MXDfc/ShanghaiTech_EE114-Embedded-Systems/Lab6/WHEELTEC L150 避障巡线雷达小车资料/WHEELTEC L150 避障巡线雷达小车附送资料_V2.8_2025.05.15/1.使用与开发教程视频/4.主板原理图/反面.JPG

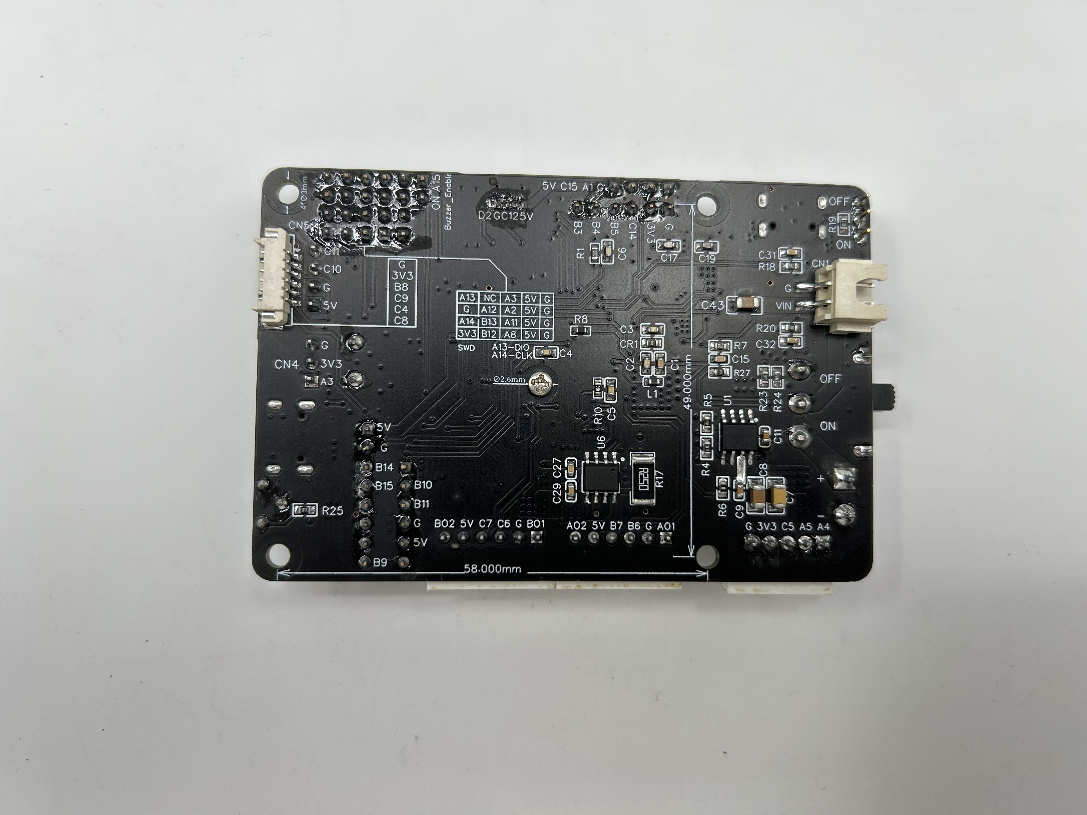
Lab6/WHEELTEC L150 避障巡线雷达小车资料/WHEELTEC L150 避障巡线雷达小车附送资料_V2.8_2025.05.15/1.使用与开发教程视频/4.主板原理图/反面.JPG
