MXDfc/ShanghaiTech_EE114-Embedded-Systems/README.md

# ShanghaiTech_EE114-Embedded-Systems
Class repository for Shanghaitech EE114 Embedded Systems, mainly contain code for labs and flip-class

This repository is built in 2025-2026 schoolyear Spring semester (2026Spring). The author is not responsible for any inapplicability of the code resulting from subsequent course updates.

Most of the code in this repository are created by AI agents. The code is verified useful on actual devices. Information of the devices used in this semester will be updated in related folders.
