MXDfc/ShanghaiTech_EE114-Embedded-Systems/Lab7and8/LAB7-8 BlueTooth.pdf

## Lab：Using Bluetooth to control

## the movement of the car

Install the app on your phone. This app recognizes Bluetooth modules named BT04 or WHEELTEC and connects them.
Experimental content

Students use an app connected to a Bluetooth module to control the movement of the car, which includes forward, backward, turning, and spinning in place.

Firstly, students should ensure a successful Bluetooth connection.

Secondly, it is necessary to ensure the accuracy of PWM control for the driving motor.

Finally, ensure safety before opening the motion control button of the car. Once the car is damaged, it will not be able to complete the subsequent experimental content.

Due to communication delay, please ensure that the small car is not too fast.
