MXDfc/ShanghaiTech_EE114-Embedded-Systems/Basic Data and Slides/slides/Lect9-10_A Complete CPU & 8051 Review.pdf

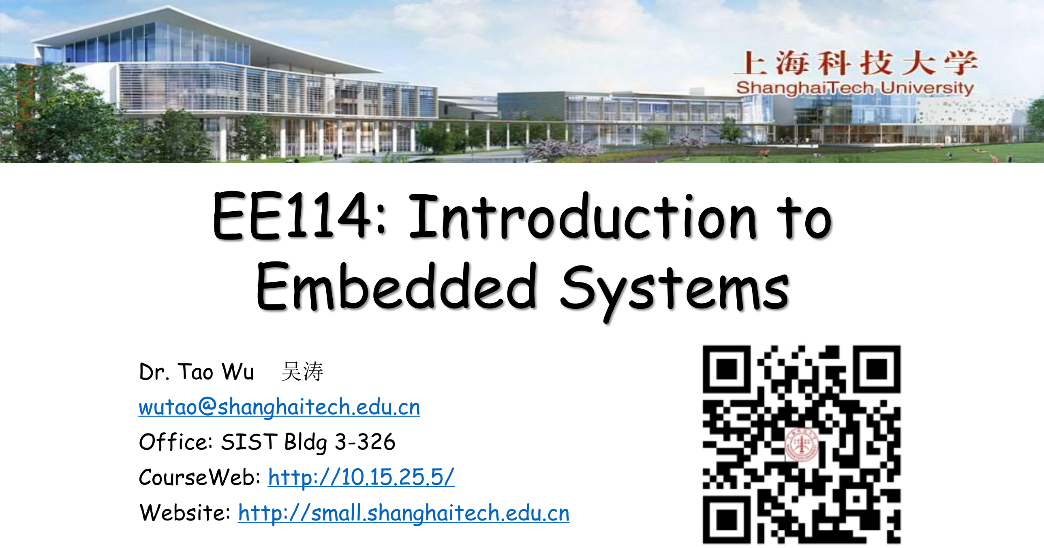
[picture p59: page 1]

EE114 Embedded System -> Lecture 9-10 A Complete CPU & Review

# EE114: Introduction to Embedded Systems

## Dr. Tao Wu 吴涛 wutao@shanghaitech.edu.cn Office: SIST Bldg 3-326 CourseWeb: http://10.15.25.5/ (http://10.15.25.5/EE224_18Fall/Index.htm) Website: http://small.shanghaitech.edu.cn

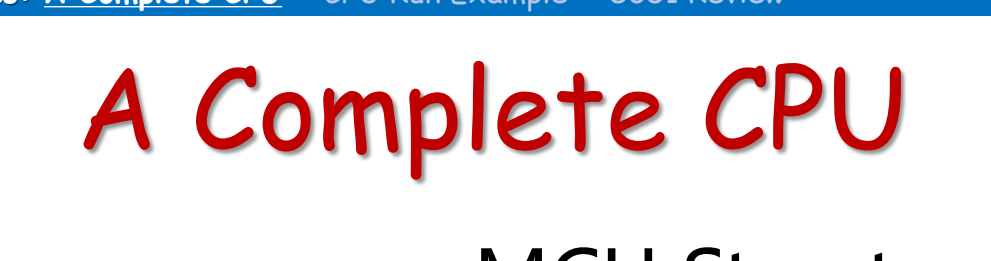
[picture p60: figure]
A Complete CPU

# - MCU Structure

# - The CPU

## - Registers file （寄存器组） - Instruction latch/decode/branch （指令） - Stack（栈） - Interrupt（中断） - Clock/Reset（时钟/复位）

# - Memory - Bus - Peripheral

Progress: A Complete CPU >> CPU Run Example >> 8051 Review

# A Complete CPU – Video 23’

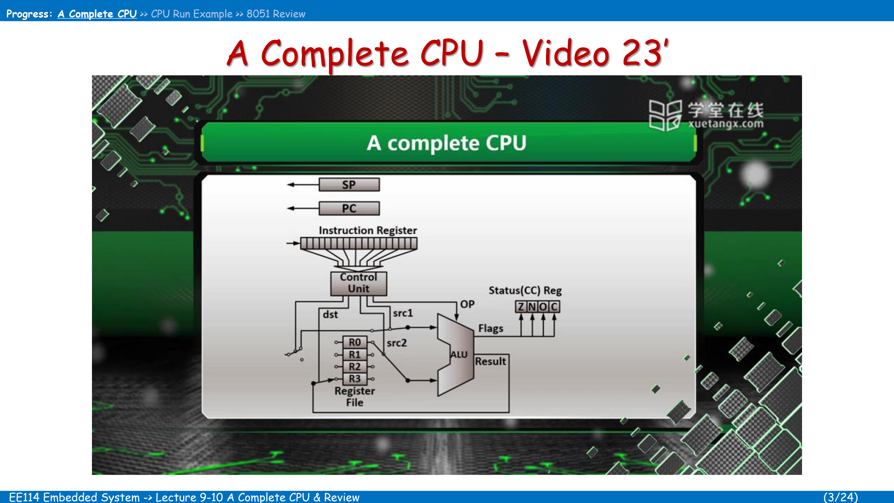
[picture p61: page 3]

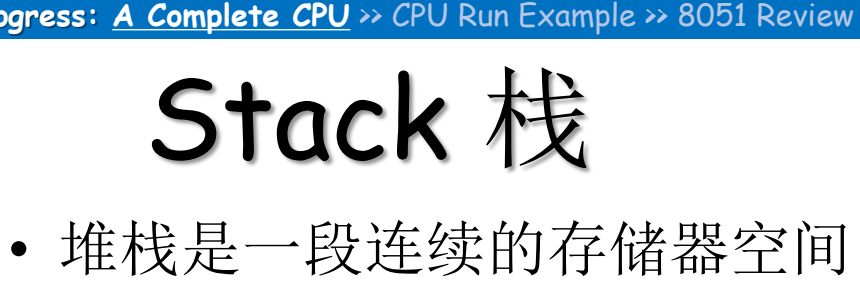
[picture p62: figure]
• 堆栈是一段连续的存储器空间; Stack 栈

## - 堆栈按照后入先出的方式工作(Last In First Out)

## - 只能向/从堆栈的顶部加入或取出数据 - 顶端位置通过堆栈指针寄存器确定(SP，Stack Pointer) - 两种基本的操作方式: 推入PUSH: 将内容加入到堆栈顶端 取出PULL : 将堆栈顶端的内容取出

## - 对于大多数CPU而言，

## “顶端”是指低位的地址空间； 但 8051是向上生长型的堆栈 - 堆栈容量不超过（256-8）字节，单片机复位后SP的值为07H，SP是入栈递增 - 汇编程序可以使用堆栈来保存局部变量，寄存器值 - C语言编译器使用堆栈来完成参数传递和返回值传递 -> C语言的函数调用

## - CPU硬件 使用堆栈 来保存返回地址和寄存器上下文 (register context)

High addr

Low addr

0x13
0x12
0x11
0x10

0x10 is the first pushed item 0x13 is the last pushed item

## TOP

# - 堆Heap：是一个进程开启以后，系统分配给它的空间，一般这个空间是 全局的，系统中所有动态分配的对象（比如指针）都是在这个空间上分 配 。 堆 里 的 数 据 是 有 数 据 结 构 的 ， 其 空 间 占 用 是 不 连 续 的 。 在没有OS的嵌入式系统中，通常不使用堆。

# - 栈Stack：是一个线程维护的一个先进后出的数据结构，主要用于静态 变量的 分配及维护程序各个函数调用时使用。栈里的内容是没有数据结 构的，其空间占用是连续的。栈是微处理器的必要特性，是支持高级语 言编程的前提。

xx
xx
xx
xx
xx

0x1FFB
0x1FFC
0x1FFD
0x1FFE
0x1FFF

SP = undefined
PC = 0x3006
A = 0x34
B = 0x56

0x3005: NOP
0x3006: LDS $2000
0x3008: PSHA
0x3009: PSHB
0x300A: JSR SubFunc
0x300C: PULLA
0x300D: PULLB
SubFunc: 0x4050: NOP
0x4052: RTS

current executed instruction current stack pointer

NOP: no operation, do nothing
LDS : load stack pointer with a value
PSHx: push the contains of register 'x' into stack PULLx: pull from the stack and put in register 'x' JSR : jump to subroutine
RTS : return from subroutine

Register file after this instruction

0x3005: NOP
0x3006: LDS $2000
0x3008: PSHA
0x3009: PSHB
0x300A: JSR SubFunc
0x300C: PULLA
0x300D: PULLB
SubFunc: 0x4050: NOP
0x4052: RTS

xx
xx
xx
xx
xx

0x1FFB
0x1FFC
0x1FFD
0x1FFE
0x1FFF

SP = 0x2000
PC = 0x3008
A = 0x34
B = 0x56

current executed instruction current stack pointer

Register file after this instruction

NOP: no operation, do nothing
LDS : load stack pointer with a value
PSHx: push the contains of register 'x' into stack PULLx: pull from the stack and put in register 'x' JSR : jump to subroutine
RTS : return from subroutine

0x3005: NOP
0x3006: LDS $2000
0x3008: PSHA
0x3009: PSHB
0x300A: JSR SubFunc
0x300C: PULLA
0x300D: PULLB
SubFunc: 0x4050: NOP
0x4052: RTS

xx
xx
xx
xx
0x34

0x1FFB
0x1FFC
0x1FFD
0x1FFE
0x1FFF

SP = 0x1FFF
PC = 0x3009
A = 0x34
B = 0x56

current executed instruction current stack pointer

Register file after this instruction

NOP: no operation, do nothing
LDS : load stack pointer with a value
PSHx: push the contains of register 'x' into stack PULLx: pull from the stack and put in register 'x' JSR : jump to subroutine
RTS : return from subroutine

xx
xx
xx
0x56
0x34

0x1FFB
0x1FFC
0x1FFD
0x1FFE
0x1FFF

SP = 0x1FFE
PC = 0x300A
A = 0x34
B = 0x56

current executed instruction current stack pointer

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

Register file after this instruction

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

xx
0x30
0x0C
0x56
0x34

0x1FFB
0x1FFC
0x1FFD
0x1FFE
0x1FFF

SP = 0x1FFC
PC = 0x4050
A = 0x34
B = 0x56

current executed instruction current stack pointer

Register file after this instruction

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

xx
0x30
0x0C
0x56
0x34

0x1FFB
0x1FFC
0x1FFD
0x1FFE
0x1FFF

SP = 0x1FFC
PC = 0x4052
A = 0x34
B = 0x56

current executed instruction current stack pointer

Register file after this instruction

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

xx
0x30
0x0C
0x56
0x34

0x1FFB
0x1FFC
0x1FFD
0x1FFE
0x1FFF

SP = 0x1FFE
PC = 0x300C
A = 0x34
B = 0x56

current executed instruction current stack pointer

Register file after this instruction

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

xx
0x30
0x0C
0x56
0x34

0x1FFB
0x1FFC
0x1FFD
0x1FFE
0x1FFF

SP = 0x1FFF
PC = 0x300D
A = 0x56
B = 0x56

current executed instruction current stack pointer

Register file after this instruction

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

xx
0x30
0x0C
0x56
0x34

0x1FFB
0x1FFC
0x1FFD
0x1FFE
0x1FFF

SP = 0x2000
PC = 0x300E
A = 0x56
B = 0x34

current executed instruction current stack pointer

Register file after this instruction

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

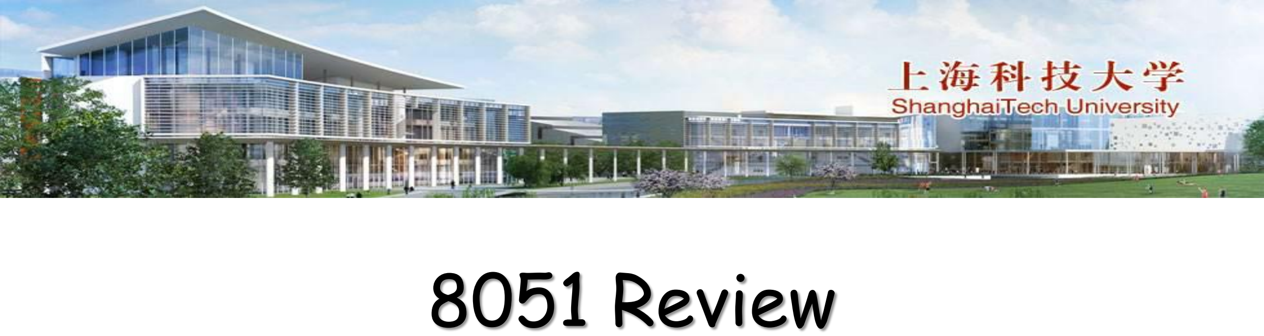
[picture p63: page 15]

# 8051 Review

# MCS-8051单片机主要功能方框图

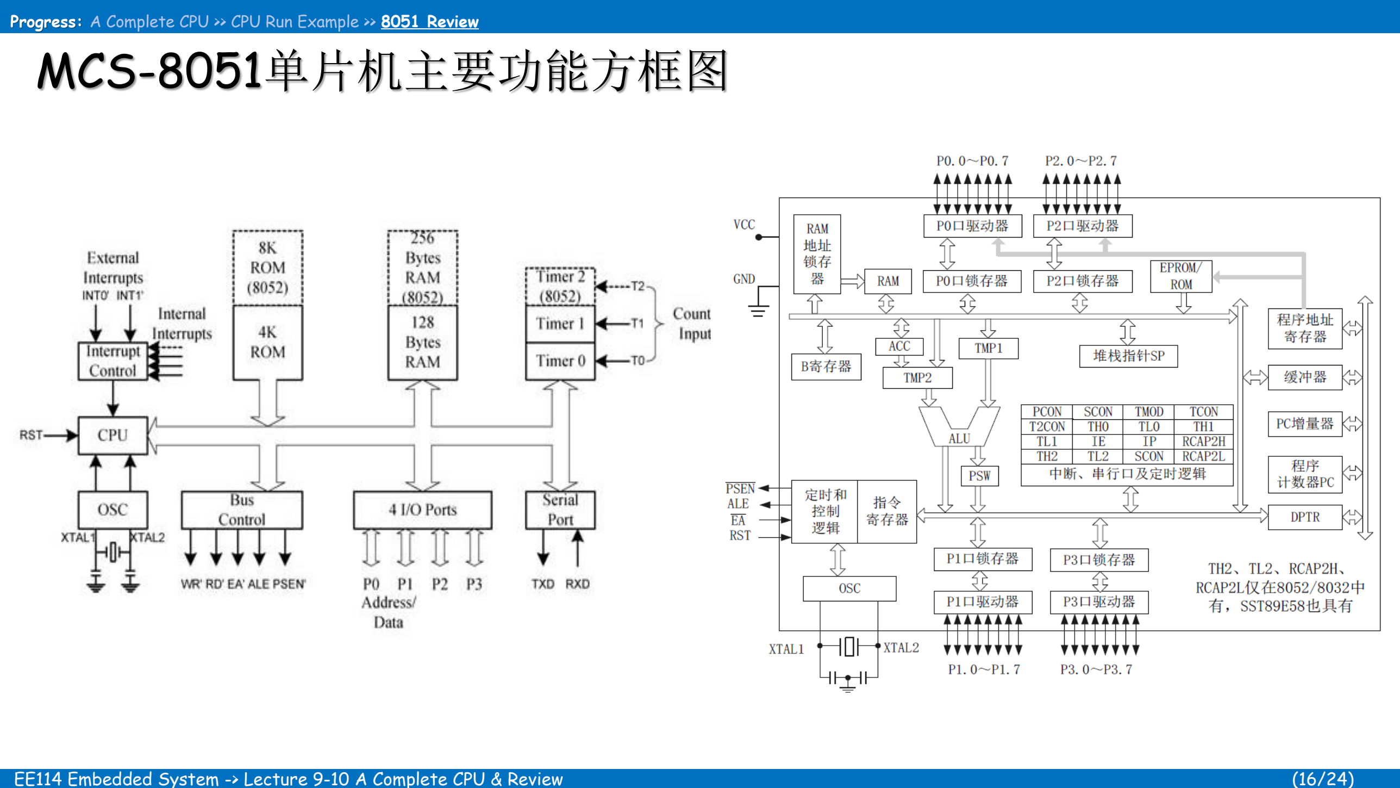
[picture p64: page 16]

# How it runs

## Clock

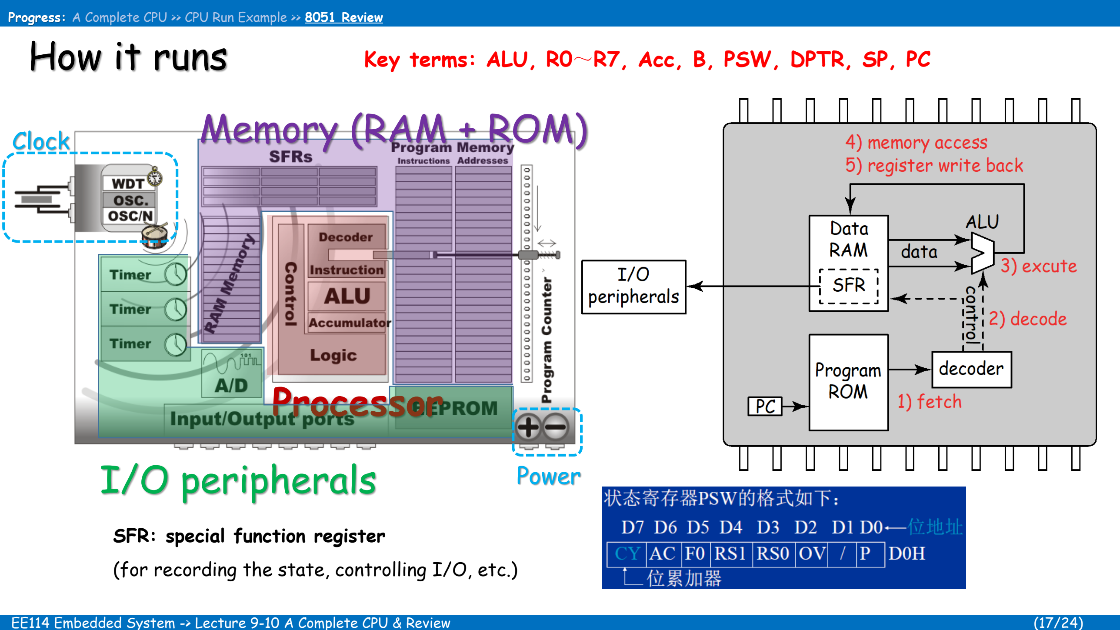
[picture p65: page 17]

SFR: special function register
(for recording the state, controlling I/O, etc.)

## Program statμs word (PSW)

# Processor

# Memory (RAM + ROM)

I/O peripherals | Power

## Key terms: ALU, R0～R7, Acc, B, PSW, DPTR, SP, PC

# - Ports 0 has open-drain outputs

(“true” bidirectional).

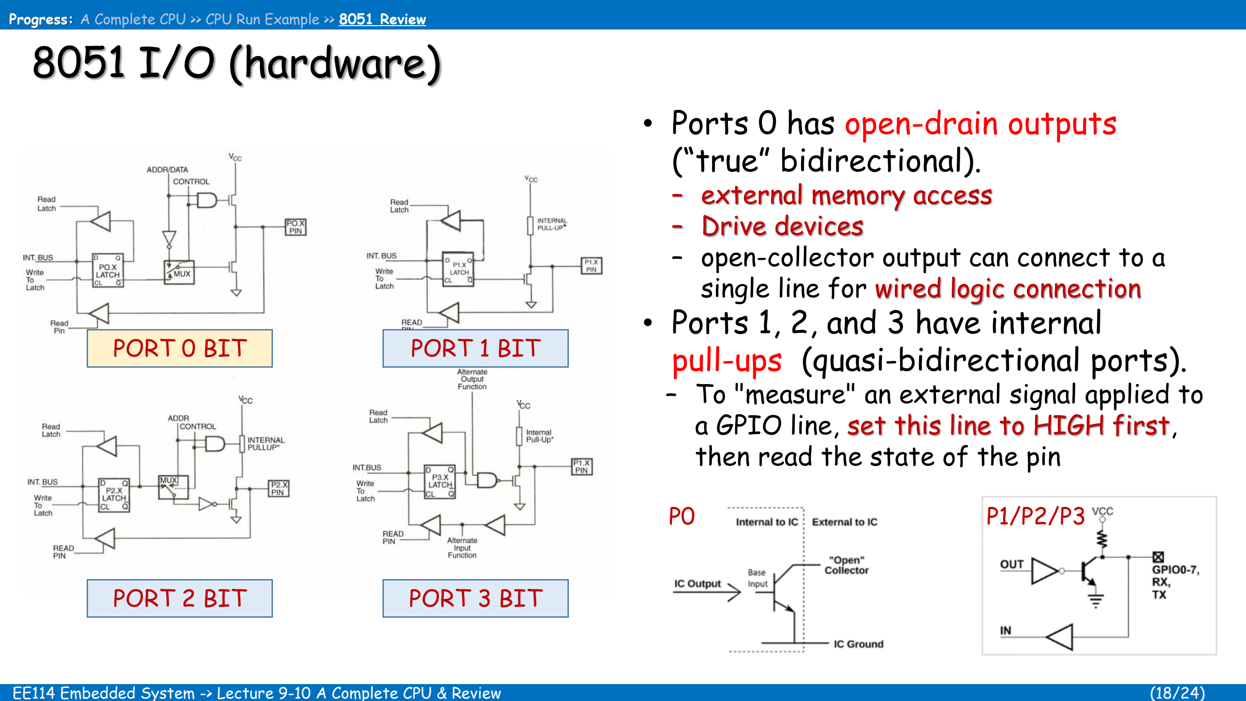
[picture p66: page 18]

## – external memory access – Drive devices – open-collector output can connect to a single line for wired logic connection

# - Ports 1, 2, and 3 have internal

pull-ups (quasi-bidirectional ports).

## – To "measure" an external signal applied to

a GPIO line, set this line to HIGH first,

## then read the state of the pin

# 8051 I/O (hardware)

PORT 0 BIT | PORT 1 BIT
PORT 2 BIT | PORT 3 BIT
P0 | P1/P2/P3

# 8051 Memory Mapping

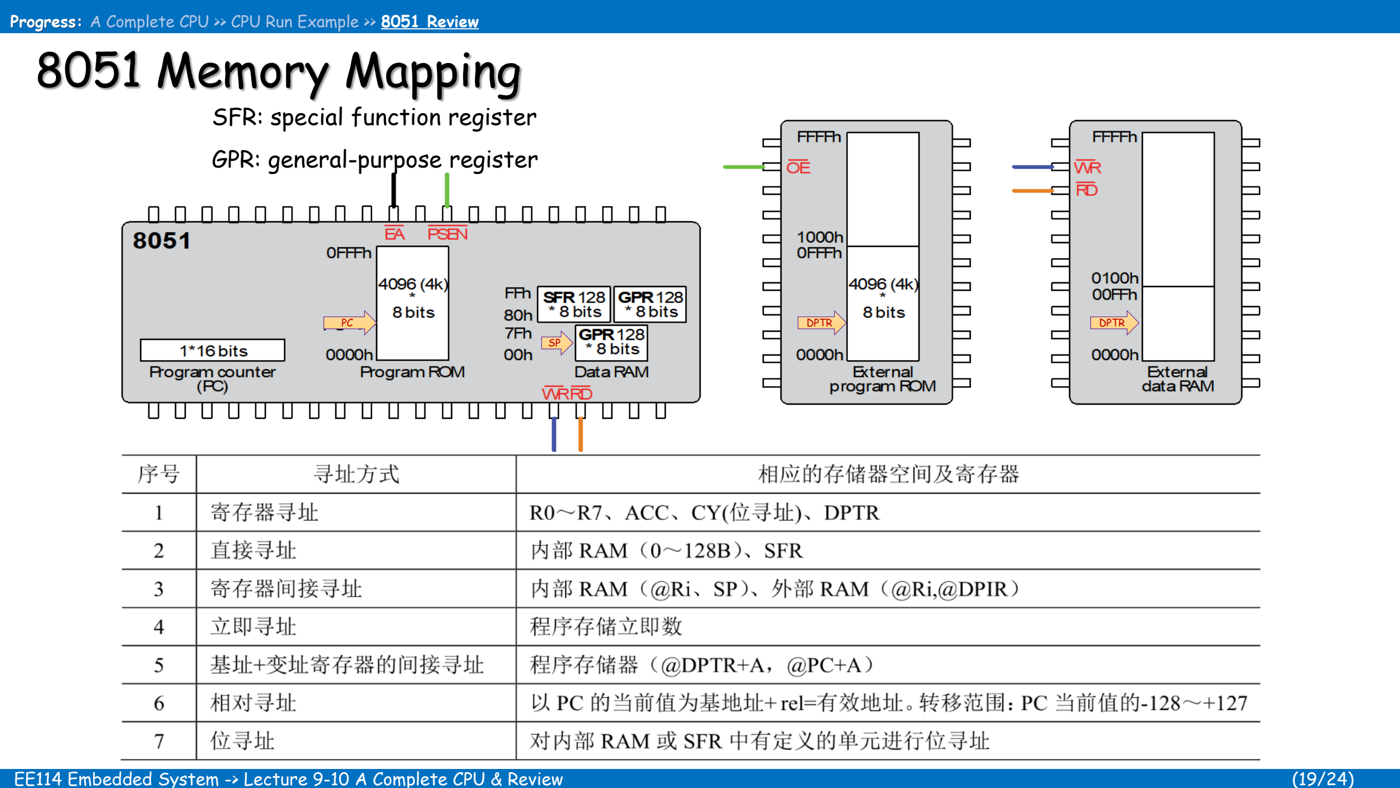
[picture p67: page 19]

SFR: special function register GPR: general-purpose register

PC

SP

DPTR | DPTR

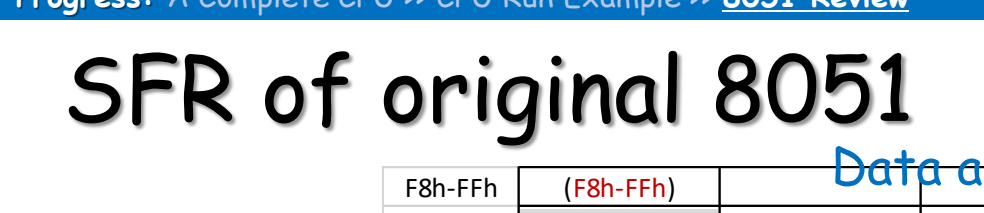
[picture p68: figure]
F8h-FFh; (F8h-FFh); SFR of original 8051

F0h-F7H | B (F0h-F7H)
E8h-EFh | (E8h-EFh) | | | CPU
E0h-E7h | ACC (E0h-E7h)
D8h-DFh | (D8h-DFh) | | Interrupt control
D0h-D7h | PSW (D0h-D7h)
C8h-CFh | (C8h-CFh) | | | I/O ports
C0h-C7h | (C0h-C7h)
B8h-BFh | IP (B8h-BFh) | | | UART
B0h-B7h | P3 (B0h-B7h)
A8h-AFh | IE (A8h-AFh) | | | Timers
A0h-A7h | P2 (A0h-A7h)
98h-9Fh | SCON (98h-9Fh) | SBUF
90h-97h | P1 (90h-97h)
88h-8Fh | TCON (88h-8Fh) | TMOD | TL0 | TL1 | TH0 | TH1
80h-87h | P0 (80h-87h) | SP | DPL | DPH | | | | PCON PCON

30h-7Fh

20h-2Fh | 40h-47h | 48h-4Fh | 50h-57h | 58h-5Fh | 60h-67h | 68h-6Fh | 70h-77h | 78h-7Fh
| 00h-07h | 08-0Fh | 10h-17h | 18h-1Fh | 20h-27h | 28-2Fh | 30h-37h | 38h-3Fh
18h-1Fh | R0 | R1 | R2 | R3 | R4 | R5 | R6 | R7 | Bank 3
10h-17h | R0 | R1 | R2 | R3 | R4 | R5 | R6 | R7 | Bank 2
08h-0Fh | R0 | R1 | R2 | R3 | R4 | R5 | R6 | R7 | Bank 1
00h-07h | R0 | R1 | R2 | R3 | R4 | R5 | R6 | R7 | Bank 0

128
SFR

80
General
purpose
registers

16 bit-addressable

## Data and stack pointers

Red address: bit addresses Black address: byte addresses

# Connecting external RAM/ROM

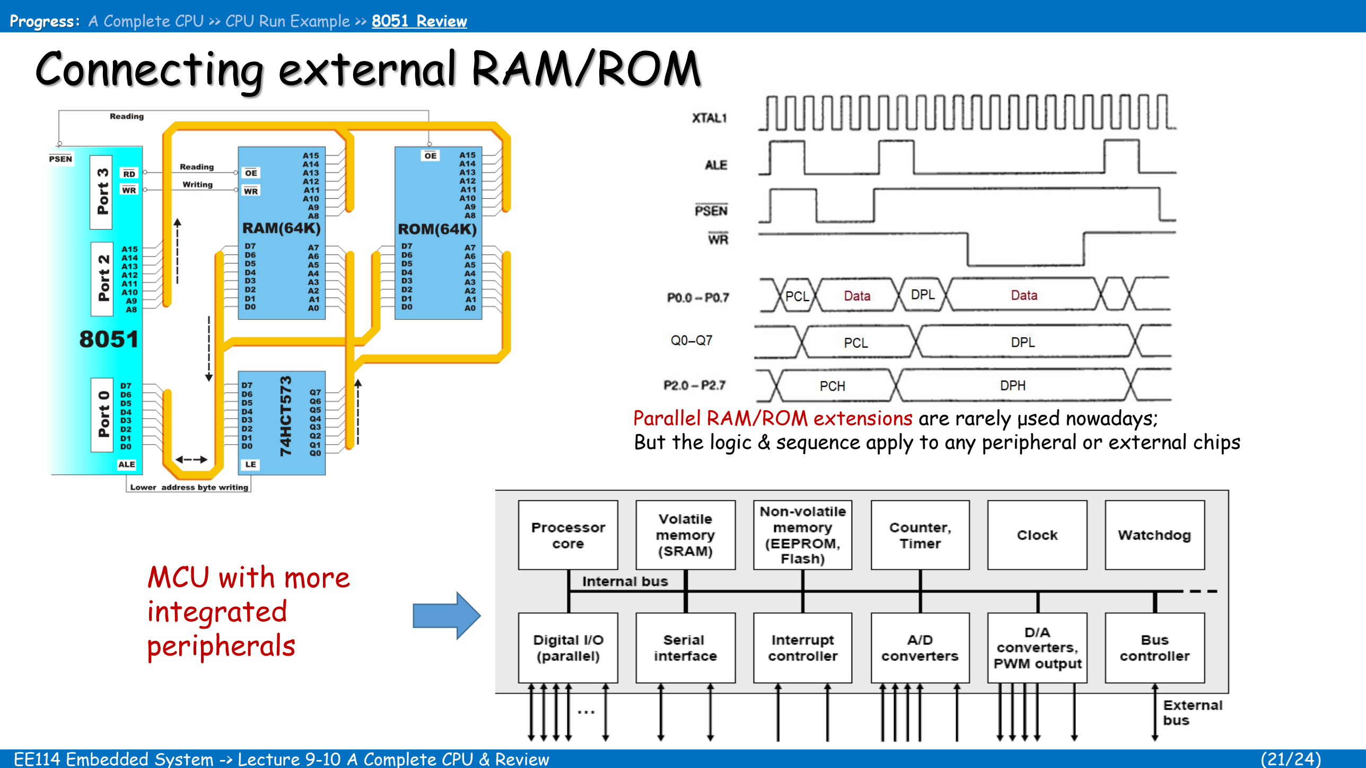
[picture p69: page 21]

Parallel RAM/ROM extensions are rarely μsed nowadays;
But the logic & sequence apply to any peripheral or external chips

## MCU with more integrated peripherals

# - There are two 16 bits timers/counters in 8051

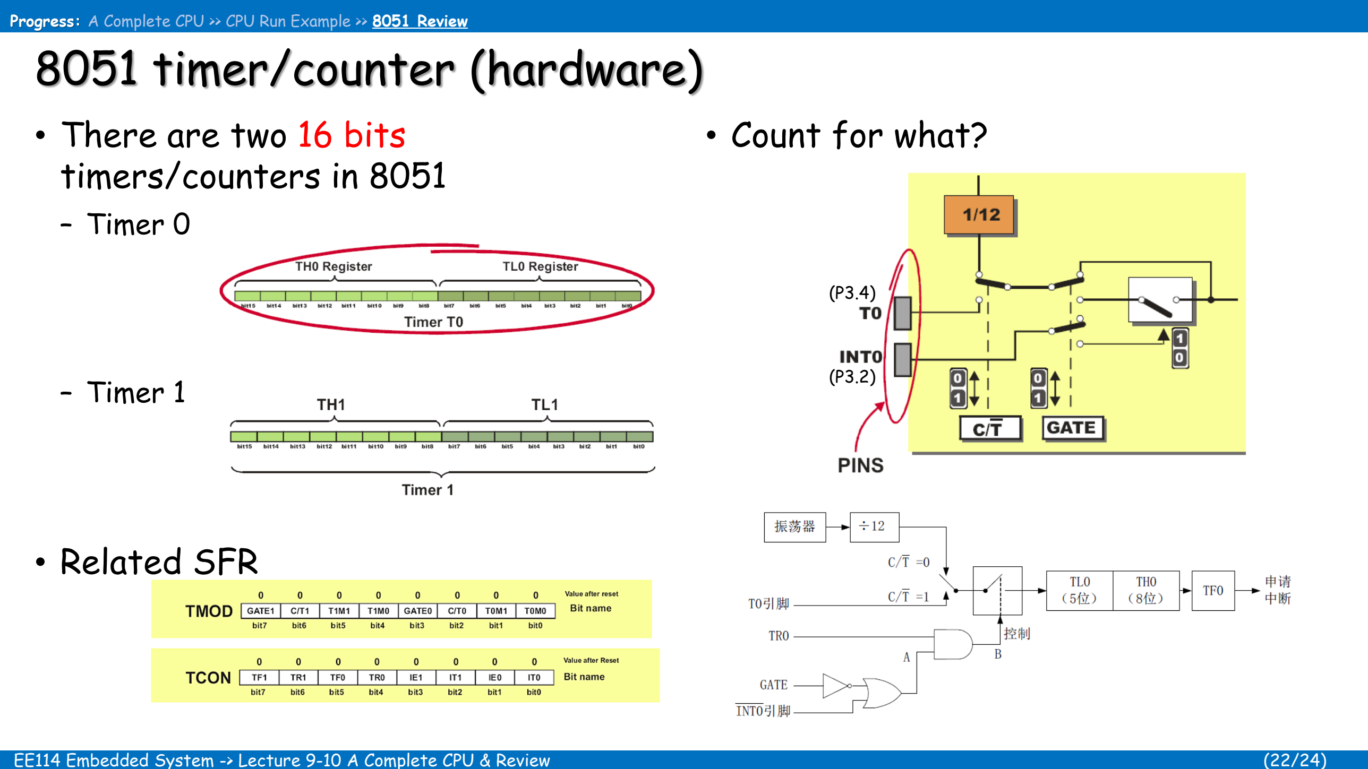
[picture p70: page 22]

## – Timer 0

## – Timer 1

# - Related SFR

# - Count for what?

# 8051 timer/counter (hardware)

(P3.2)

(P3.4)

# 8051 interrupts (hardware)

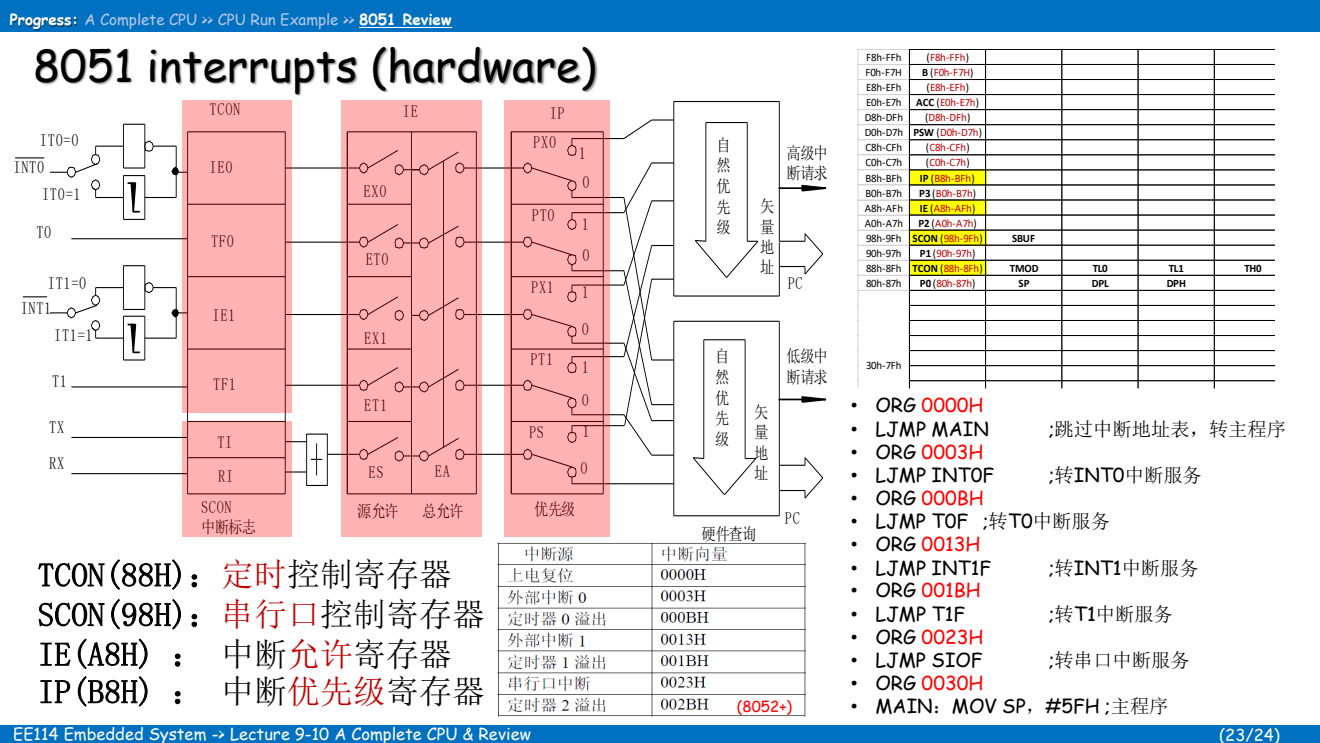
[picture p71: page 23]
高级中 断请求; 断请求; 低级中; SCON 中断标志; TCON; INT1; INT0; 源允许; 总允许; 优先级; 硬件查询; F8h-FFh; (F8h-FFh); E8h-EFh; (E8h-EFh); ACC (E0h-E7h); D8h-DFh; (D8h-DFh); PSW (D0h-D7h); C8h-CFh; (C8h-CFh); B8h-BFh; IP (B8h-BFh); A8h-AFh; IE (A8h-AFh); SCON (98h-9Fh); SBUF; TCON (88h-8Fh); TMOD; DPL; DPH; • ORG 0000H; • LJMP MAIN; ;跳过中断地址表，转主程序; • ORG 0003H; • LJMP INT0F; ;转INT0中断服务; • ORG 000BH • LJMP T0F ;转T0中断服务 • ORG 0013H; • LJMP INT1F; ;转INT1中断服务; • ORG 001BH; • LJMP T1F; ;转T1中断服务; • ORG 0023H; • LJMP SIOF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

## - Wired communication – Parallel: CPU and RAM

# Communication Summary

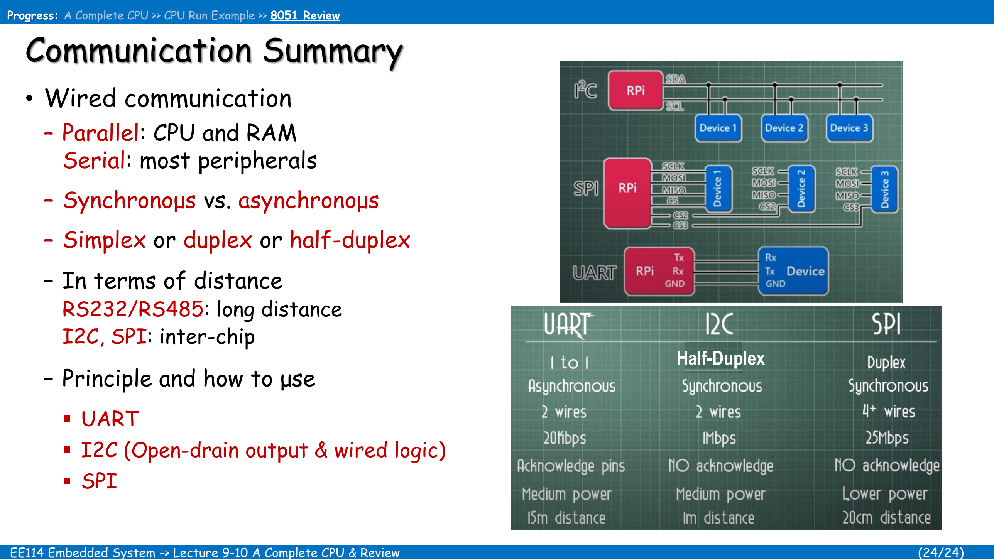
[picture p72: page 24]

EE114 Embedded System

-> Lecture 9

-10 A Complete CPU & Review

## Serial: most peripherals

## – Synchrono

μ

## s vs. asynchrono

μ

s

## – Simplex or duplex or half

## -duplex

## – In terms of distance

## RS232/RS485: long distance I2C, SPI: inter

## -chip

## – Principle and how to

## μse

## - UART ▪ I2C (Open -drain output & wired logic) - SPI

Half

-Duplex
