MXDfc/ShanghaiTech_EE114-Embedded-Systems/Lab2and3/Device Data/AI语音交互/3.芯片资料&技术参数/2.技术参数/一体式语音交互模块技术参数.pdf

# 一体式语音交互模块技术参数

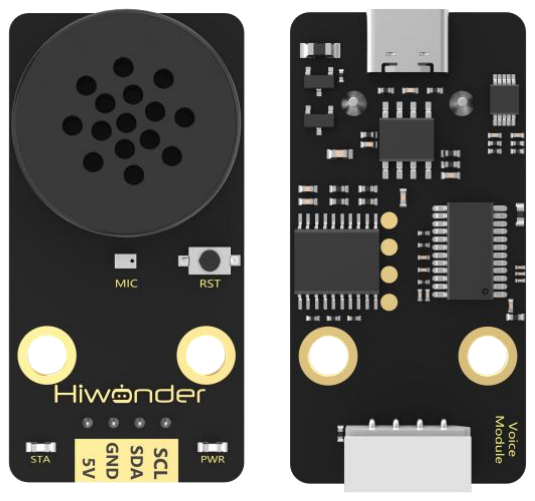
[picture p107: figure]

产品尺寸 | 48*24*10.5mm | 产品重量 | 10g
语音芯片型号 | CI1302 | IIC 接口 | 1 个
Type-C 串口 | 1 个 | 工作电压 | 5V
CPU 主频 | 可达 220MHz | RAM 容量 | 640KByte
FLASH 容量 | 2MByte | 工作温度 | 常温
