MXDfc/ShanghaiTech_EE114-Embedded-Systems/Lab4and5/Device Data/LAB4-5 MPU6050(1)/LAB4-5 MPU6050/姿态传感器资料/四元数与欧拉角的转换.pdf

四元数与欧拉角（Yaw、Pitch、Roll）的转换
目录

0、简介

### 一、四元数的定义 二、欧拉角到四元数的转换

2.1 公式：
2.2 code:

### 三、四元数到欧拉角的转换

3.1 公式
3.2 code:

### 3.3 四元素到旋转矩阵转换 四. 奇点 五. 矢量旋转

证明：

### 六 . 其他参考

七 python 转换

### 7.1 四元素欧拉角互相转换

7.2 旋转矩阵<->欧拉角 py
八 Eigen transform

### 8.1 欧拉角到四元素 四元素得到yaw 四元素到旋转向量 旋转轴向量到四元素

Eigen 转换函数

### 九 旋转矩阵与欧拉角

0、简介

四元数与欧拉角之间的转换 (https://en.wikipedia.org/wiki/Conversion_between_quaternions_and_Euler_angles)

### 百度百科四元素 (http://baike.baidu.com/link)

在3D图形学中，最常用的旋转表示方法便是四元数和 欧拉角 (https://so.csdn.net/so/search?q=%E6%AC%A7%E6%8B%89%E8%A7%92&spm=1001.2101.3001.7020) ，比起矩阵来具有节省存储空间和方

### 便插值的优点。

### 本文主要归纳了两种表达方式的转换，计算公式采用3D笛卡尔坐标系：

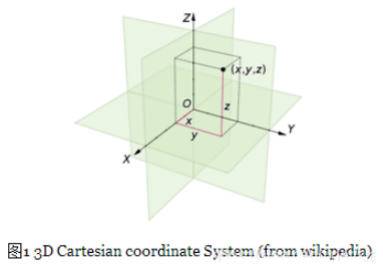
[picture p108: figure]

### 定义 ， ， 分别为绕Z轴、Y轴、X轴的旋转角度，如果用Tait-Bryan angle表示，分别为Yaw、

Pitch、Roll。

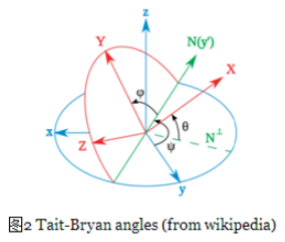
[picture p109: figure]

# 一、四元数的定义

### 通过旋转轴和绕该轴旋转的角度可以构造一个四元数：

### 利用欧拉角也可以实现一个物体在空间的旋转，它按照既定的顺序，如依次绕z,y,x分别旋转一个固 定角度，使用yaw，pitch，roll分别表示物体绕,x,y,z的旋转角度，记为 ， ， ，可以利用三个四元 数依次表示这三次旋转，即：

# 二、欧拉角到四元数的转换

# 2.1 公式：

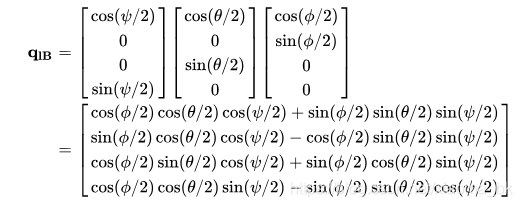
[picture p110: figure]

# 2.2 code:

struct Quaternion
{
double w, x, y, z;
};

Quaternion ToQuaternion(double yaw, double pitch, double roll) // yaw (Z), pitch (Y) {
// Abbreviations for the various angular functions
double cy = cos(yaw * 0.5);
double sy = sin(yaw * 0.5);
double cp = cos(pitch * 0.5);
double sp = sin(pitch * 0.5); double cr = cos(roll * 0.5); double sr = sin(roll * 0.5);

Quaternion q;
q.w = cy * cp * cr + sy * sp * sr; q.x = cy * cp * sr - sy * sp * cr;

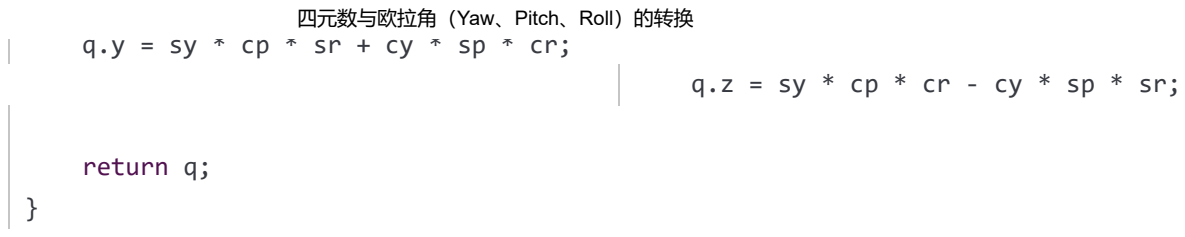
[picture p111: figure]
return q;

# 三、四元数到欧拉角的转换

# 3.1 公式

### 可以从四元数通过以下关系式获得欧拉角：

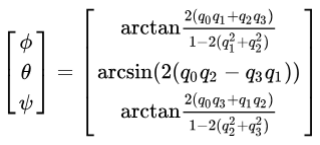
[picture p112: figure]

arctan和arcsin的结果是 | ，这并不能覆盖所有朝向(对于 角 | 的取值范围已经满

# 3.2 code:

#define _USE_MATH_DEFINES

#include <cmath>

struct Quaternion {
double w, x, y, z;
};

struct EulerAngles {
double roll, pitch, yaw;
};

EulerAngles ToEulerAngles(Quaternion q) { EulerAngles angles;

3.3 四元素到旋转矩阵 (https://so.csdn.net/so/search?q=%E6%97%8B%E8%BD%AC%E7%9F%A9%E9%98%B5&spm=1001.2101.3001.7020) 转换

### 或等效地，通过齐次表达式：

# 四. 奇点

### 当螺距接近±90°（南北极）时，必须意识到欧拉角参数化的奇异性。这些情况必须特别处理。这种 情况的通用名称是万向节锁。

处理奇异点的代码可从以下网站获取：www.euclideanspace.com

# 五. 矢量旋转

### 定义四元素的尺度 和向量 ，有

// roll (x-axis rotation)
double sinr_cosp = 2 * (q.w * q.x + q.y * q.z); double cosr_cosp = 1 - 2 * (q.x * q.x + q.y * q.y); angles.roll = std::atan2(sinr_cosp, cosr_cosp);

// pitch (y-axis rotation)
double sinp = 2 * (q.w * q.y - q.z * q.x);
if (std::abs(sinp) >= 1)
angles.pitch = std::copysign(M_PI / 2, sinp); // use 90 degrees if out of ra else
angles.pitch = std::asin(sinp);

// yaw (z-axis rotation)
double siny_cosp = 2 * (q.w * q.z + q.x * q.y); double cosy_cosp = 1 - 2 * (q.y * q.y + q.z * q.z); angles.yaw = std::atan2(siny_cosp, cosy_cosp);

return angles;
}

### 请注意，通过定义欧拉旋转的四元数 来旋转三维矢量 的规范方法是通过公式：

这儿： | 是包含嵌入向量 的四元数，
是共轭四元数， (https://en.wikipedia.org/wiki/Quaternion#Conjugation.2C_the_norm.2C_and_reciprocal)

### 在计算实现中，这需要两个四元数乘法。一种替代方法是应用一对关系：

### ：表示三维矢量叉积。这涉及较少的乘法，因此计算速度更快。数值测试表明，对于矢量旋转，后 一种方法可能比原始方法快30％[4]。

证明：

### 标量和矢量部分的四元数乘法的一般规则由下式给出：

利用这种关系 | 可以找到：

### 并替换为三乘积：

### 可得到：

在定义 | 时，可以按标量和矢量部分来表示：

# 六 . 其他参考

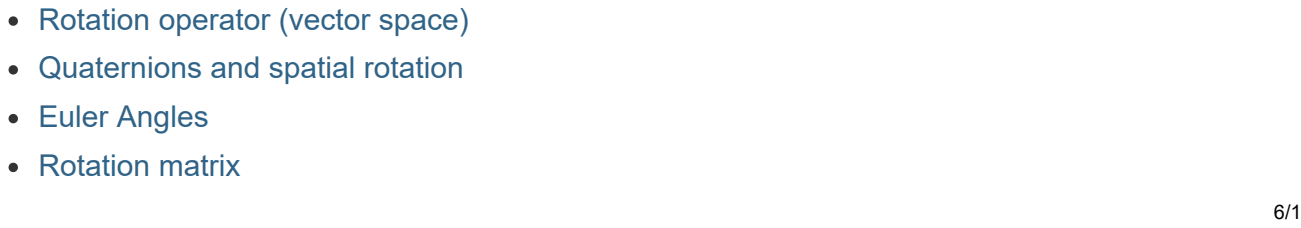
[picture p113: figure]
Rotation operator (vector space) Quaternions and spatial rotation Euler Angles Rotation matrix

# 七 python 转换

# 7.1 四元素欧拉角互相转换

def EulerAndQuaternionTransform( intput_data): """
四元素与欧拉角互换
"""
data_len = len(intput_data) angle_is_not_rad = False

if data_len == 3:
r = 0
p = 0
y = 0
if angle_is_not_rad: # 180 ->pi
r = math.radians(intput_data[0]) p = math.radians(intput_data[1]) y = math.radians(intput_data[2]) else:
r = intput_data[0]
p = intput_data[1]
y = intput_data[2]

sinp = math.sin(p/2)
siny = math.sin(y/2)
sinr = math.sin(r/2)

cosp = math.cos(p/2)
cosy = math.cos(y/2)
cosr = math.cos(r/2)

w = cosr*cosp*cosy + sinr*sinp*siny x = sinr*cosp*cosy - cosr*sinp*siny y = cosr*sinp*cosy + sinr*cosp*siny z = cosr*cosp*siny - sinr*sinp*cosy return [w,x,y,z]

elif data_len == 4:

w = intput_data[0]
x = intput_data[1]
y = intput_data[2]
z = intput_data[3]

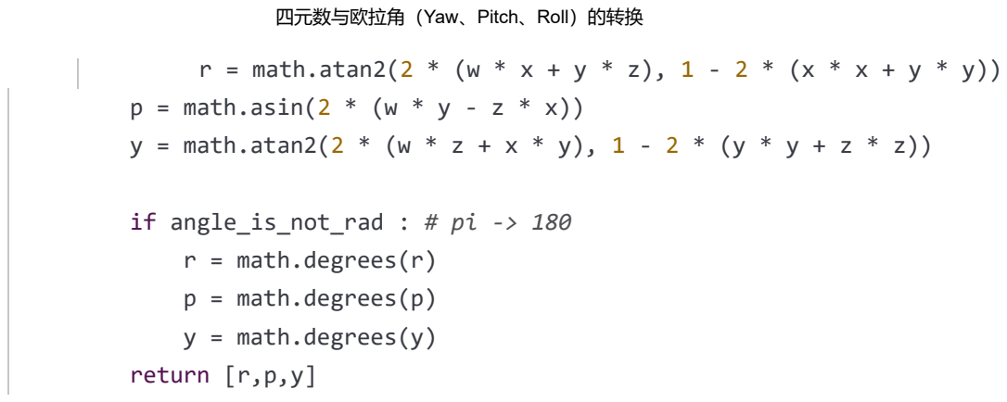
[picture p114: figure]
p = math.asin(2 * (w * y - z * x)); if angle_is_not_rad : # pi -> 180 r = math.degrees(r) p = math.degrees(p) y = math.degrees(y) return [r,p,y]

# 7.2 旋转矩阵<->欧拉角 py

r = math.atan2(2 * (w * x + y * z), 1 - 2 * (x * x + y * y))

y = math.atan2(2 * (w * z + x * y), 1 - 2 * (y * y + z * z))

import numpy as np
import math
import random

def isRotationMatrix(R) :
Rt = np.transpose(R)
shouldBeIdentity = np.dot(Rt, R)
I = np.identity(3, dtype = R.dtype)
n = np.linalg.norm(I - shouldBeIdentity) return n < 1e-6

def rotationMatrixToEulerAngles(R) :

assert(isRotationMatrix(R))
sy = math.sqrt(R[0,0] * R[0,0] + R[1,0] * R[1,0]) singular = sy < 1e-6

if not singular :
x = math.atan2(R[2,1] , R[2,2]) y = math.atan2(-R[2,0], sy)
z = math.atan2(R[1,0], R[0,0]) else :
x = math.atan2(-R[1,2], R[1,1]) y = math.atan2(-R[2,0], sy)
z = 0

return np.array([x, y, z])

def eulerAnglesToRotationMatrix(theta) :

R_x = np.array([[1, | 0, | 0 | ],
[0, | math.cos(theta[0]), -math.sin(theta[0]) ],

四元数与欧拉角（Yaw、Pitch、Roll）的转换_ | _ | _

c++:

])

R_y = np.array([[math.cos(theta[1]), 0, | math.sin(theta[1]) ],
[0, | 1, | 0 | ],
[-math.sin(theta[1]), 0, | math.cos(theta[1]) ]
])

R_z = np.array([[math.cos(theta[2]), -math.sin(theta[2]), 0],
[math.sin(theta[2]), math.cos(theta[2]), | 0],
[0, | 0, | 1]
])

R = np.dot(R_z, np.dot( R_y, R_x ))

return R

[0, math.sin(theta[0]), math.cos(theta[0]) ]

static Eigen::Vector3d R2ypr(const Eigen::Matrix3d &R) {
Eigen::Vector3d n = R.col(0);
Eigen::Vector3d o = R.col(1);
Eigen::Vector3d a = R.col(2);

Eigen::Vector3d ypr(3);
double y = atan2(n(1), n(0));
double p = atan2(-n(2), n(0) * cos(y) + n(1) * sin(y));
double r = atan2(a(0) * sin(y) - a(1) * cos(y), -o(0) * sin(y) + o(1) * cos( ypr(0) = y;
ypr(1) = p;
ypr(2) = r;

return ypr / M_PI * 180.0; }

template <typename Derived>
static Eigen::Matrix<typename Derived::Scalar, 3, 3> ypr2R(const Eigen::MatrixBa {
typedef typename Derived::Scalar Scalar_t;

Scalar_t y = ypr(0) / 180.0 * M_PI; Scalar_t p = ypr(1) / 180.0 * M_PI; Scalar_t r = ypr(2) / 180.0 * M_PI;

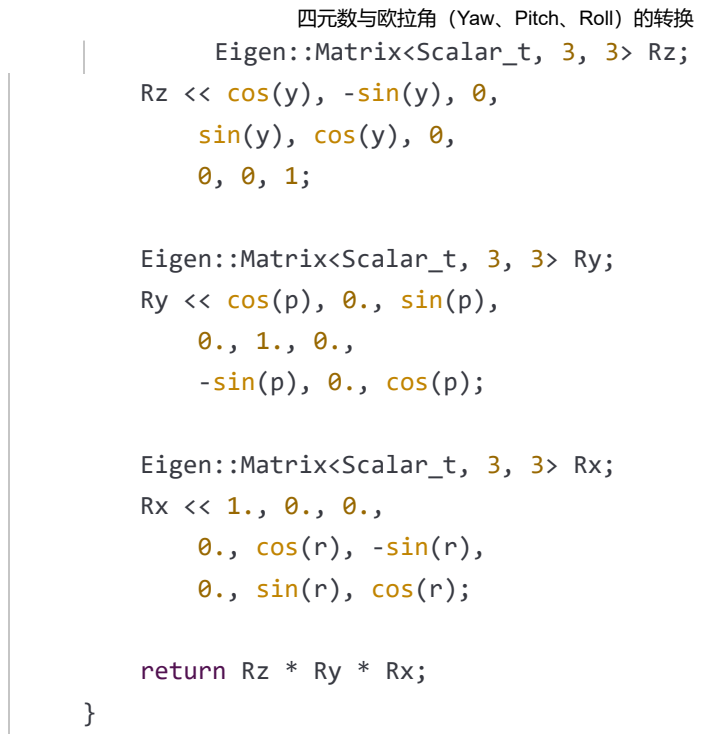
[picture p115: figure]
Eigen::Matrix<Scalar_t, 3, 3> Rz; Rz << cos(y), -sin(y), 0, sin(y), cos(y), 0, 0, 0, 1;; Eigen::Matrix<Scalar_t, 3, 3> Ry; Ry << cos(p), 0., sin(p), 0., 1., 0., -sin(p), 0., cos(p);; Eigen::Matrix<Scalar_t, 3, 3> Rx; Rx << 1., 0., 0., 0., cos(r), -sin(r), 0., sin(r), cos(r);; return Rz * Ry * Rx;

# 八 Eigen transform

## 8.1 欧拉角到四元素

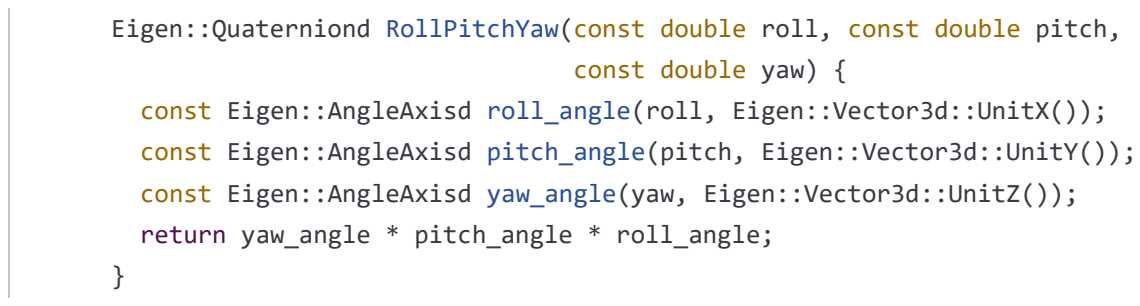
[picture p116: figure]
const double yaw) {

## 四元素得到yaw

## 四元素到旋转向量

Eigen::Quaterniond RollPitchYaw(const double roll, const double pitch,

const Eigen::AngleAxisd roll_angle(roll, Eigen::Vector3d::UnitX()); const Eigen::AngleAxisd pitch_angle(pitch, Eigen::Vector3d::UnitY()); const Eigen::AngleAxisd yaw_angle(yaw, Eigen::Vector3d::UnitZ()); return yaw_angle * pitch_angle * roll_angle;

template <typename T>
T GetYaw(const Eigen::Quaternion<T>& rotation) { const Eigen::Matrix<T, 3, 1> direction = rotation * Eigen::Matrix<T, 3, 1>::UnitX(); return atan2(direction.y(), direction.x());
}

## 旋转轴向量到四元素

template <typename T>
Eigen::Matrix<T, 3, 1> RotationQuaternionToAngleAxisVector(
const Eigen::Quaternion<T>& quaternion) {
Eigen::Quaternion<T> normalized_quaternion = quaternion.normalized();
// We choose the quaternion with positive 'w', i.e., the one with a smaller // angle that represents this orientation.
if (normalized_quaternion.w() < 0.) {
// Multiply by -1. http://eigen.tuxfamily.org/bz/show_bug.cgi?id=560normalized_quaternion.w() = -1. * normalized_quaternion.w(); normalized_quaternion.x() = -1. * normalized_quaternion.x(); normalized_quaternion.y() = -1. * normalized_quaternion.y(); normalized_quaternion.z() = -1. * normalized_quaternion.z();
}
// We convert the normalized_quaternion into a vector along the rotation axi // with length of the rotation angle.
const T angle =
2. * atan2(normalized_quaternion.vec().norm(), normalized_quaternion.w()); constexpr double kCutoffAngle = 1e-7; // We linearize below this angle. const T scale = angle < kCutoffAngle ? T(2.) : angle / sin(angle / 2.); return Eigen::Matrix<T, 3, 1>(scale * normalized_quaternion.x(),
scale * normalized_quaternion.y(), scale * normalized_quaternion.z()); }

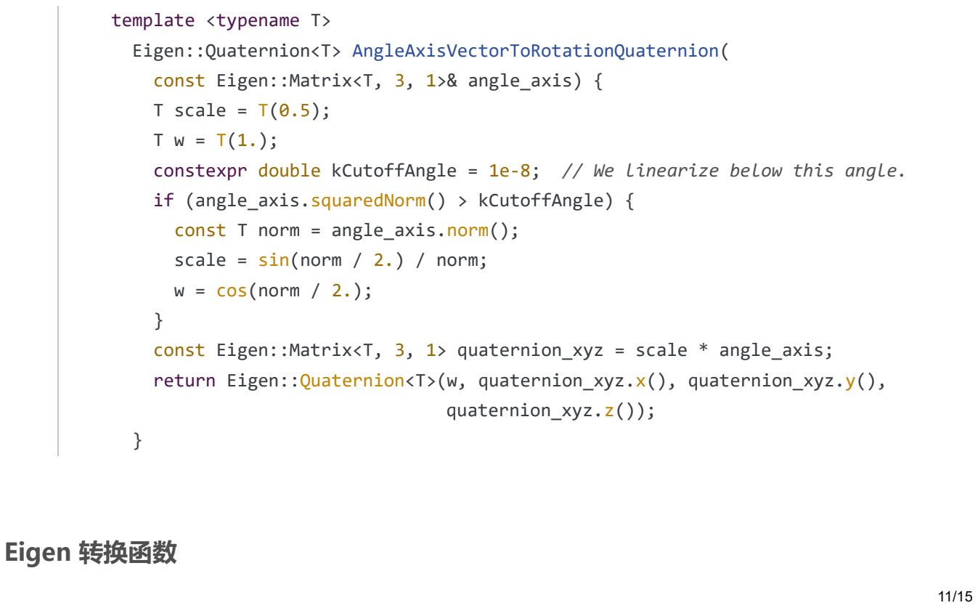
[picture p117: figure]
Eigen 转换函数; template <typename T>; T scale = T(0.5); T w = T(1.);; const T norm = angle_axis.norm(); scale = sin(norm / 2.) / norm; w = cos(norm / 2.);; quaternion_xyz.z());

Eigen::Quaternion<T> AngleAxisVectorToRotationQuaternion( const Eigen::Matrix<T, 3, 1>& angle_axis) {

constexpr double kCutoffAngle = 1e-8; // We linearize below this angle. if (angle_axis.squaredNorm() > kCutoffAngle) {

const Eigen::Matrix<T, 3, 1> quaternion_xyz = scale * angle_axis; return Eigen::Quaternion<T>(w, quaternion_xyz.x(), quaternion_xyz.y(),

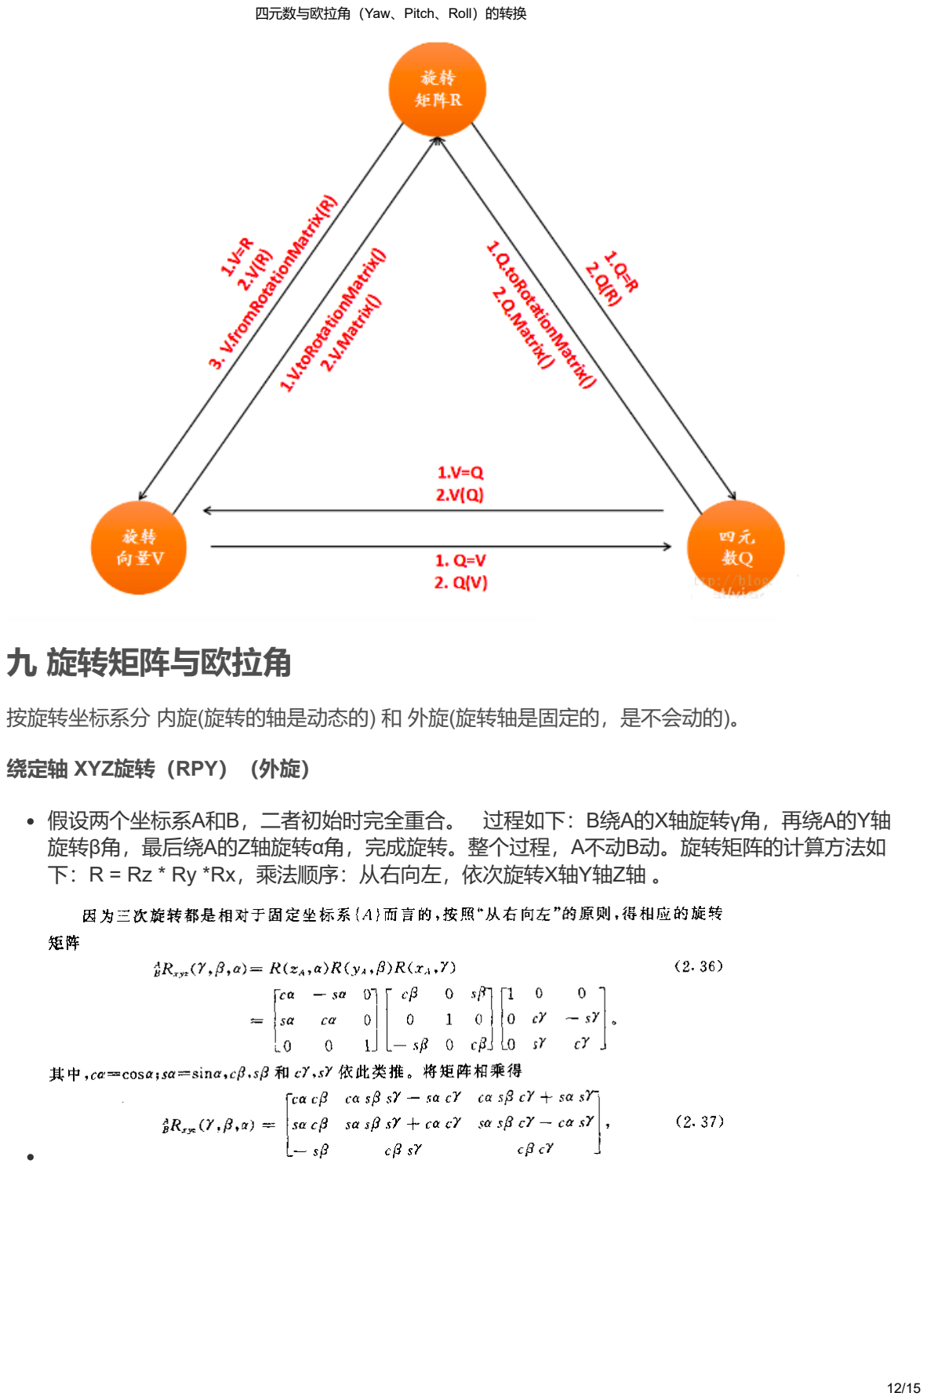
[picture p118: page 12]

# 九 旋转矩阵与欧拉角

### 按旋转坐标系分 内旋(旋转的轴是动态的) 和 外旋(旋转轴是固定的，是不会动的)。

### 绕定轴 XYZ旋转（RPY）（外旋）

### 假设两个坐标系A和B，二者初始时完全重合。 过程如下：B绕A的X轴旋转γ角，再绕A的Y轴 旋转β角，最后绕A的Z轴旋转α角，完成旋转。整个过程，A不动B动。旋转矩阵的计算方法如 下：R = Rz * Ry *Rx，乘法顺序：从右向左，依次旋转X轴Y轴Z轴 。

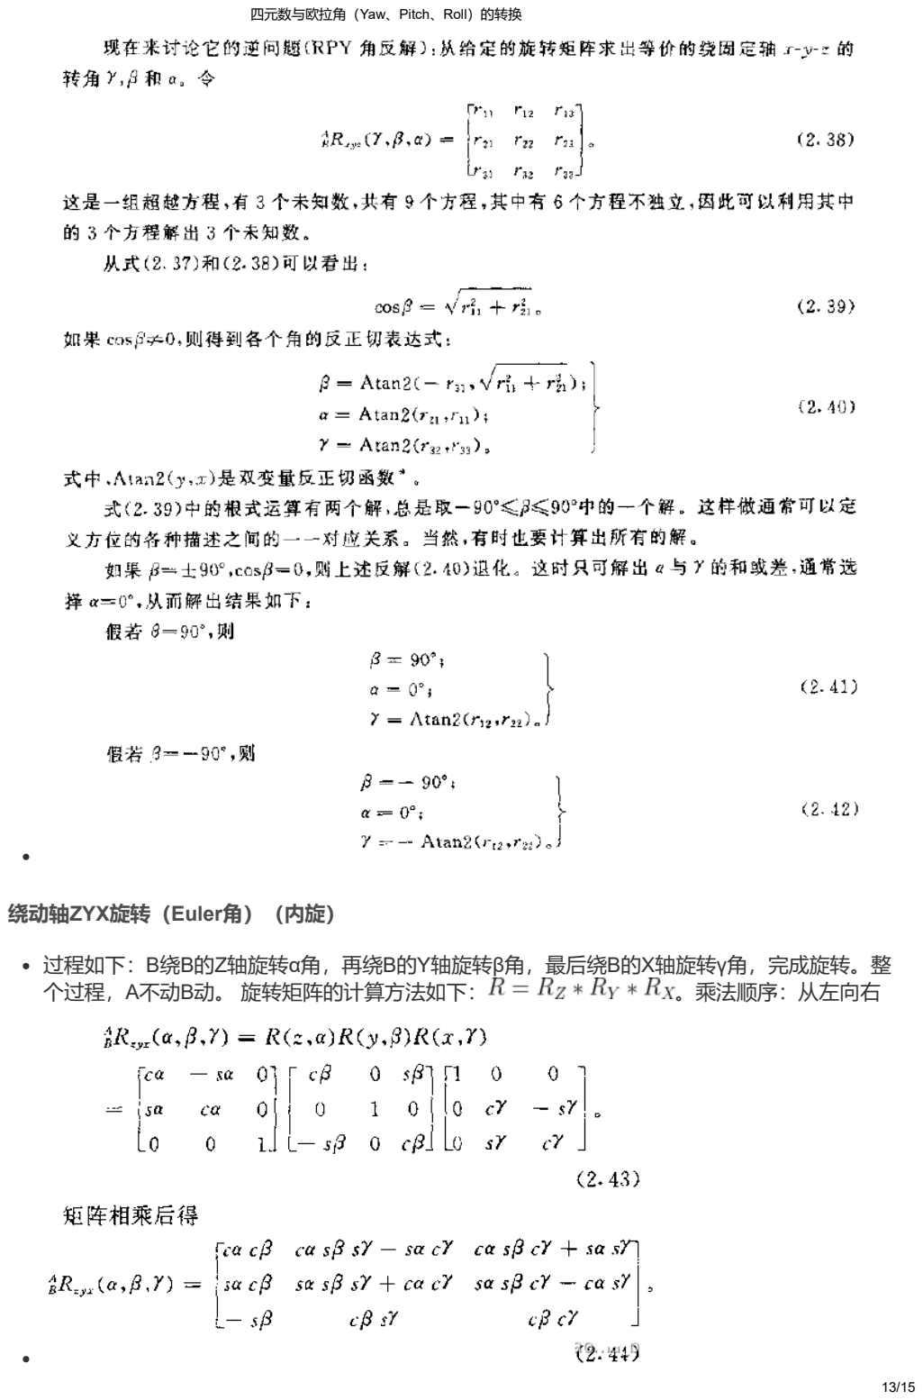
[picture p119: page 13]

### 绕动轴ZYX旋转（Euler角）（内旋）

### 过程如下：B绕B的Z轴旋转α角，再绕B的Y轴旋转β角，最后绕B的X轴旋转γ角，完成旋转。整

个过程，A不动B动。 旋转矩阵的计算方法如下： | 。乘法顺序：从左向右

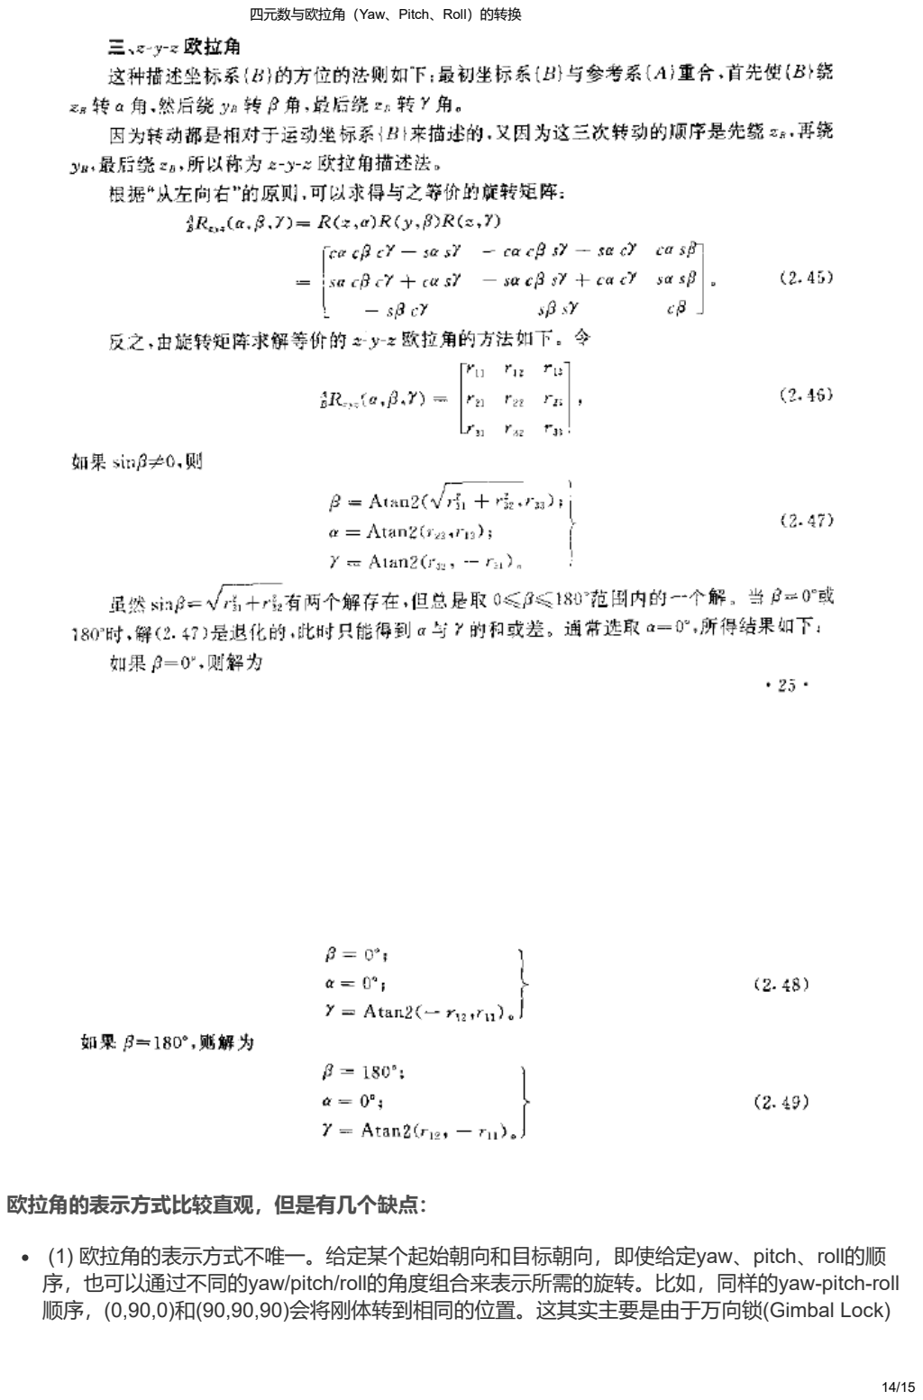
[picture p120: page 14]

### 欧拉角的表示方式比较直观，但是有几个缺点：

### (1) 欧拉角的表示方式不唯一。给定某个起始朝向和目标朝向，即使给定yaw、pitch、roll的顺 序，也可以通过不同的yaw/pitch/roll的角度组合来表示所需的旋转。比如，同样的yaw-pitch-roll

顺序，(0,90,0)和(90,90,90)会将刚体转到相同的位置。这其实主要是由于万向锁(Gimbal Lock)

### 引起的 (2) 欧拉角的插值比较难。 (3) 计算旋转变换时，一般需要转换成旋转矩阵，这时候需 要计算很多sin, cos，计算量较大。
