MXDfc/ShanghaiTech_EE114-Embedded-Systems/Lab6/WHEELTEC L150 避障巡线雷达小车资料/WHEELTEC L150系列小车安装视频/1. 底盘安装/R3mini差速小车底盘/R3mini差速小车安装视频/全向轮差速小车底盘安装手册.pdf

# Installation manual for

# Differential of Ackerman Smart

# Car Chassis

# （差速版阿克曼智能小车底盘安装手册）

目录

Assemble the Differential of Ackerman Smart Car Chassis（装配差速版阿克曼智能小车底盘）4

## List（列表）

Machinery Parts（机械配件）

Transmission Parts（传动件）

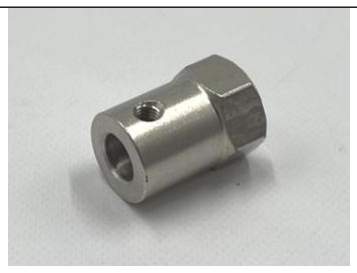
[picture p121: figure]
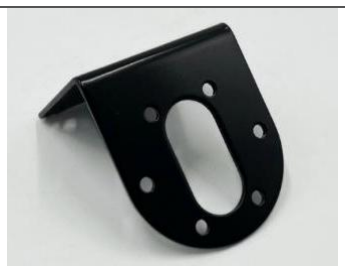
[picture p122: figure]
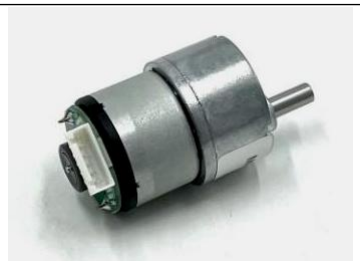
[picture p123: figure]

12V30F MG513 电机-霍尔 电机支架× | ×2 2 | 六角联轴器×2
M3*4 十字圆头螺丝 ×12 | M3*6 十字圆头螺丝 ×2 | M3*8 十字圆头螺丝 （黑色）×8 | M3*10 十字圆头螺丝 ×8
M4*6 十字圆头螺丝 ×2 | M4*16 十字平头螺丝 ×4 | M3 螺母 ×8 | M4 防松螺母 ×8
M4*1*9 垫片 ×2 | M3*50 铝柱双通 ×4

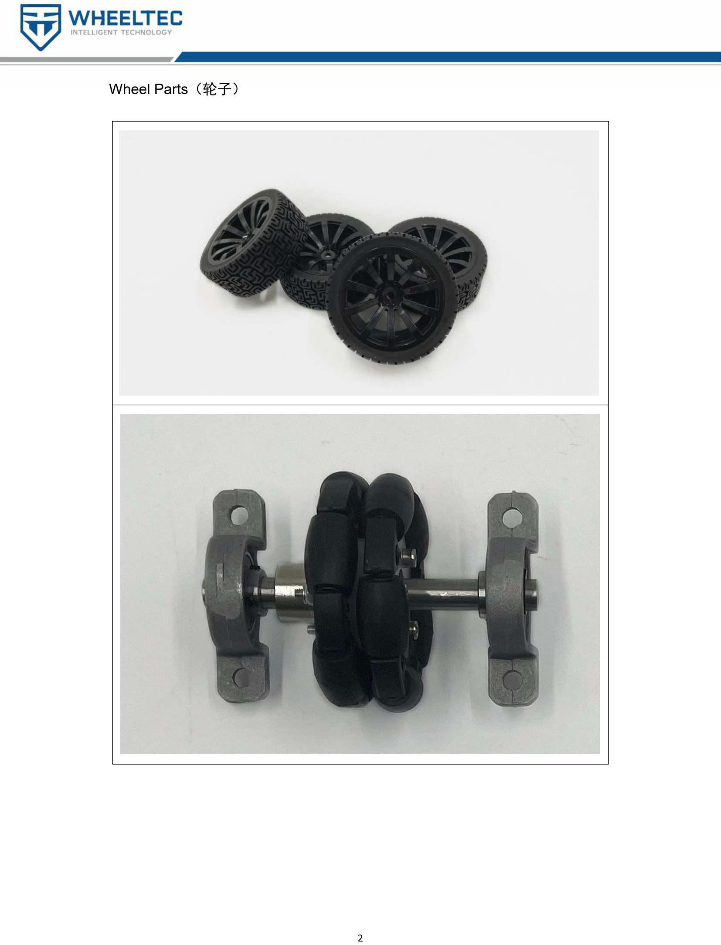
[picture p124: page 4]

Wheel Parts（轮子）

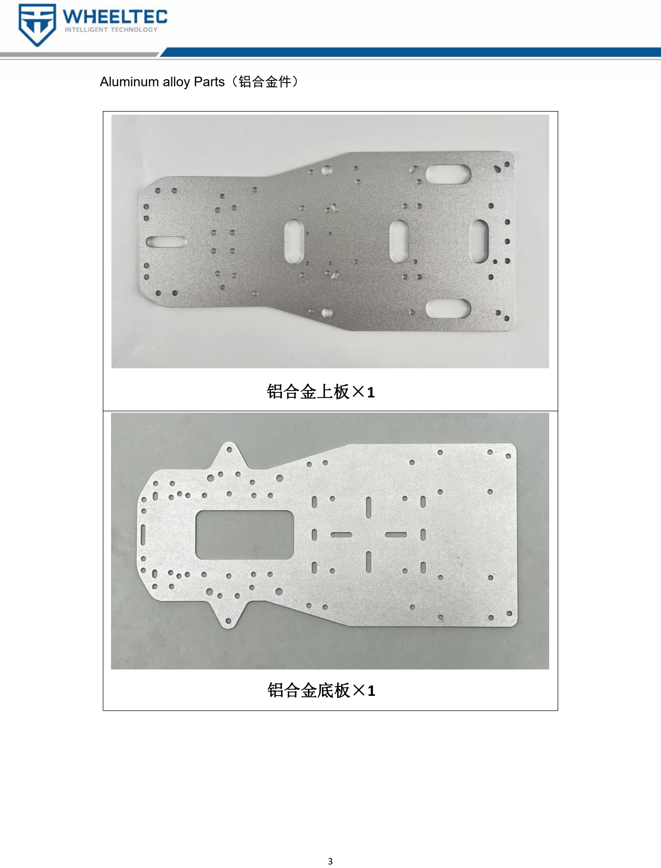
[picture p125: page 5]

Aluminum alloy Parts（铝合金件）

铝合金底板×1

铝合金上板×1

## Assemble the Differential of Ackerman Smart Car Chassis（装配差

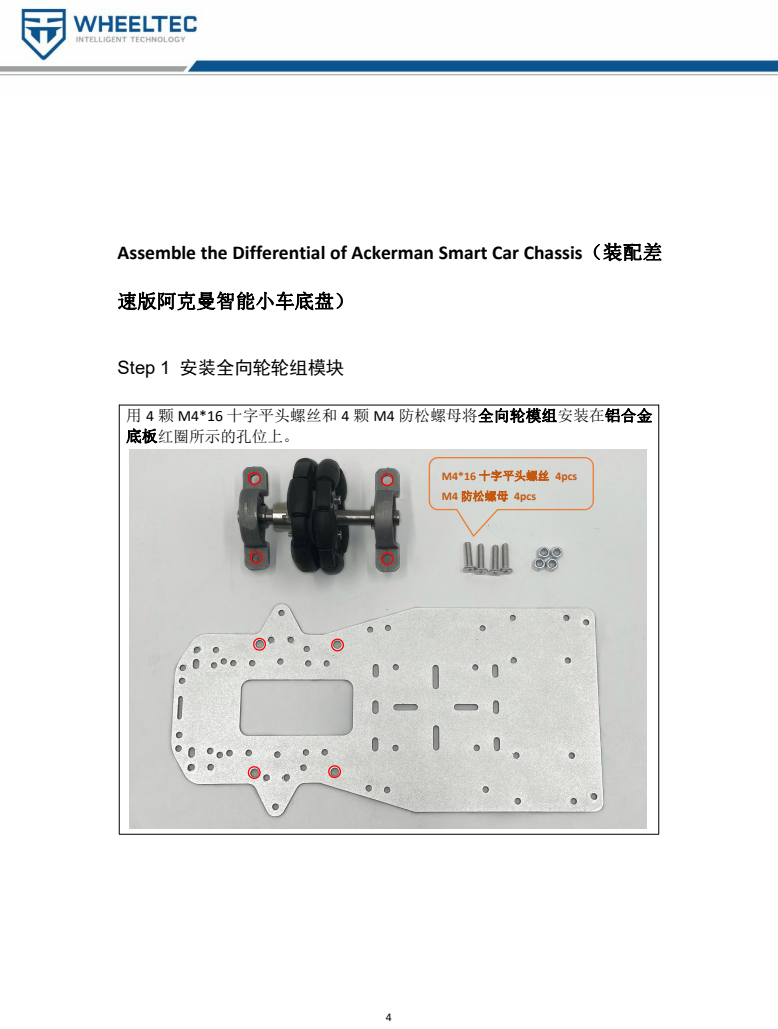
[picture p126: page 6]
速版阿克曼智能小车底盘）; Step 1 安装全向轮轮组模块; 用 4 颗 M4*16 十字平头螺丝和 4 颗 M4 防松螺母将全向轮模组安装在铝合金 底板红圈所示的孔位上。; M4*16 十字平头螺丝 4pcs M4 防松螺母 4pcs

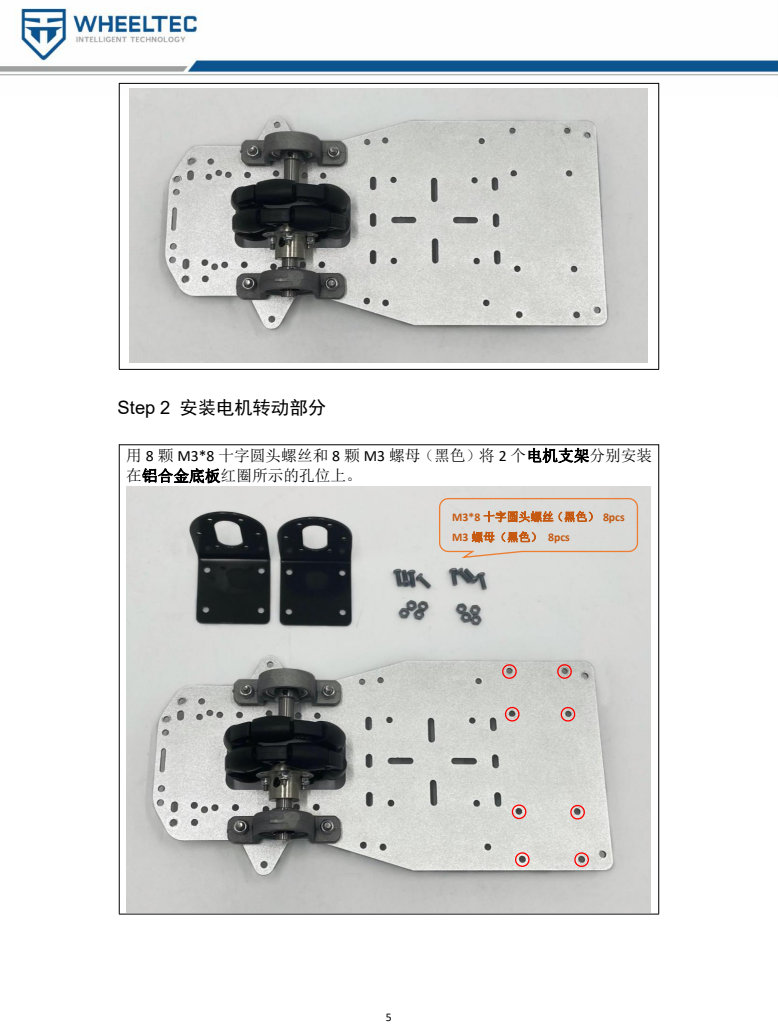
[picture p127: page 7]
Step 2 安装电机转动部分

用 8 颗 M3*8 十字圆头螺丝和 8 颗 M3 螺母（黑色）将 2 个电机支架分别安装
在铝合金底板红圈所示的孔位上。

M3*8 十字圆头螺丝（黑色） 8pcs M3 螺母（黑色） 8pcs

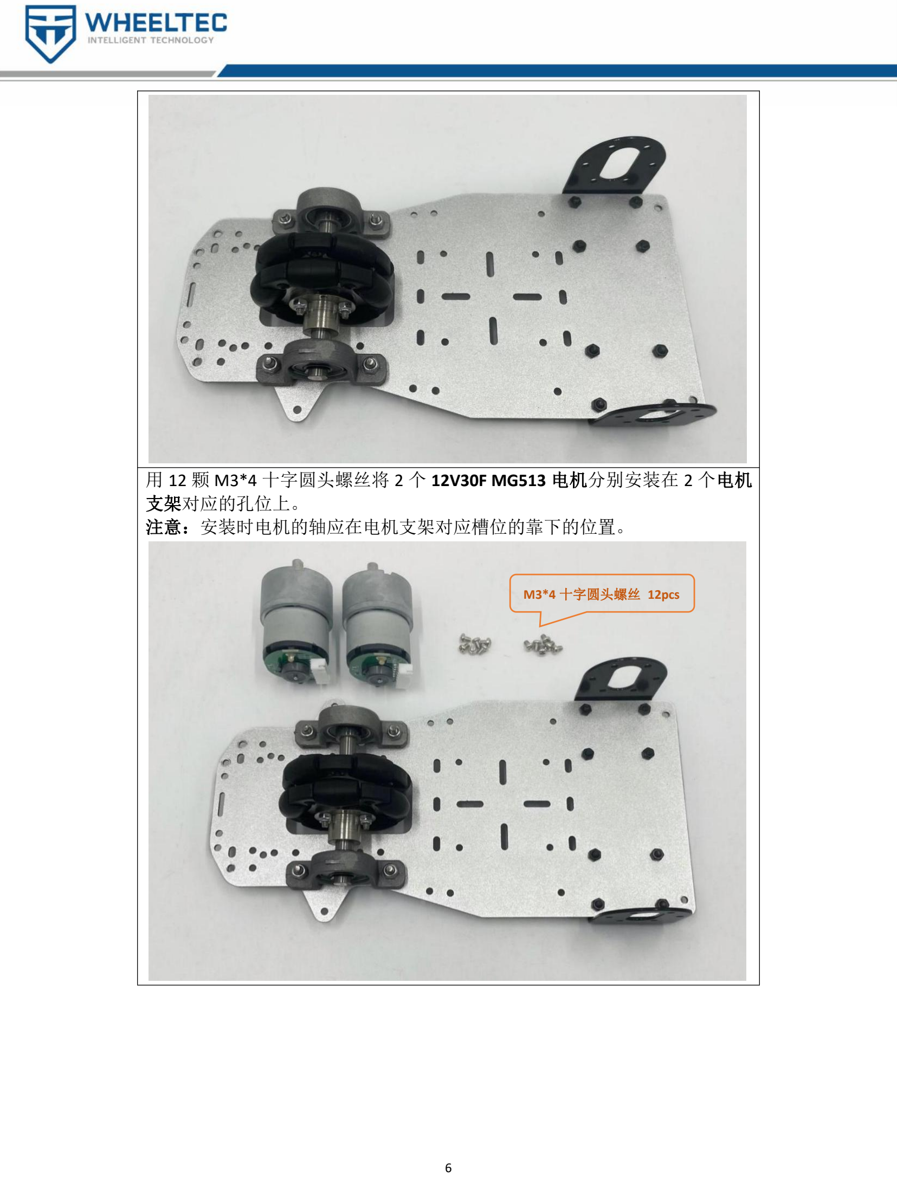
[picture p128: page 8]

用 12 颗 M3*4 十字圆头螺丝将 2 个 12V30F MG513 电机分别安装在 2 个电机 支架对应的孔位上。
注意：安装时电机的轴应在电机支架对应槽位的靠下的位置。

M3*4 十字圆头螺丝 12pcs

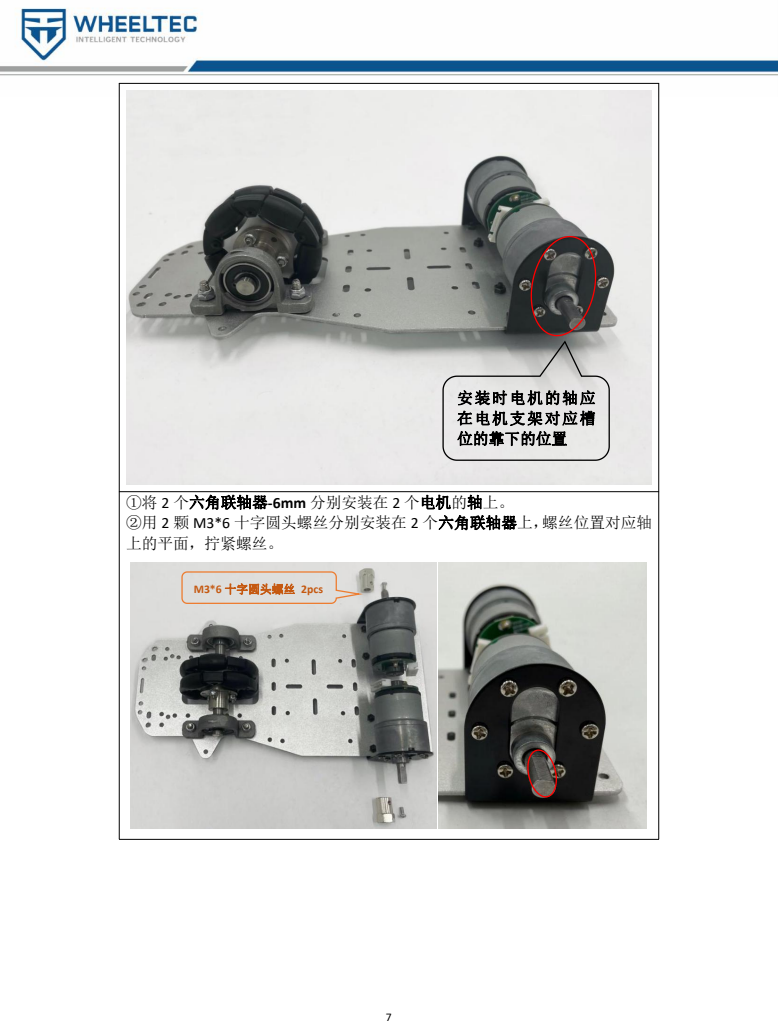
[picture p129: page 9]
安装时电机的轴应 在电机支架对应槽 位的靠下的位置; M3*6 十字圆头螺丝 2pcs

①将 2 个六角联轴器-6mm 分别安装在 2 个电机的轴上。
②用 2 颗 M3*6 十字圆头螺丝分别安装在 2 个六角联轴器上，螺丝位置对应轴
上的平面，拧紧螺丝。

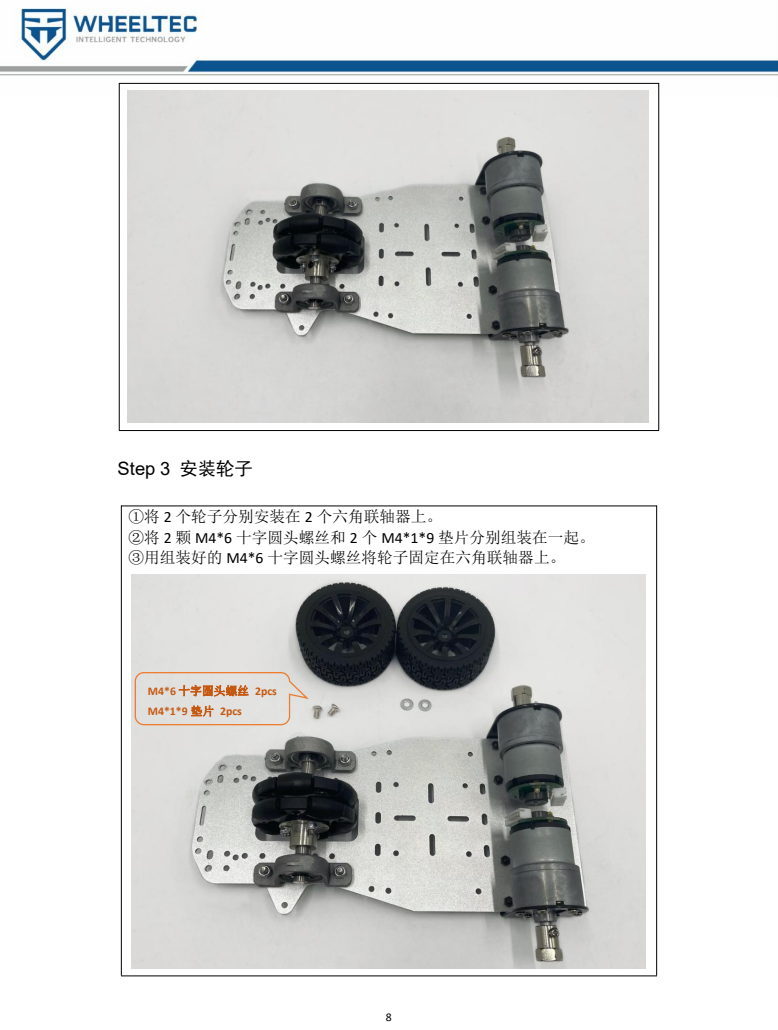
[picture p130: page 10]
Step 3 安装轮子; M4*6 十字圆头螺丝 2pcs M4*1*9 垫片 2pcs

①将 2 个轮子分别安装在 2 个六角联轴器上。
②将 2 颗 M4*6 十字圆头螺丝和 2 个 M4*1*9 垫片分别组装在一起。
③用组装好的 M4*6 十字圆头螺丝将轮子固定在六角联轴器上。

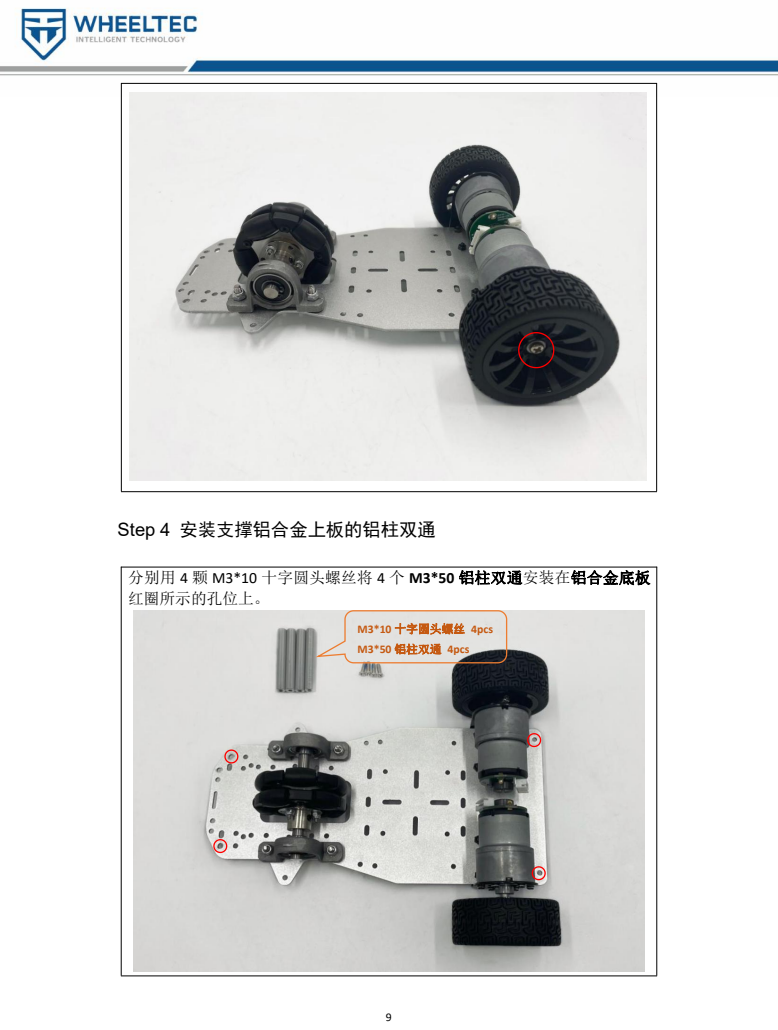
[picture p131: page 11]
Step 4 安装支撑铝合金上板的铝柱双通; M3*10 十字圆头螺丝 4pcs M3*50 铝柱双通 4pcs

分别用 4 颗 M3*10 十字圆头螺丝将 4 个 M3*50 铝柱双通安装在铝合金底板
红圈所示的孔位上。

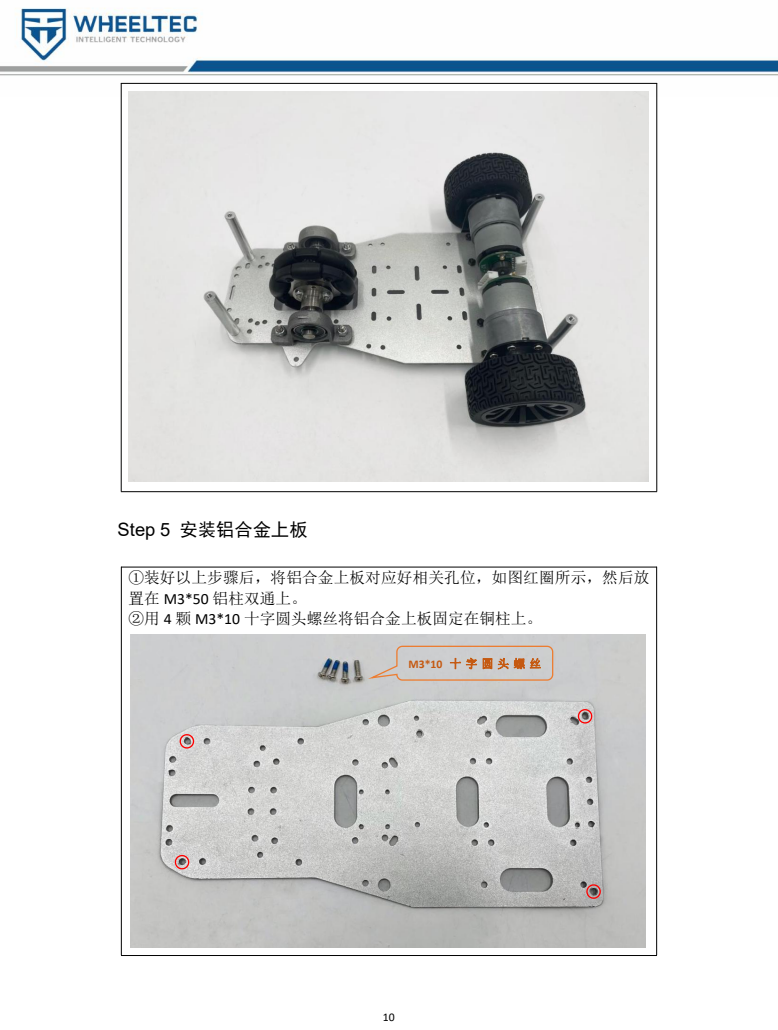
[picture p132: page 12]
Step 5 安装铝合金上板

①装好以上步骤后，将铝合金上板对应好相关孔位，如图红圈所示，然后放
置在 M3*50 铝柱双通上。
②用 4 颗 M3*10 十字圆头螺丝将铝合金上板固定在铜柱上。

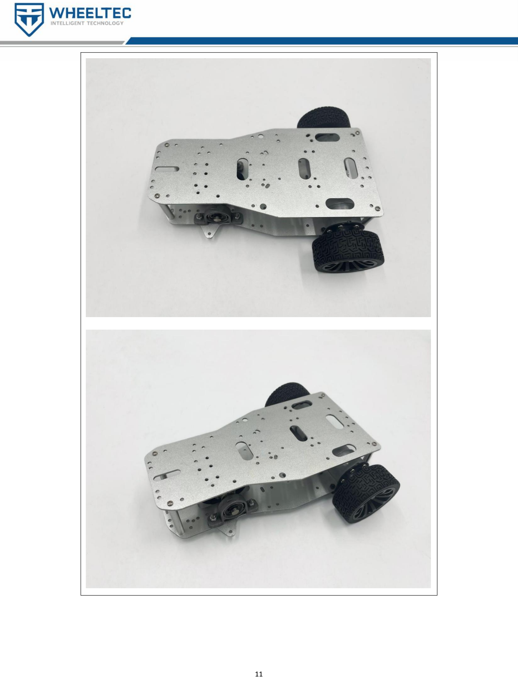
[picture p133: page 13]
