MXDfc/ShanghaiTech_EE114-Embedded-Systems/Lab2and3/Device Data/AI语音交互/1.教程资料/4 STM32通信/4.4.2 STM32语音播报例程/01 STM32F103/01 STM32F103语音播报例程.pdf

# 01 STM32F103 语音播报例程

## 1.准备工作

## 1.1 接线说明

接线时，语音交互模块的 5V、GND、SDA 和 SCL 引脚需使用 4Pin 线进行连接。STM32F103

接线方式如下图所示：


注意：通电前确保不要有金属物体接触到主板，否则可能会因主板底部的引脚导致电

路短路从而烧毁主板。

## 1.2 程序下载

烧录前需要准备 STM32F103 开发板 + 开源小车控制器、杜邦线以及 USB 转 TTL。

烧录步骤：

1) 将控制板通过 USB 转 TTL 工具连接至电脑的任意一个 USB 接口。


2) 双击打开本文件夹内的 stm32 示例程序。


3) 打开后，将所有代码编译生成可执行文件。
4) 将 stm32 开发板上的跳线帽拔掉，按下 RST 复位键。


5) 打开程序烧写工具 ，选择设备的正确端口，波特率维持不变。将程序烧录到

开发板中。具体参照下图所示：


6) 点击 打开文档同路径下

### “STM32F103_Asr_announce\Obj\OpenArmSTM32.hex”文件。

7) 接着点击开始编程，等待烧录完成即可。


8) 烧录完成后将跳线帽重新接入 STM32 开发板上，再按下 RST 键即可运行程序。

## 2.测试案例

本例程通过 STM32F103 开发板控制语音交互模块循环播放语音。

## 2.1 实现效果

STM32F103 开发板控制语音交互模块每隔 5 秒依次播报“正在前进”、“正在左转”、

“可回收物”、“有害垃圾”，以此循环。

## 2.2 程序简要分析

1) 导入了 IIC 通信相关功能库，用于与语音交互模块进行通讯。
2) 对串口以及 IIC 进行了初始化，将串口的波特率设置为 9600。
3) 在主函数中，通过调用 asr.speak()函数向语音交互模块写入数据，该函数有两

个参数，参数 1 为命令词或播报词的寄存器地址，参数 2 为播报语所对应的值。

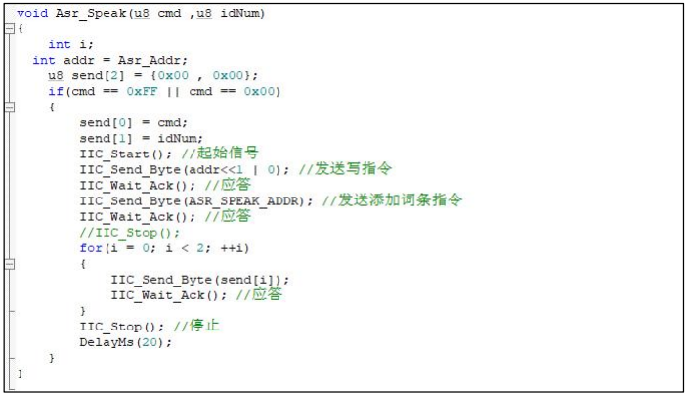
[picture p147: figure]

4) ASR_CMDMAND 是一个宏定义，其值为 0x00 表示需要写入的功能类型为命令词。首

先对寄存器地址 ASR_CMDMAND 写入 0x01，对应数据列表中的播报语句“正在前进”，数据

0x03 所对应的是“正在左转”。

5) ASR_ANNOUNCER 值为 0xFF 表示需要写入的功能类型为播报语。对寄存器地址

ANNOUNCER 写入 0x01，对应数据列表中的播报语句“可回收物”，数据 0x03 所对应的是

“有害垃圾”。

如需获取具体数据列表，请查看“5.自定义词条制作\5.1.语音芯片固件制作”目录下

的“命令词播报词协议列表”。
