MXDfc/ShanghaiTech_EE114-Embedded-Systems/Lab6/WHEELTEC L150 避障巡线雷达小车资料/WHEELTEC L150 避障巡线雷达小车附送资料_V2.8_2025.05.15/1.使用与开发教程视频/说明文档.txt

    C10A主板与C10B主板之间硬件资源完全相同，两个版本的板子差异主要是C10B主板增加了一个预留的电位器接口以及去除板载MPU6050芯片的焊盘，其余无改动，因此两个板子的课程通用。
       由于视频拍摄器件发生了板子版本迭代因此部分视频会存在板子型号的交替出现的情况，请读者谅解。
