MXDfc/ShanghaiTech_EE114-Embedded-Systems/Lab6/WHEELTEC L150 避障巡线雷达小车资料/WHEELTEC L150 避障巡线雷达小车附送资料_V2.8_2025.05.15/1.使用与开发教程视频/3.STlink下载程序/STlink下载程序.txt

1.安装对应芯片pack包

2.安装STlink驱动

3.查看是否连接STlink

4.打开STM32工程文件

5.STlink连接单片机(A14-SWCLK     A13-SWDIO)

6.开始下载
