MXDfc/ShanghaiTech_EE114-Embedded-Systems/Lab6/WHEELTEC L150 避障巡线雷达小车资料/WHEELTEC L150 避障巡线雷达小车附送资料_V2.8_2025.05.15/关于变更公司名称的说明.pdf

### 关于变更公司名称的说明

我司因业务发展、品牌推广的需求，已于 2021 年 10 月 15 日，

经东莞市市场监督管理局批准，公司名称由原“东莞市微宏智能科技

有限公司”变更为“轮趣科技（东莞）有限公司”，公司营业地址、

联系方式不变。

轮趣科技（东莞）有限公司

2021 年 10 月 22 日
