MXDfc/ShanghaiTech_EE114-Embedded-Systems/Lab2and3/Device Data/AI语音交互/1.教程资料/3.修改唤醒词与命令词/3.1 修改唤醒词.pdf

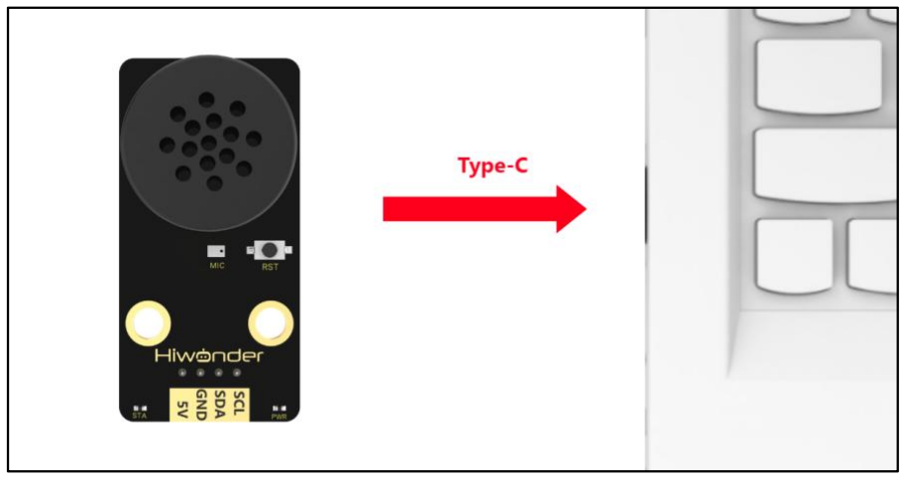
[picture p156: figure]

1

# 3.1 修改唤醒词

## 1.注意事项

1) 请在安静的场景下进行修改唤醒词，嘈杂的环境会影响语音交互模块的识别准确率。
2) 说词条时，声音要洪亮且语速不宜过快，建议与模块之间保持在 5 米以内。

## 2.设备连接

使用 Type-C 线连接语音交互模块到电脑。

## 3.修改唤醒词实现

1) 对语音交互模块说出“小幻小幻”将语音交互模块唤醒，当模块回复“我在”时，

表明当前处于可识别状态。

2) 再对语音交互模块说出“学习唤醒词”词条，语音交互模块回应“说出唤醒词”，

即进入到唤醒词学习功能状态。

3) 接着对语音交互模块说出想要设置的唤醒词，唤醒词应尽量简短，这里以设置“你

好小幻”为例。

4) 当语音交互模块识别成功后，将会播报“学习成功”，表明唤醒词修改成功，这时

候我们就可以使用“你好小幻”词条就能唤醒模块了。

注意：出厂固件中的唤醒词“小幻小幻”是基础唤醒词，无法通过语音进行修改或删

除。用户使用语音修改的唤醒词只能同时存在一个，与基础唤醒词是共同存在的。
