MXDfc/ShanghaiTech_EE114-Embedded-Systems/Lab2and3/Device Data/AI语音交互/1.教程资料/3.修改唤醒词与命令词/3.3 修改命令词.pdf

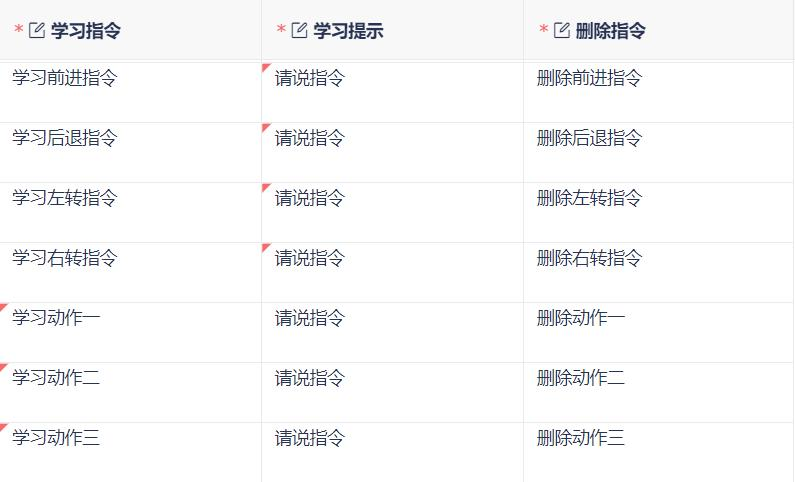
[picture p157: figure]

1

# 3.3 修改命令词

## 1.注意事项

1) 请在安静的场景下进行修改命令词，嘈杂的环境会影响语音交互模块的识别准确率。
2) 说词条时，声音要洪亮且语速不宜过快，建议与模块之间保持在 5 米以内。

## 2.设备连接

使用 Type-C 线连接语音交互模块到电脑。

## 3.修改命令词实现

语音交互模块出厂固件中预置 15 个可以语音修改的命令词，如下所示：

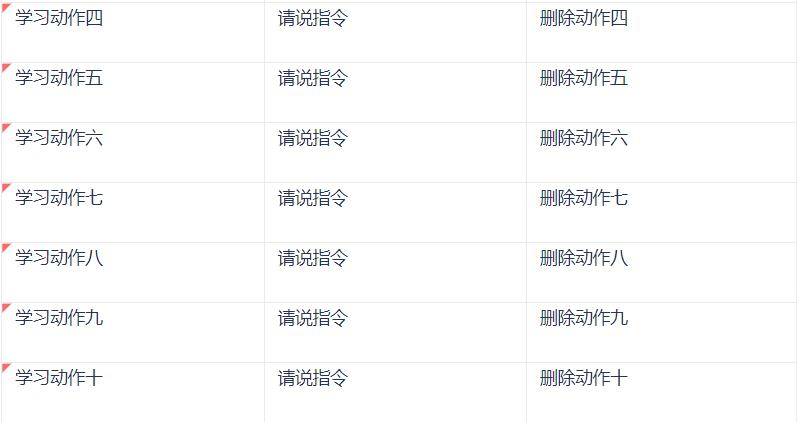
[picture p158: figure]

2

用法举例如下：

1) 对语音交互模块说出“小幻小幻”将语音交互模块唤醒，当模块回复“我在”时，

表明当前处于可识别状态。

2) 再对语音交互模块说出“学习前进指令”词条，语音交互模块回应“请说指令”，

即进入到命令词学习功能状态。

3) 接着对语音交互模块说出想要设置的命令词，命令词应尽量简短，这里以设置“向

前走”为例。

4) 当语音交互模块识别成功后，将会播报“学习成功”，表明命令词修改成功，这时

候我们就可以使用“向前走”词条就能达到与“前进”命令词一样的效果了。

5) 若需要删除掉“向前走”词条，只需要说出“删除前进指令”，当回复“删除成功”

时，即完成词条删除（只会删除“向前走”，不会删除“前进”）。

注意：出厂固件中的命令词是基础命令词（如上的“前进”），无法通过语音进行修

改或删除。用户使用语音修改的命令词只能同时存在一个，与基础命令词是共同存在的。
