MXDfc/ShanghaiTech_EE114-Embedded-Systems/Lab4and5/Device Data/LAB4-5 MPU6050(1)/LAB4-5 MPU6050/MPU6050_DMP移植教程(读取姿态角)/MPU6050-DMP移植参考手册.pdf

序言

## 本文主要介绍 C10B(F103RCT6 芯片)的移植方法，C30D(F407VET6)的移植方法

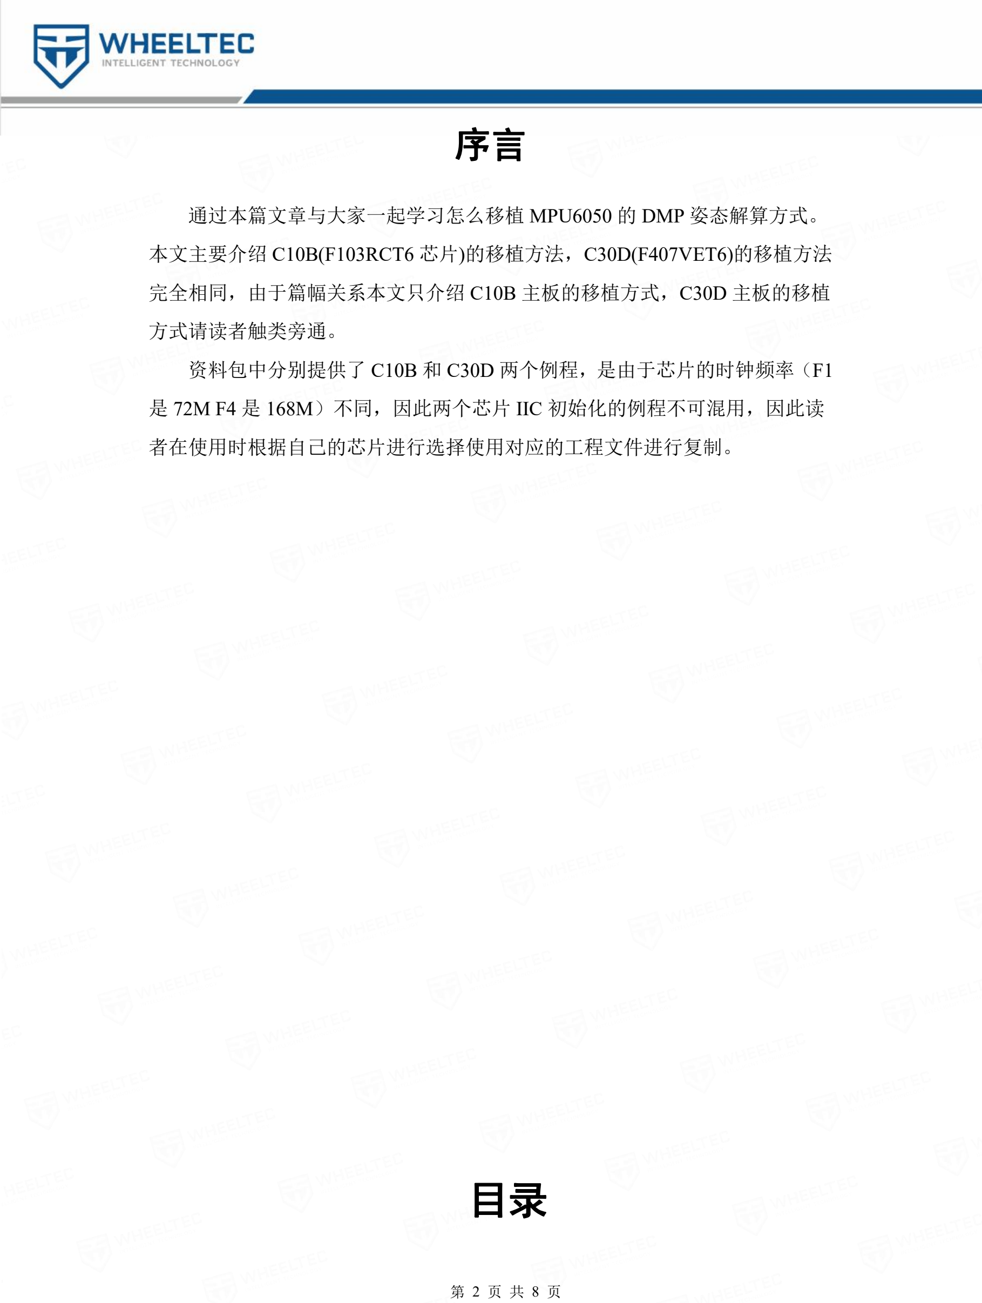
[picture p159: page 1]

第 2 页 共 8 页

通过本篇文章与大家一起学习怎么移植 MPU6050 的 DMP 姿态解算方式。

完全相同，由于篇幅关系本文只介绍 C10B 主板的移植方式，C30D 主板的移植

方式请读者触类旁通。

资料包中分别提供了 C10B 和 C30D 两个例程，是由于芯片的时钟频率（F1

是 72M F4 是 168M）不同，因此两个芯片 IIC 初始化的例程不可混用，因此读

者在使用时根据自己的芯片进行选择使用对应的工程文件进行复制。

目录

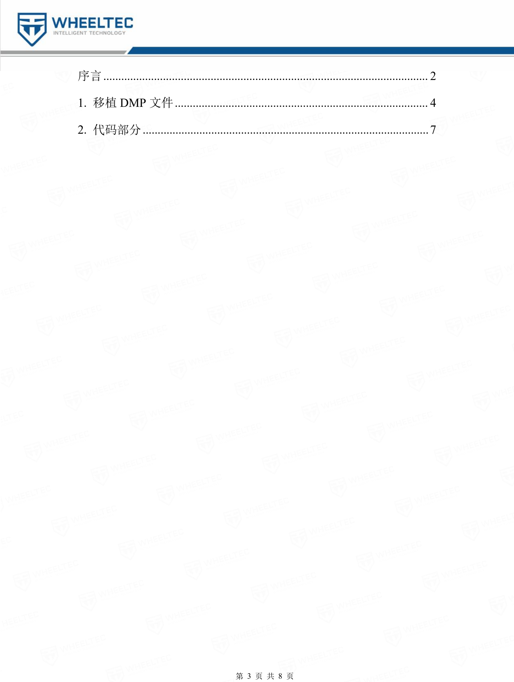
[picture p160: page 2]

第 3 页 共 8 页

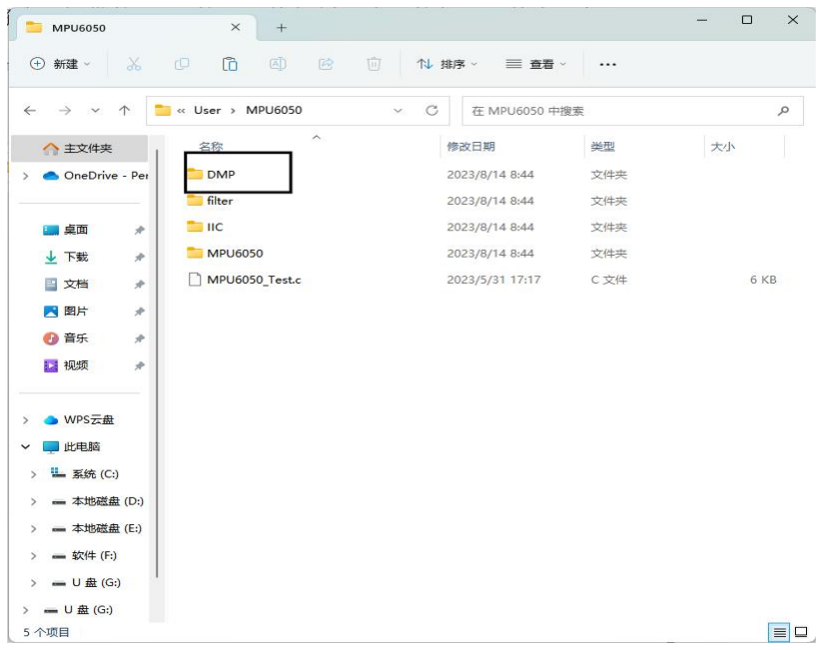
[picture p161: figure]

第 4 页 共 8 页

# 1. 移植 DMP 文件

### 首先我们需要将我们提供的 DMP 的源文件复制到所需移植的代码文件中，

### 例如 在我 们提 供的 C10B 的例 程文 件中 ，我们 已经 将 DMP 文件 复制到

### User.MPU6050.c 文件夹中，如下图所示。

图 1 DMP 文件复制图示

### 复制完成后，打开工程代码，点击魔法棒，再点击 C/C++按钮，最后点击

### Include Path 右边的三个...按钮，将 DMP 的头文件包含起来。在第四步的时候注

### 意找对 DMP 所在的文件夹，选择正确如同图 5 中的红色框框所示，然后点击

### OK 即可。

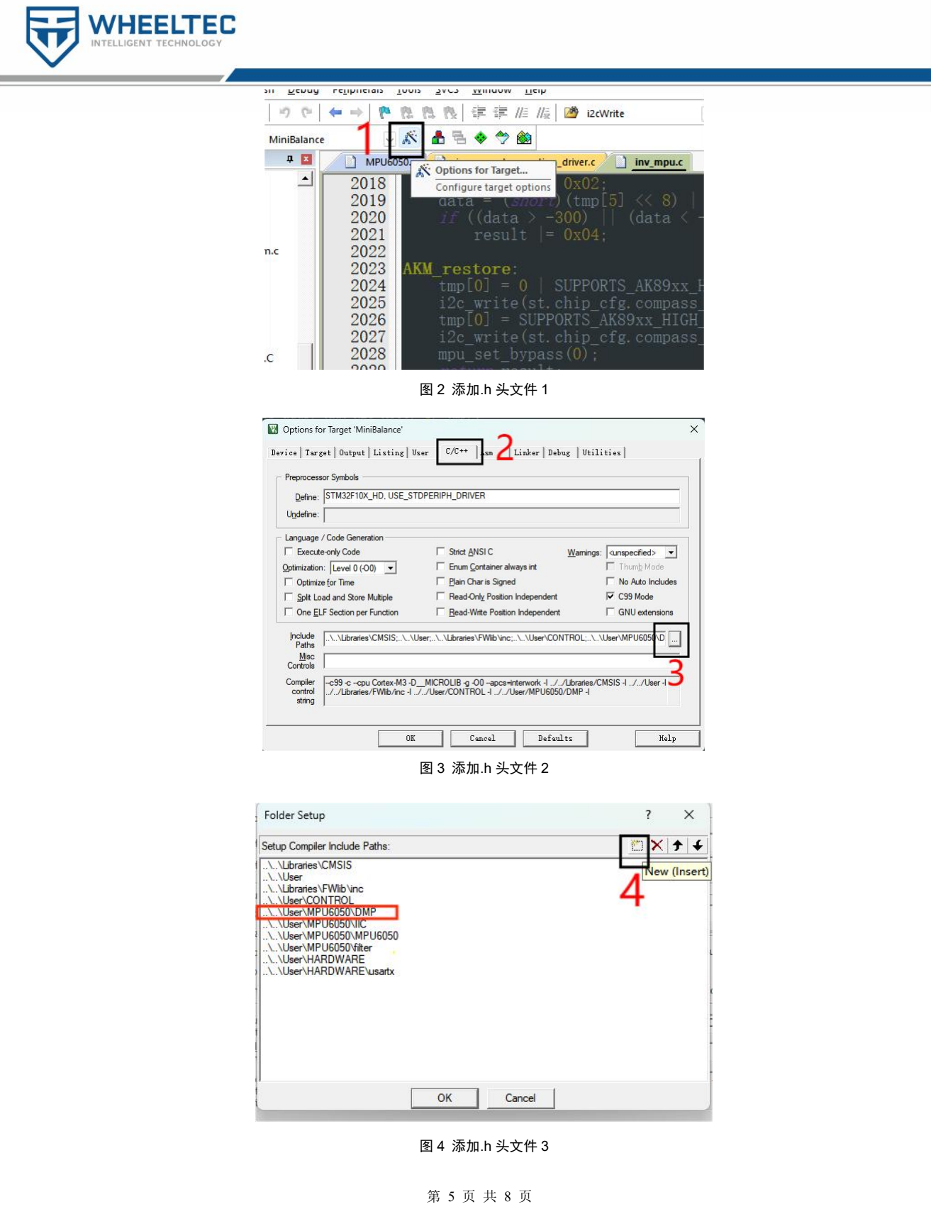
[picture p162: page 4]

第 5 页 共 8 页

图 2 添加.h 头文件 1

图 3 添加.h 头文件 2

图 4 添加.h 头文件 3

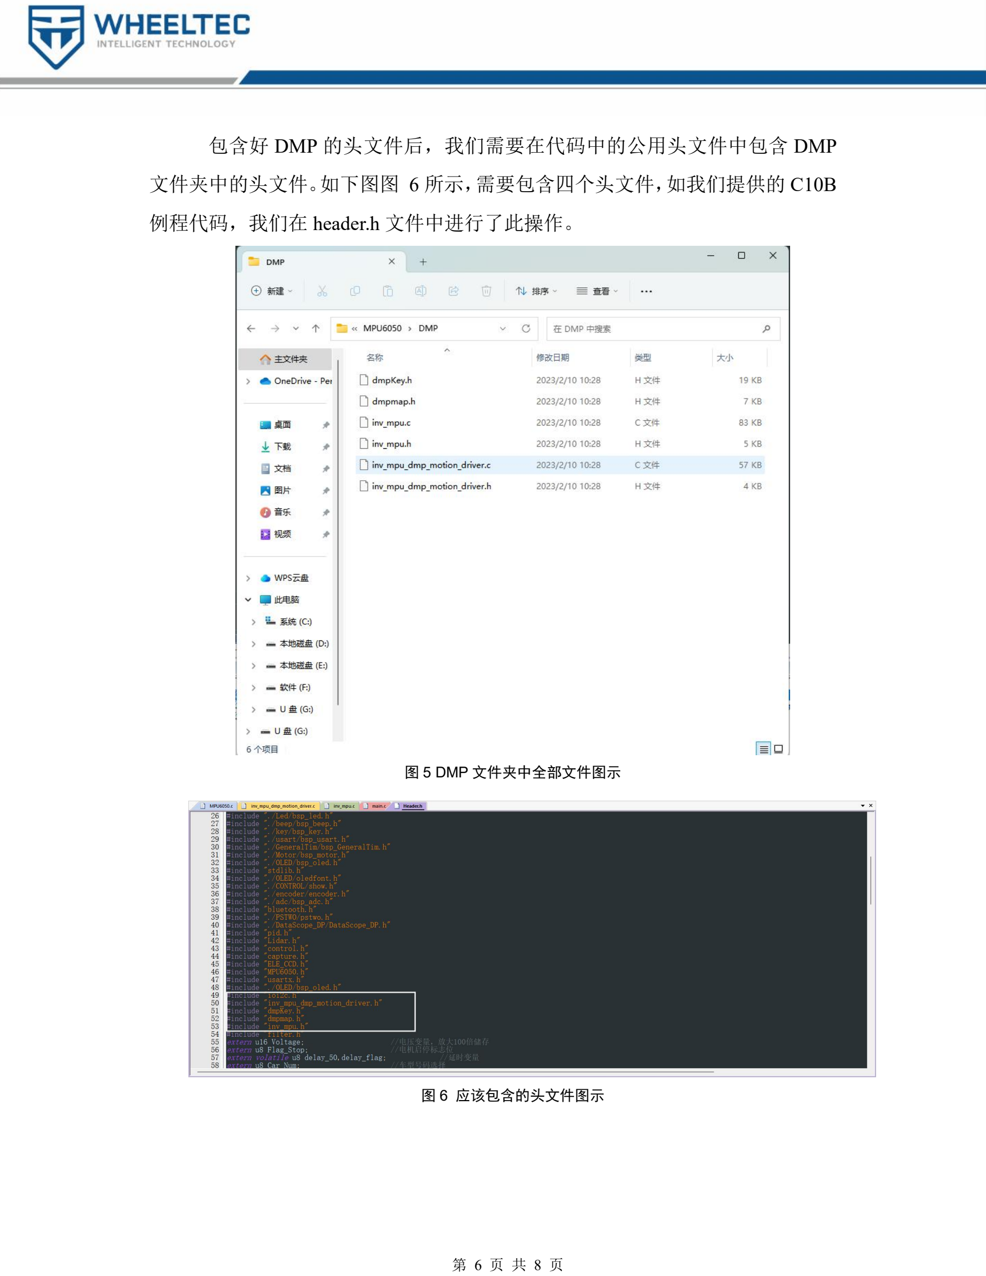
[picture p163: page 5]

第 6 页 共 8 页

包含好 DMP 的头文件后，我们需要在代码中的公用头文件中包含 DMP

文件夹中的头文件。如下图图 6 所示，需要包含四个头文件，如我们提供的 C10B

例程代码，我们在 header.h 文件中进行了此操作。

图 5 DMP 文件夹中全部文件图示

图 6 应该包含的头文件图示

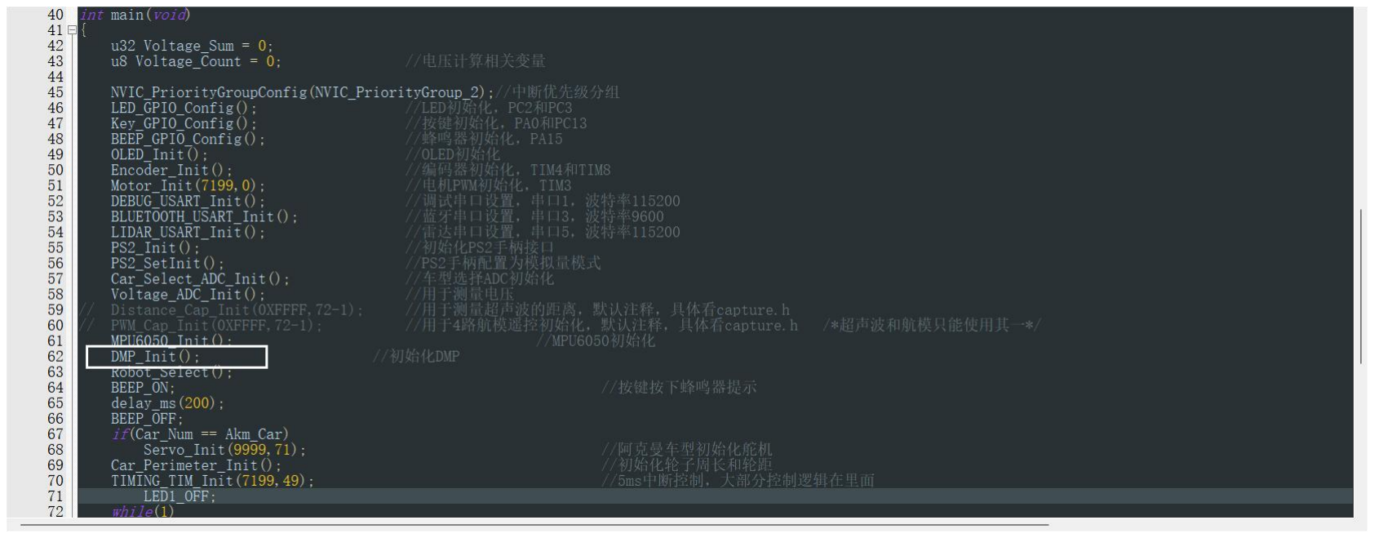
[picture p164: figure]
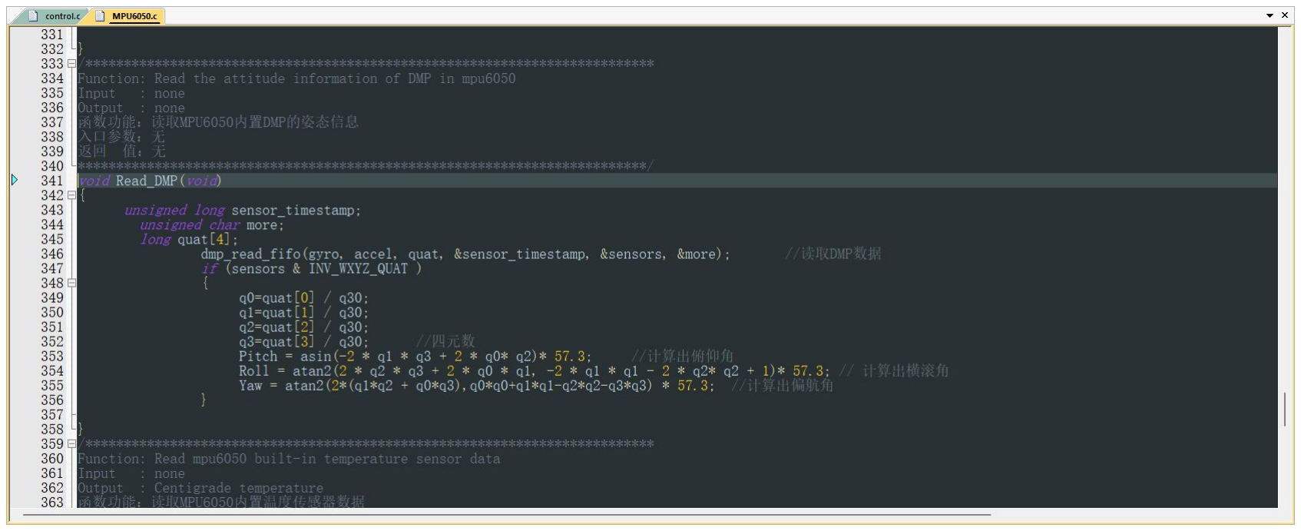
[picture p165: figure]

第 7 页 共 8 页

# 2. 代码部分

MPU6050 的初始化和 DMP 初始化等函数中利用了很多 IIC 方面的通讯函数，

如果 IIC 方面的函数对应不上，请参考我们提供的例程。

接下来就是我们的代码部分了，首先在主函数部分初始化 DMP 函数，DMP

## 初始化函数为 DMP_Init(),该函数在 MPU6050.c 文件中。

图 7 DMP 初始化函数

### 接下来就是读取 MPU6050 内置的 DMP 的姿态信息，在 MPU6050.c 文件中

### 的 Read_DMP()函数就是读取函数，此函数已经将 DMP 读取到的四元数转化为

### Pitch、Roll、Yaw。

图 8 读取姿态信息函数

如 C10B 中的例程，是在主要的中断函数中的读取姿态信息（中断函数在

Contorl.c 文件中）。

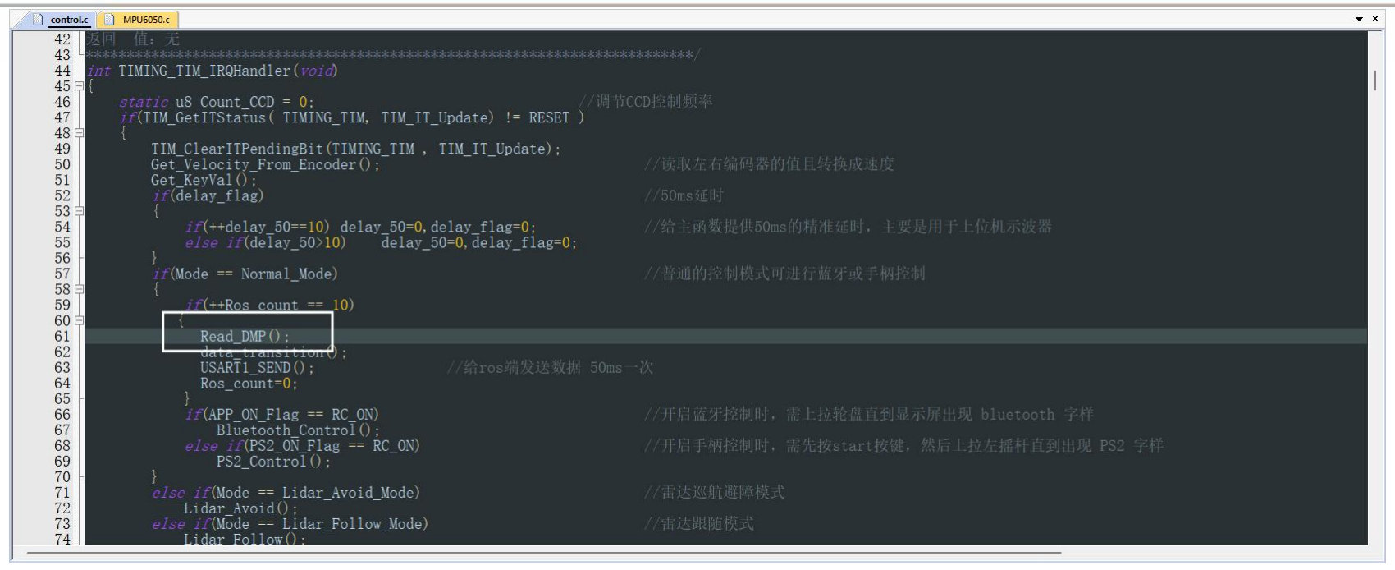
[picture p166: figure]

第 8 页 共 8 页

图 9 读取函数图示
