MXDfc/ShanghaiTech_EE114-Embedded-Systems/Lab6/WHEELTEC L150 避障巡线雷达小车资料/WHEELTEC L150系列小车安装视频/1. 底盘安装/R3mini全向轮小车底盘/R3mini全向轮小车底盘安装视频/标准版全向轮小车底盘安装操作指引.pdf

文件编号： | WHDJDP | 东莞市微宏智能科技有限公司 WaitHome 产品安装手册 | 了解我们 | | 审核人 | 批准人
产品编号： | DJXCDP | | 更多产品
文档版次： | A001 | | 右侧扫码 | | 审核日期 | 批准日期
产品型号： | 标准版全向轮小车底盘 | | 平衡小车之家 | | 2020/4/2
设备及工具： | 螺丝刀 | | 生产辅料 | 无

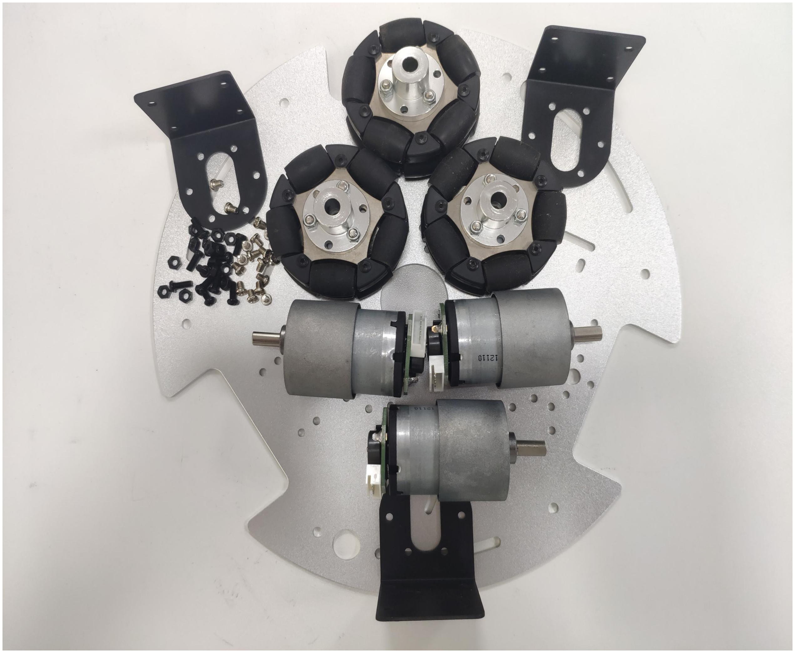
[picture p179: figure]

| 按照下表进行收货后检查
2mm铝合金底板 | 1件 | M3x4螺丝 | 18件
电机支架 | 3件 | M3x8螺丝 | 12件
电机 | 3件 | M3螺母 | 12件
全向轮 | 3件

收
货
检
查

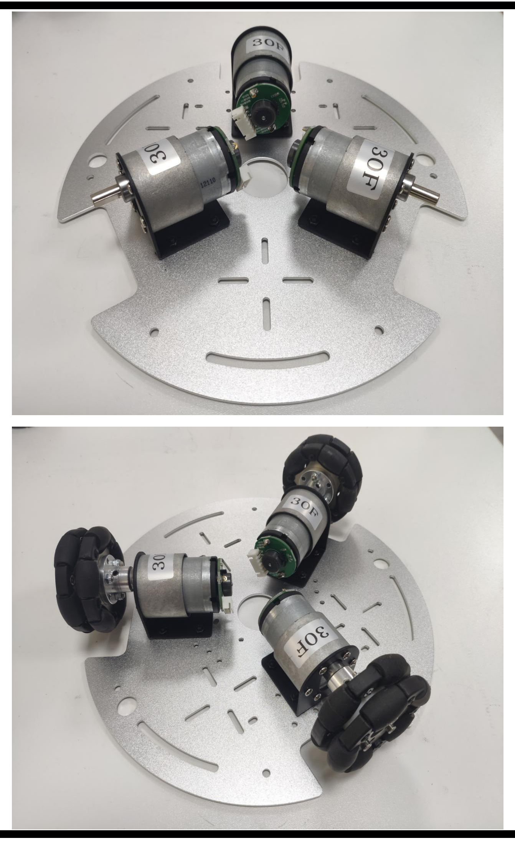
[picture p180: figure]
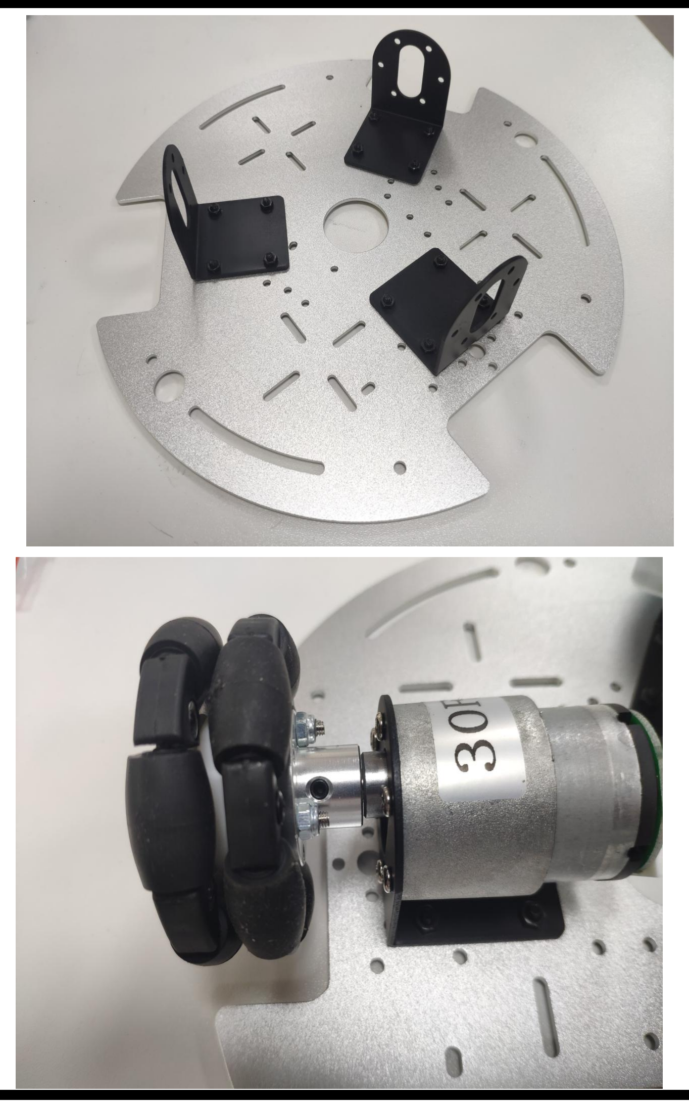
[picture p181: figure]

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
①.使用M3x8螺丝、M3螺母连接电机支架和铝合金底板（注 意使用孔位为从外向内第2行和第4行4个孔）；
②.使用M3x4螺丝连接电机和电机支架（注意电机轴位置在 偏离铝合金底板一端）；
③.使用全向轮法兰上自带的无头内六角螺丝连接电机和全向 轮（注意无头内六角螺丝要对准电机轴切面）；
④.完成标准版全向轮小车底盘装配；

←①
②→

←③
④→
