MXDfc/ShanghaiTech_EE114-Embedded-Systems/Lab2and3/Device Data/AI语音交互/1.教程资料/5.自定义词条制作/5.1 语音芯片固件制作/5.1.1 语音芯片固件制作.pdf

# 5.1.1 语音芯片固件制作

## 1.注意事项

模块出厂已烧录语音识别功能固件，本文档同路径下也提供了出厂固件，若需重新制作

固件可按照本文档进行固件制作。

## 2.固件制作

1) 首先需要打开“启英泰伦语音 AI 平台 (chipintelli.com) (https://aiplatform.chipintelli.com/home/index.html) ”链接，进入

固件制作官网。

2) 点击菜单栏的“平台功能”，再点击产品开发栏下的“产品固件及 SDK 深度开发”。

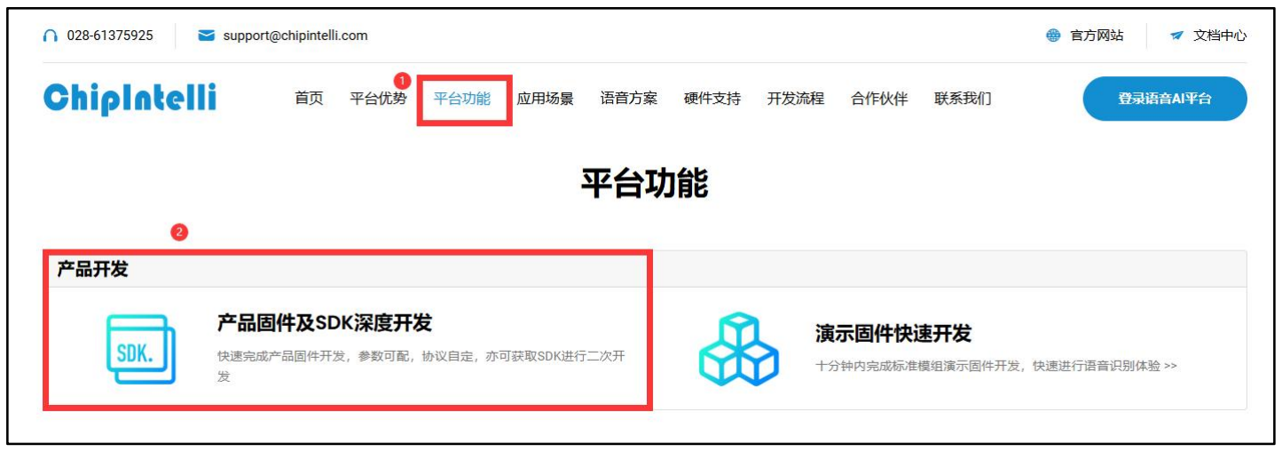
[picture p182: figure]

3) 此时系统将提示需要登录账号（若未注册需先完成平台账号注册）。本文示例中我

们已提前完成注册，登录成功后请先点击“离线语音识别大模型应用”。

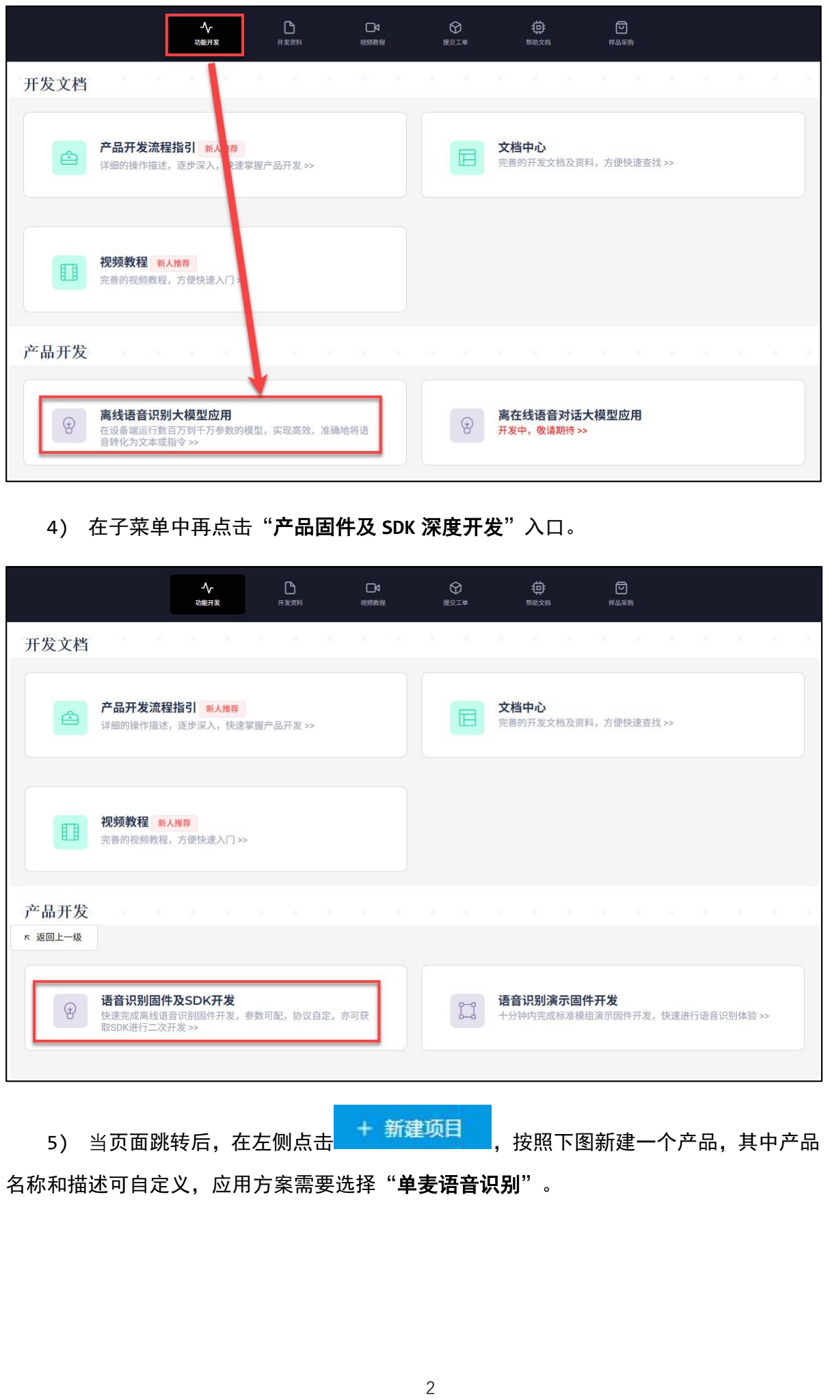
[picture p183: page 2]

4) 在子菜单中再点击“产品固件及 SDK 深度开发”入口。
5) 当页面跳转后，在左侧点击 | ，按照下图新建一个产品，其中产品

名称和描述可自定义，应用方案需要选择“单麦语音识别”。

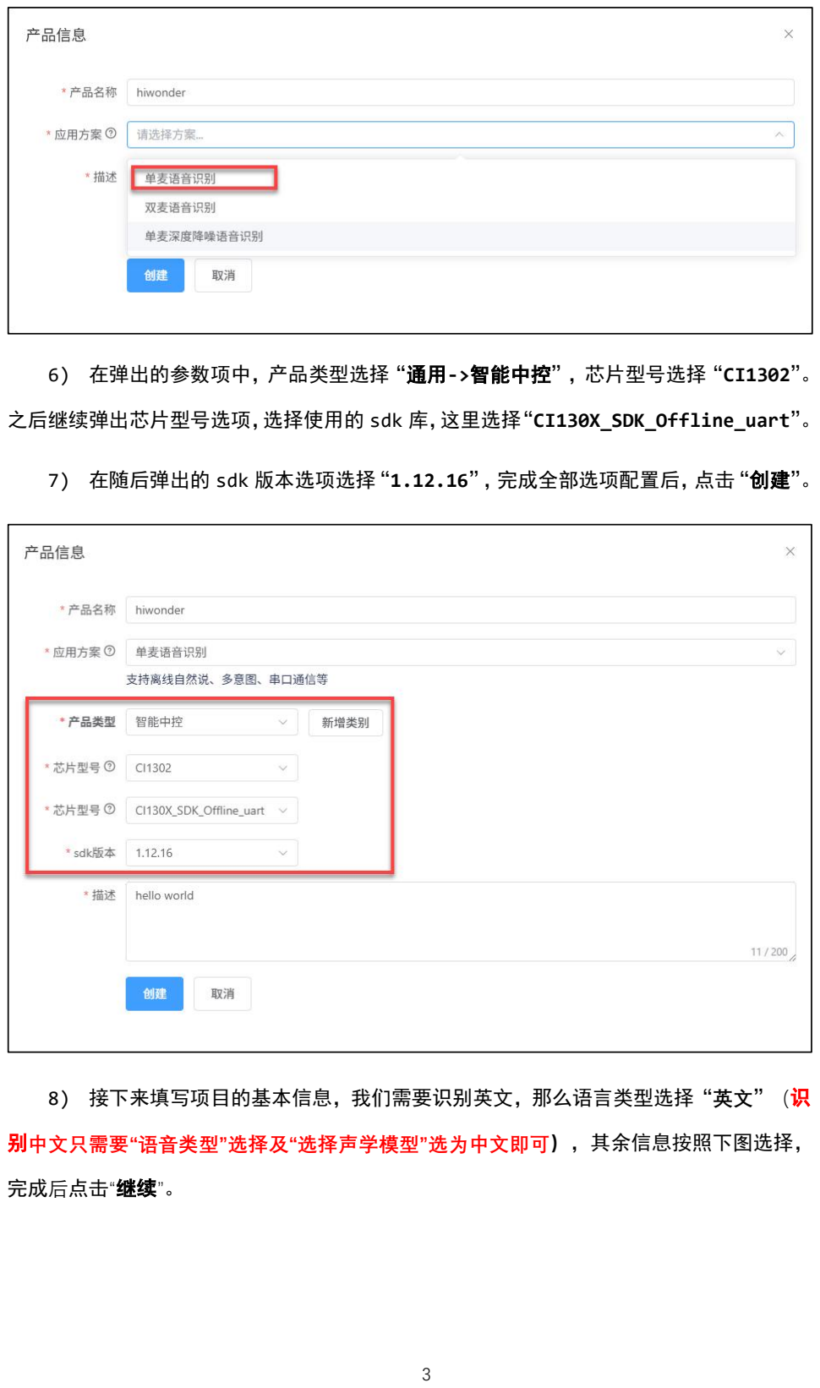
[picture p184: page 3]

6) 在弹出的参数项中，产品类型选择“通用->智能中控”，芯片型号选择“CI1302”。

之后继续弹出芯片型号选项，选择使用的 sdk 库，这里选择“CI130X_SDK_Offline_uart”。

7) 在随后弹出的 sdk 版本选项选择“1.12.16”，完成全部选项配置后，点击“创建”。
8) 接下来填写项目的基本信息，我们需要识别英文，那么语言类型选择“英文”（识

### 别中文只需要“语音类型”选择及“选择声学模型”选为中文即可），其余信息按照下图选择，

完成后点击“继续”。

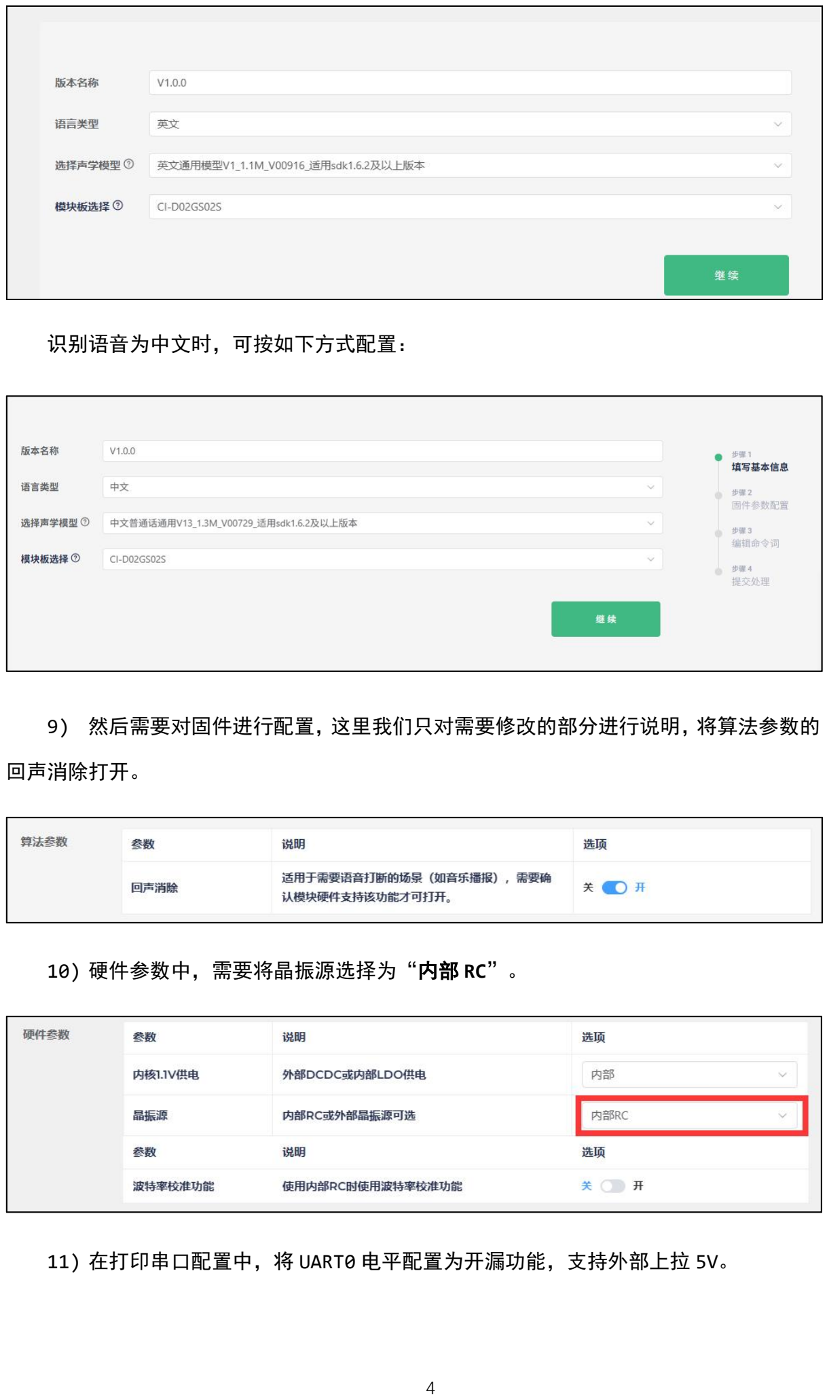
[picture p185: page 4]

识别语音为中文时，可按如下方式配置：

9) 然后需要对固件进行配置，这里我们只对需要修改的部分进行说明，将算法参数的

回声消除打开。

10) 硬件参数中，需要将晶振源选择为“内部 RC”。
11) 在打印串口配置中，将 UART0 电平配置为开漏功能，支持外部上拉 5V。

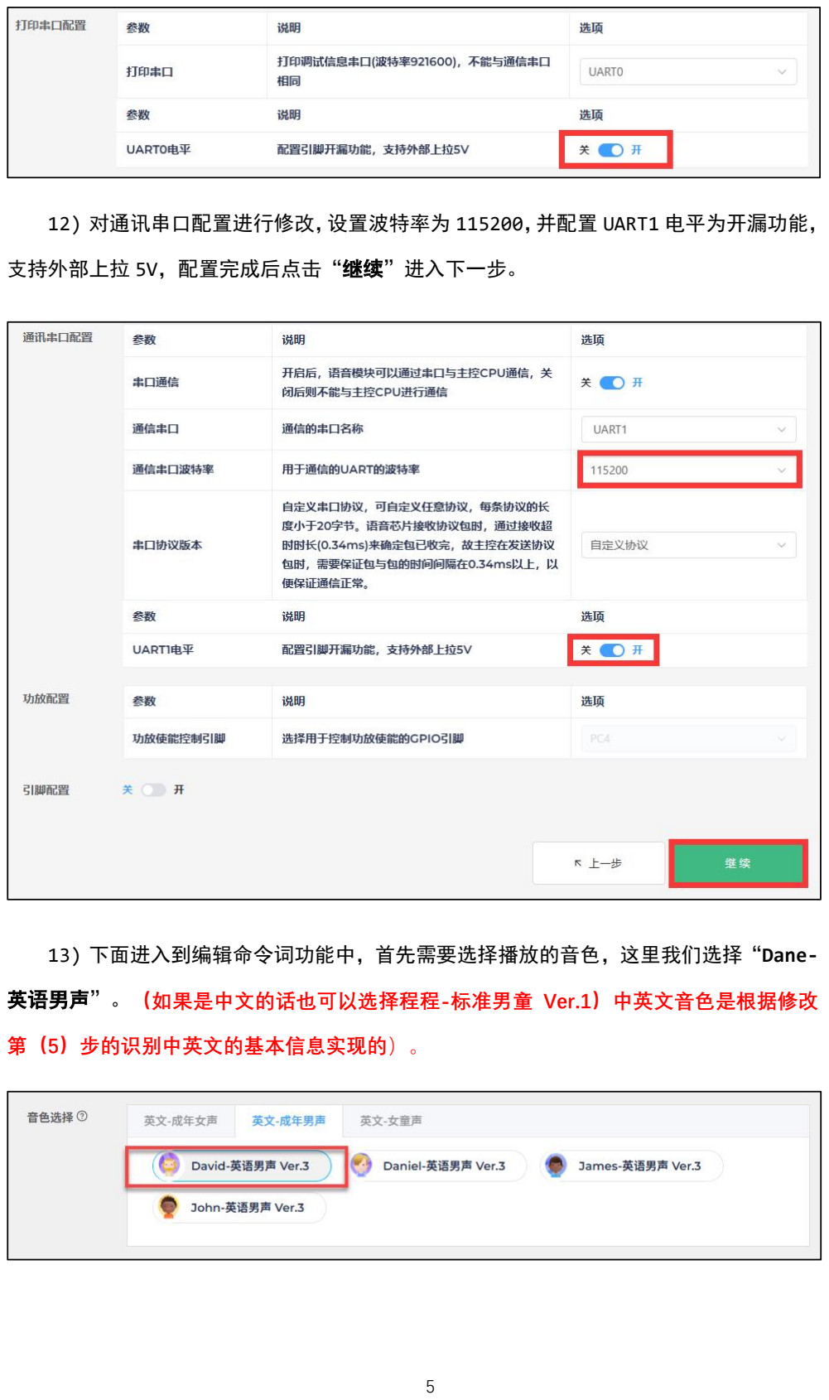
[picture p186: page 5]

12) 对通讯串口配置进行修改，设置波特率为 115200，并配置 UART1 电平为开漏功能，

支持外部上拉 5V，配置完成后点击“继续”进入下一步。

13) 下面进入到编辑命令词功能中，首先需要选择播放的音色，这里我们选择“Dane- 英语男声”。（如果是中文的话也可以选择程程-标准男童 Ver.1）中英文音色是根据修改

### 第（5）步的识别中英文的基本信息实现的）。

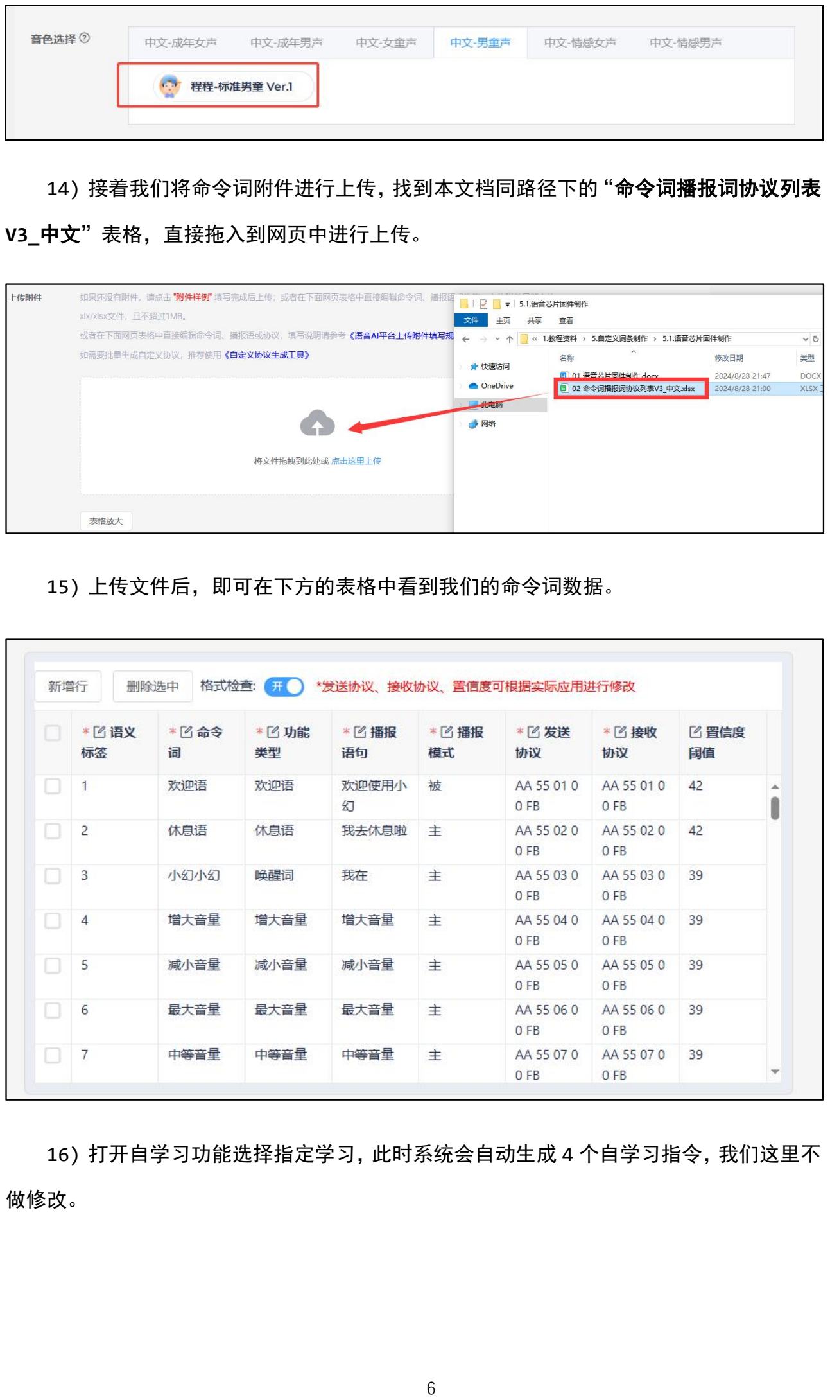
[picture p187: page 6]

14) 接着我们将命令词附件进行上传，找到本文档同路径下的“命令词播报词协议列表

V3_中文”表格，直接拖入到网页中进行上传。

15) 上传文件后，即可在下方的表格中看到我们的命令词数据。
16) 打开自学习功能选择指定学习，此时系统会自动生成 4 个自学习指令，我们这里不

做修改。

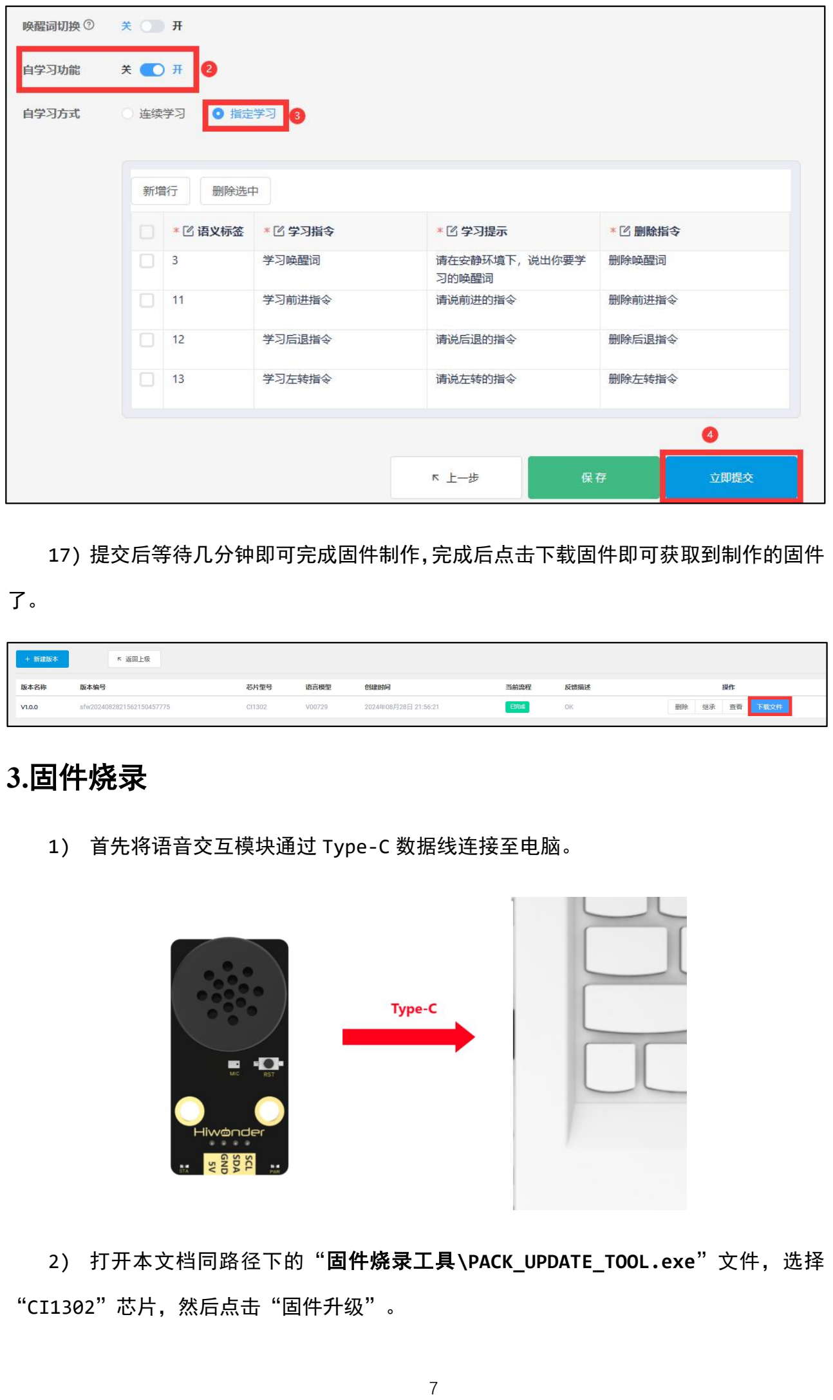
[picture p188: page 7]

17) 提交后等待几分钟即可完成固件制作，完成后点击下载固件即可获取到制作的固件

了。

## 3.固件烧录

1) 首先将语音交互模块通过 Type-C 数据线连接至电脑。
2) 打开本文档同路径下的“固件烧录工具\PACK_UPDATE_TOOL.exe”文件，选择

“CI1302”芯片，然后点击“固件升级”。

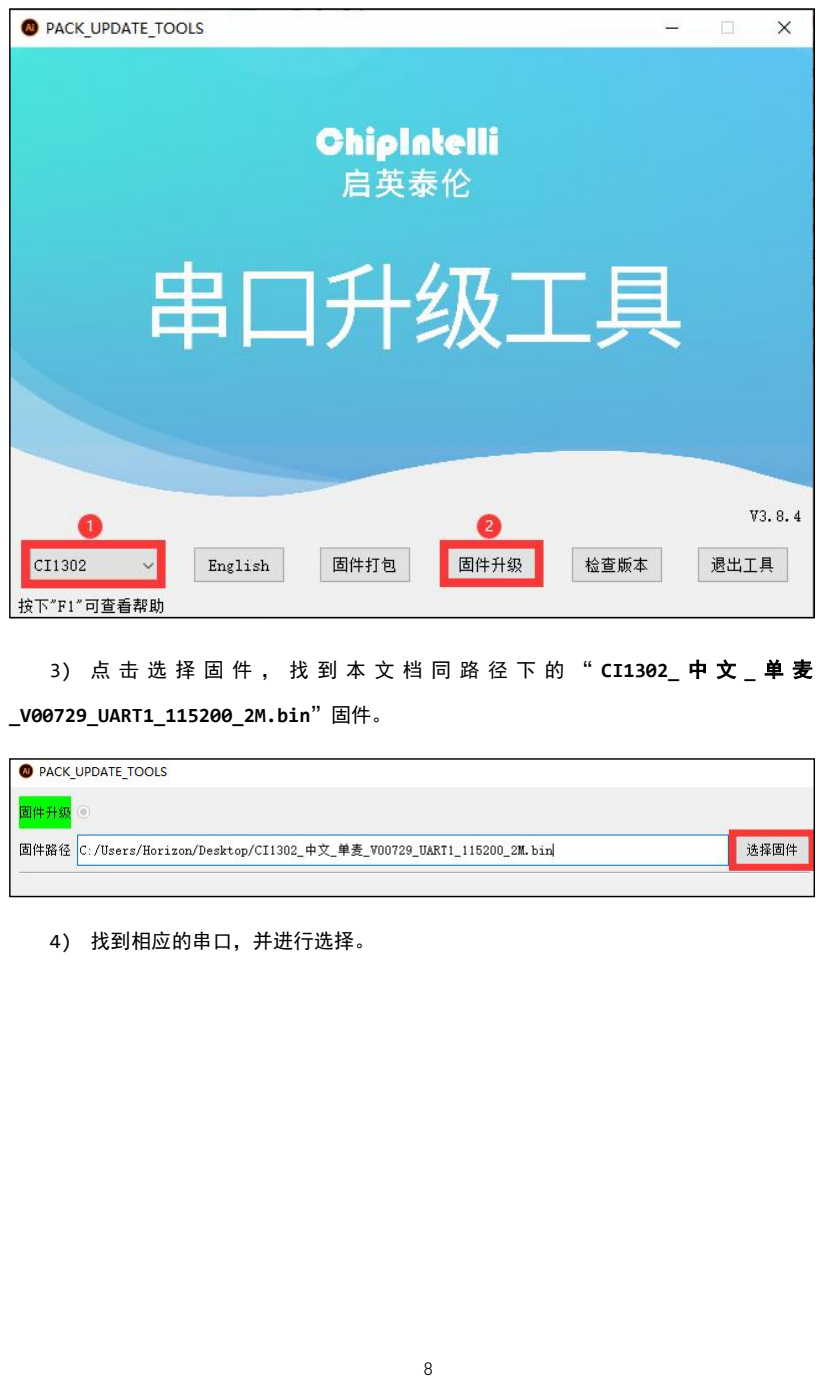
[picture p189: page 8]

3) 点 击 选 择 固 件 ， 找 到 本 文 档 同 路 径 下 的 “ CI1302_ 中 文 _ 单 麦

### _V00729_UART1_115200_2M.bin”固件。

4) 找到相应的串口，并进行选择。

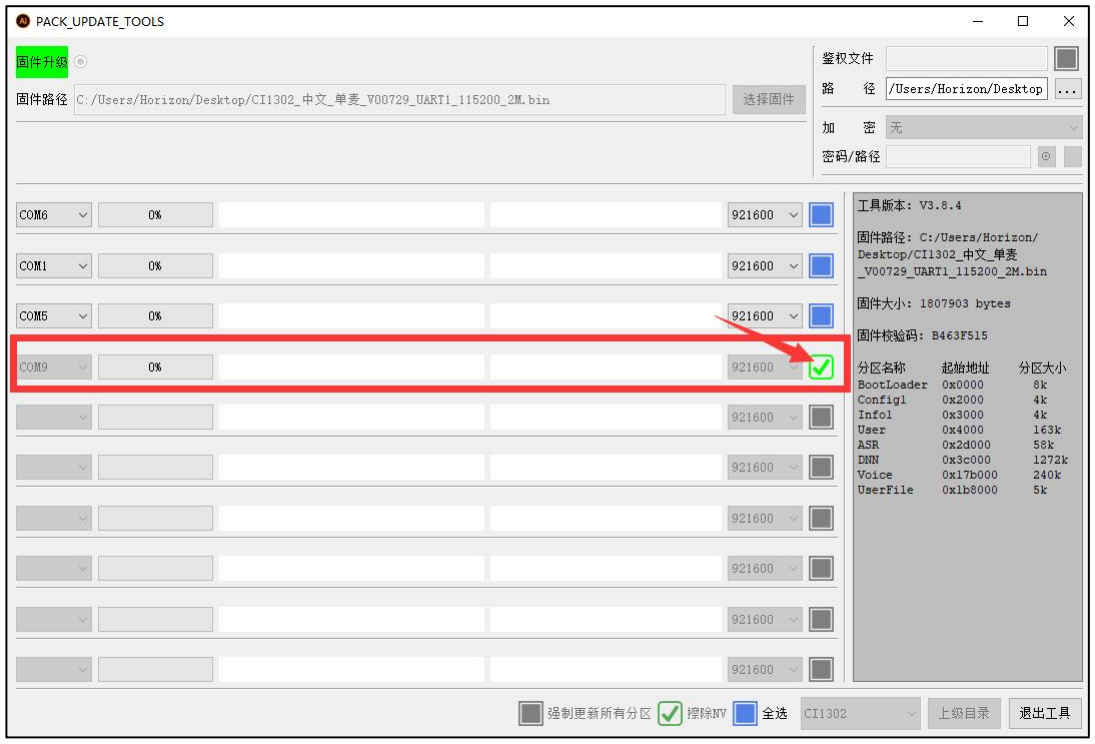
[picture p190: figure]

5) 接着按下语音交互模块上的 RST 键，即可进入到烧录中，等待烧录成功即可。
