MXDfc/ShanghaiTech_EE114-Embedded-Systems/Lab2and3/Device Data/AI语音交互/1.教程资料/5.自定义词条制作/5.2 修改功能性词条/5.2.1 修改功能性词条.pdf

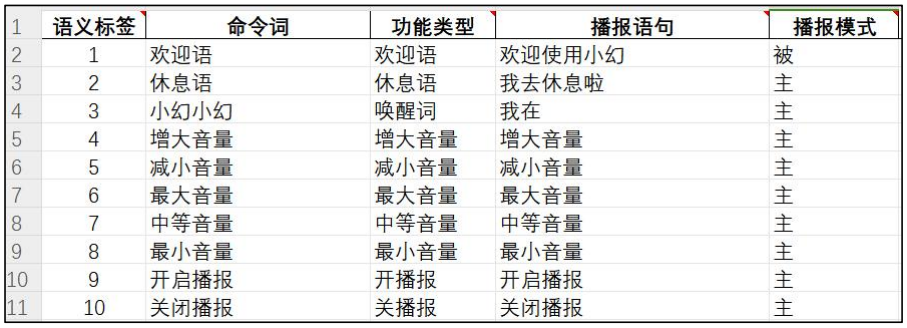
[picture p191: figure]
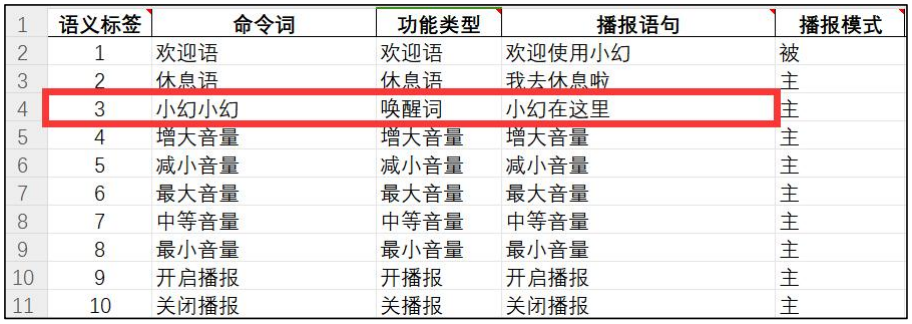
[picture p192: figure]

1

# 5.2.1 修改功能性词条

功能性词条修改步骤如下：

1) 打开本文档同路径下的“命令词播报词协议列表 V3_中文”表格。
2) 找到表格中的功能性词条，也就是表格中的前 10 项。需要注意的是，这里的前 10

条功能性词条均为固定词条，无法新增，只能进行修改。

3) 这里我们以修改唤醒词的播报语为例，将原先识别到“小幻小幻”后播报“我在”，

修改为播报“小幻在这里”。

4) 修好完后保存，接着按照“5.1 语音芯片固件制作”中的步骤，将表格导入到网

站中。如果已经制作过一次固件了，那么可以点击之前项目中的“继承”按键，这样可以省

去参数配置的步骤。

2

5) 重新制作固件后，还需要将固件烧录到语音交互模块中，这样就能实现修改功能性

词条了。
