MXDfc/ShanghaiTech_EE114-Embedded-Systems/Lab2and3/Device Data/AI语音交互/1.教程资料/5.自定义词条制作/5.3 新增命令词条/5.3.1 新增命令词条.pdf

1

# 5.3.1 新增命令词条

新增命令词条步骤如下：

1) 打开本文档同路径下的“命令词播报词协议列表 V3_中文”表格。
2) 在表格的最下方，增加新的命令词条，这里以新增一个“亮红灯”的命令词为例。
3) 这里需要将功能类型选择为“命令词”，同时播报模式需要设置为“主”，这样才

能在识别到“亮红灯”后主动播报“现在是红灯”。

4) 下面我们来了解一下发送协议，数据中的第 1 位和第 2 位是数据帧头，不需要修

改。当我们选择了功能类型为命令词，那么根据发送协议，第 3 位数据必须要为“00”，

这是为了区分指令为“命令词”还是“播报语”。

5) 第 4 位数据则是命令词的数据 ID，这是一个十六进制数据，因为前一个命令词的

ID 是“7A”，所以我们这一位需要设置为“7B”。在特殊情况下数据 ID 可以相同，例如

需要使两个命令词返回的结果一致时。

6) 协议中的第 5 位固定为“FB”，同样也不需要修改。在表格中，需要使发送协议

和接收协议一致。

2

7) 修好完后保存，接着按照“5.1 语音芯片固件制作”中的步骤，将表格导入到网

站中。如果已经制作过一次固件了，那么可以点击之前项目中的“继承”按键，这样可以省

去参数配置的步骤。

8) 重新制作固件后，还需要将固件烧录到语音交互模块中，这样就能实现新增命令词

条的功能了。
