MXDfc/ShanghaiTech_EE114-Embedded-Systems/Lab2and3/Device Data/AI语音交互/1.教程资料/5.自定义词条制作/5.4 新增播报语/5.4.1 新增播报语.pdf

1

# 5.4.1 新增播报语

新增播报语步骤如下：

1) 打开本文档同路径下的“命令词播报词协议列表 V3_中文”表格。
2) 在表格的最下方，增加新的命令词条，这里以新增一个“现在是绿灯”的播报语为

例。

3) 这里需要将功能类型选择为“播报语”，同时播报模式需要设置为“被”。
4) 下面我们来了解一下发送协议，数据中的第 1 位和第 2 位是数据帧头，不需要修

改。当我们选择了功能类型为播报语，那么根据发送协议，第 3 位数据必须要为“FF”，

这是为了区分指令为“播报语”。

5) 第 4 位数据则是命令词的数据 ID，这是一个十六进制数据，因为前一个播报语的

ID 是“0F”，所以我们这一位需要设置为“10”。

6) 协议中的第 5 位固定为“FB”，同样也不需要修改。在表格中，需要使发送协议

和接收协议一致。

7) 修好完后保存，接着按照“5.1 语音芯片固件制作”中的步骤，将表格导入到网

站中。如果已经制作过一次固件了，那么可以点击之前项目中的“继承”按键，这样可以省

去参数配置的步骤。

2

8) 重新制作固件后，还需要将固件烧录到语音交互模块中，这样就能实现新增播报语

的功能了。
