MXDfc/ShanghaiTech_EE114-Embedded-Systems/Lab6/WHEELTEC L150 避障巡线雷达小车资料/WHEELTEC L150系列小车安装视频/1. 底盘安装/R3mini全向轮小车底盘/R3mini全向轮小车底盘-3D模型/R3mini全向轮小车底盘-3D模型.stp

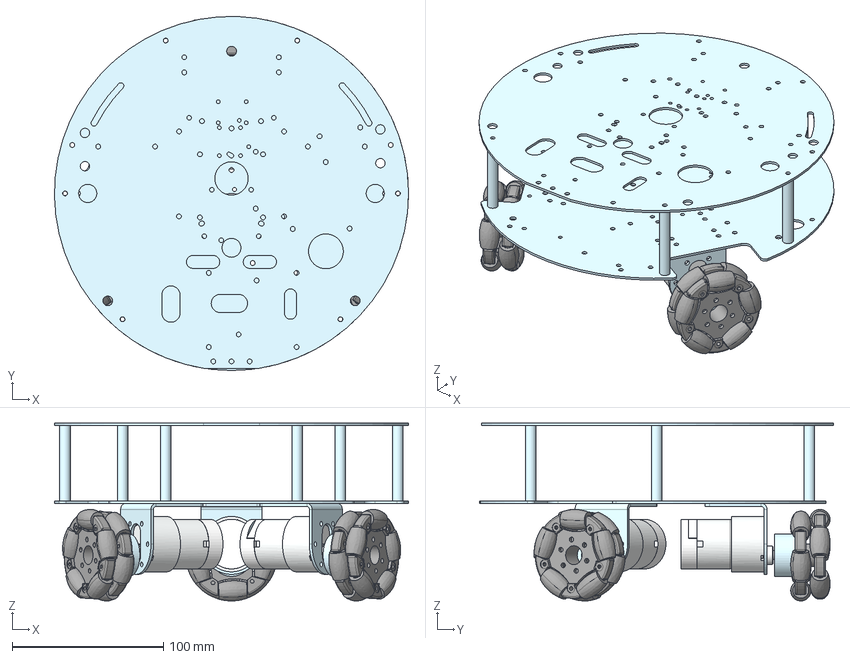
[picture p193: CAD file, 2026-10-19]
Lab6/WHEELTEC L150 避障巡线雷达小车资料/WHEELTEC L150系列小车安装视频/1. 底盘安装/R3mini全向轮小车底盘/R3mini全向轮小车底盘-3D模型/R3mini全向轮小车底盘-3D模型.stp
234.0 x 233.9 x 117.5 mm
全向轮底板_1
组装_60mm全向轮_1 x 3
M3-50 盓傅翐_1_1 x 6
全向轮顶层板_1
