MXDfc/ShanghaiTech_EE114-Embedded-Systems/(list of files, cad)

Other CAD files:
Lab6/WHEELTEC L150 避障巡线雷达小车资料/WHEELTEC L150系列小车安装视频/1. 底盘安装/R3mini四驱小车底盘（带悬挂）/R3mini四驱小车底盘CAD孔位/R3mini四驱小车底盘孔位图.dwg
Lab6/WHEELTEC L150 避障巡线雷达小车资料/WHEELTEC L150系列小车安装视频/1. 底盘安装/R3mini麦轮小车底盘（带悬挂）/R3mini麦轮小车底盘CAD孔位/R3mini麦轮小车底盘孔位图.dwg
