MXDfc/ShanghaiTech_EE114-Embedded-Systems/Lab6/WHEELTEC L150 避障巡线雷达小车资料/WHEELTEC L150 避障巡线雷达小车附送资料_V2.8_2025.05.15/4.智能车底盘运动学解析视频教程/轮式移动机器人的运动学模型.pdf

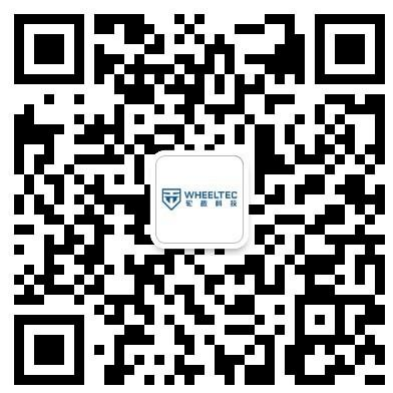
[picture p195: figure]

第 1 页 共 27 页

# 轮式移动机器人的运动学模型

推荐关注我们的公众号获取更新资料

版本说明：

版本 | 日期 | 内容说明
V1.0 | 2024/09/01 | 第一次发布

网址:www.wheeltec.net

第 2 页 共 27 页

目 录

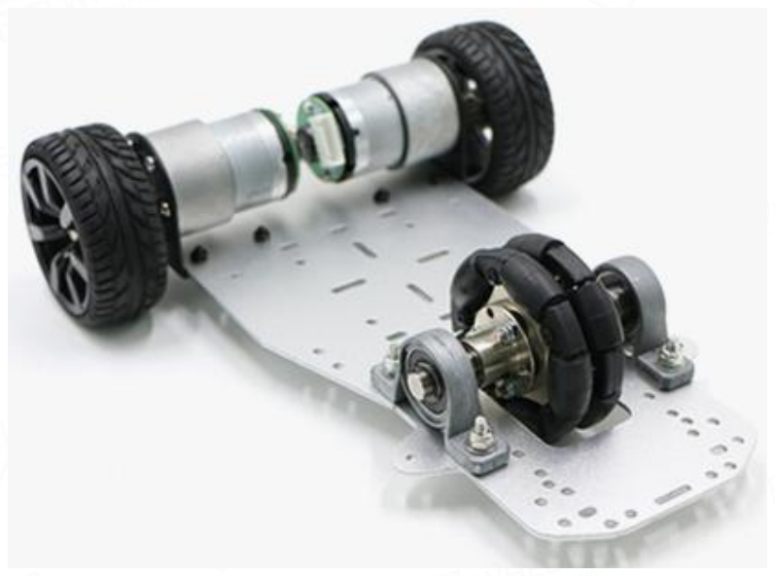
[picture p196: figure]

第 3 页 共 27 页

# 1. 前言

运动学是研究物体运动的几何方面的学科，它是力学的一个分支。运动学专

注于描述和测量位置的变化，而不涉及是什么原因导致了这种运动。运动学是描

述和理解机器人运动的基础，为更进一步的动力学分析以及控制系统的设计提供

了必要的信息，因此，对机器人的运动学分析是有意义的。

# 2. 两轮差速小车

两轮差速小车是常见的轮式机器人之一，它由两个共轴的独立驱动轮和轴线

之外的一个从动轮组成。它的控制最为简单，即通过控制两个轮子的转速差来实

现直行运动和转向运动。

图 2-1 两轮差速小车的实物图

下面对两轮差速小车进行运动学分析，建立运动学模型。为了易于说明，建

立如图 2-2 所示的坐标系，其中坐标原点为驱动轮转轴的中心。

表 2-1 符号说明

| 驱动轮轮距 m
| 小车的转向速度 rad s
| 小车的前进速度 m s
L | 左轮的前进速度 m s
R | 右轮的前进速度 m s

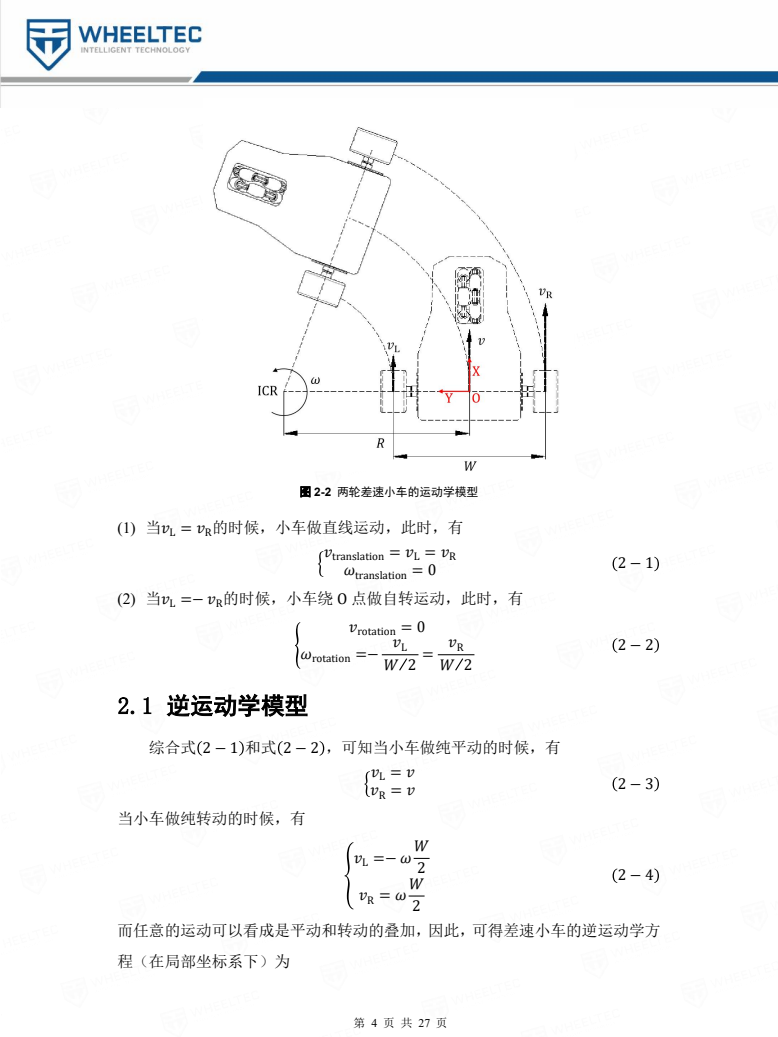
[picture p197: page 4]
图 2-2 两轮差速小车的运动学模型 translation = L = R translation = 0; rotation = 0 rotation =−; 当小车做纯转动的时候，有; 程（在局部坐标系下）为

(1) 当L = R的时候，小车做直线运动，此时，有

(2) 当L =− R的时候，小车绕 O 点做自转运动，此时，有

2.1 逆运动学模型
综合式 2 − 1 和式 2 − 2 ，可知当小车做纯平动的时候，有

而任意的运动可以看成是平动和转动的叠加，因此，可得差速小车的逆运动学方

L
R =

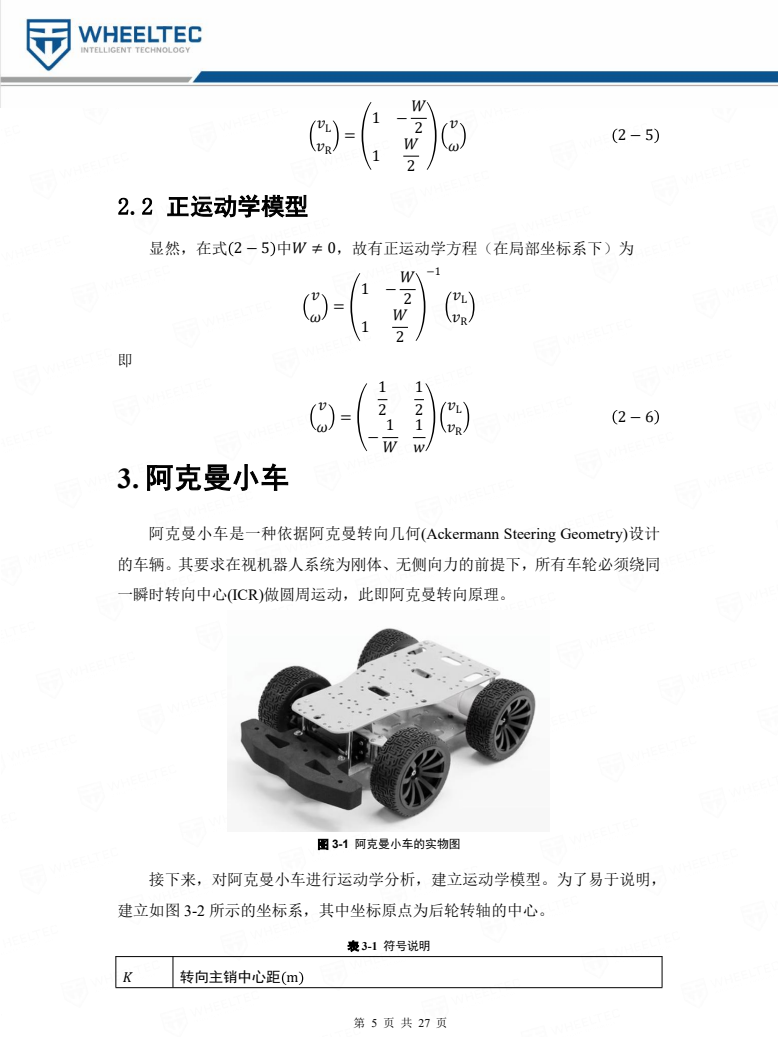
[picture p198: page 5]
2.2 正运动学模型 显然，在式 2 − 5 中 ≠ 0，故有正运动学方程（在局部坐标系下）为   =; 3. 阿克曼小车; 图 3-1 阿克曼小车的实物图; 表 3-1 符号说明; 转向主销中心距 m

阿克曼小车是一种依据阿克曼转向几何(Ackermann Steering Geometry)设计

的车辆。其要求在视机器人系统为刚体、无侧向力的前提下，所有车轮必须绕同
一瞬时转向中心(ICR)做圆周运动，此即阿克曼转向原理。

接下来，对阿克曼小车进行运动学分析，建立运动学模型。为了易于说明，
建立如图 3-2 所示的坐标系，其中坐标原点为后轮转轴的中心。

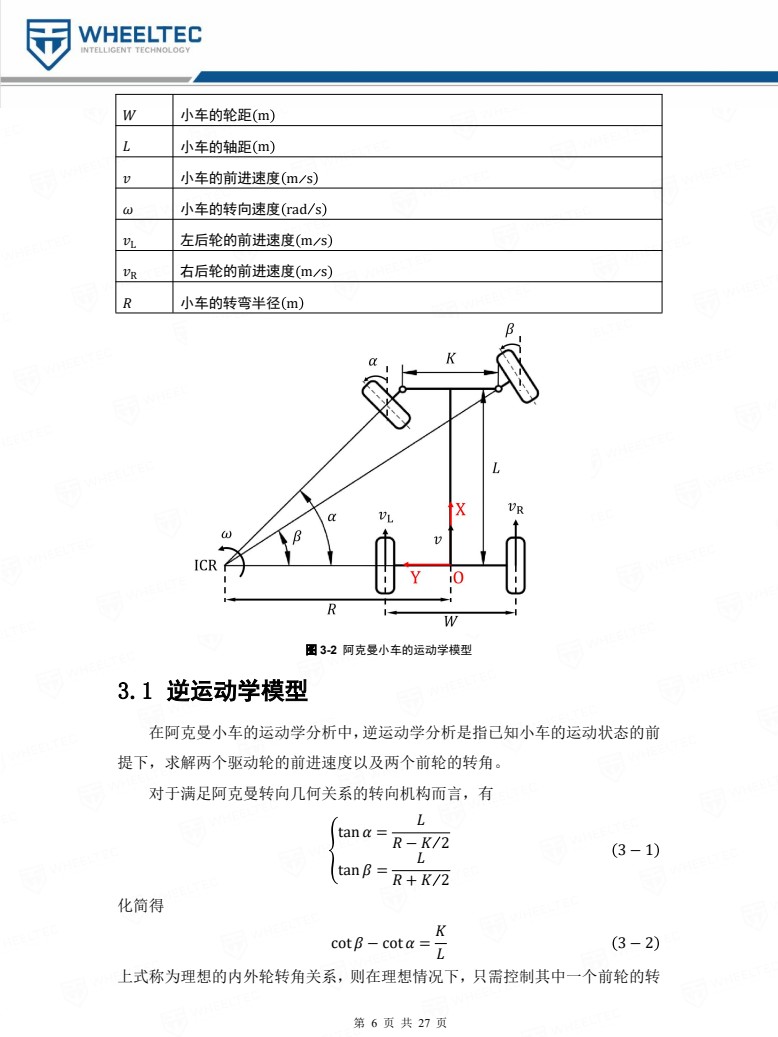
[picture p199: page 6]
小车的转弯半径 m; 图 3-2 阿克曼小车的运动学模型; 3.1 逆运动学模型; 在阿克曼小车的运动学分析中，逆运动学分析是指已知小车的运动状态的前; 提下，求解两个驱动轮的前进速度以及两个前轮的转角。; 对于满足阿克曼转向几何关系的转向机构而言，有 tan  =; tan  =; 化简得; cot  − cot  =

| 小车的轮距 m

 | 小车的轴距 m

 | 小车的前进速度 m s

 | 小车的转向速度 rad s

L | 左后轮的前进速度 m s

R | 右后轮的前进速度 m s

上式称为理想的内外轮转角关系，则在理想情况下，只需控制其中一个前轮的转

L R 。

# = tan

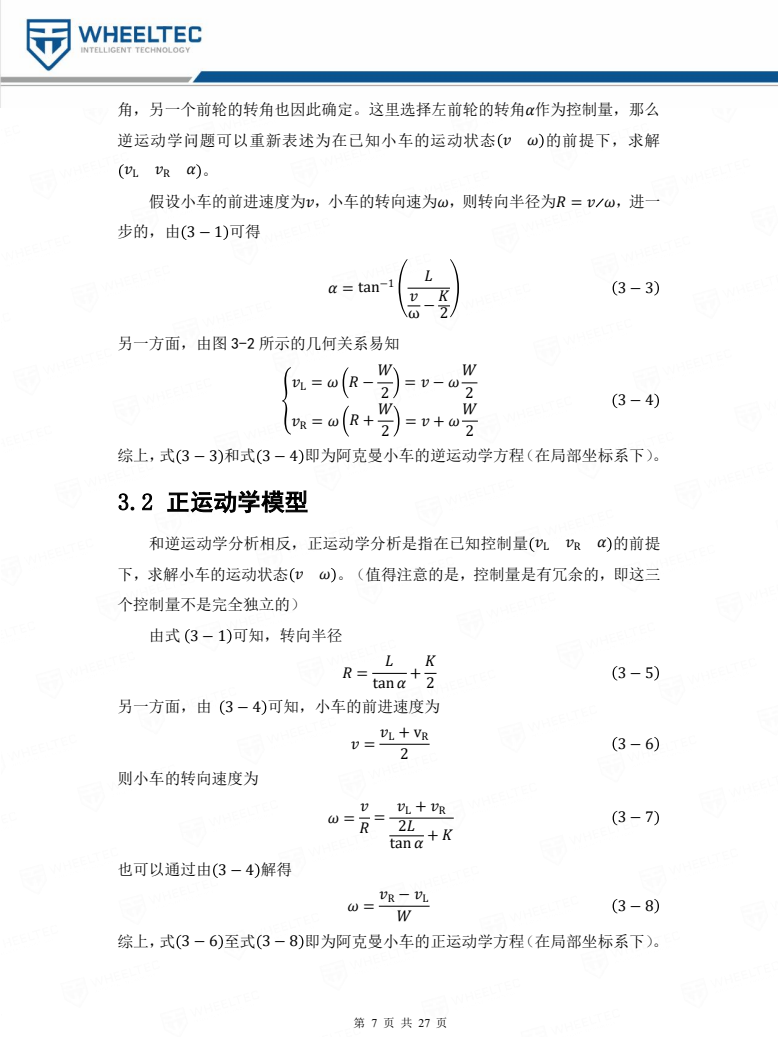
[picture p200: page 7]
假设小车的前进速度为，小车的转向速为，则转向半径为 =  ，进一; 3.2 正运动学模型 和逆运动学分析相反，正运动学分析是指在已知控制量 L R  的前提  =;  tan ; 则小车的转向速度为; L + R 2 tan ; 也可以通过由 3 − 4 解得

角，另一个前轮的转角也因此确定。这里选择左前轮的转角作为控制量，那么
逆运动学问题可以重新表述为在已知小车的运动状态   的前提下，求解

另一方面，由图 3-2 所示的几何关系易知

综上，式 3 − 3 和式 3 − 4 即为阿克曼小车的逆运动学方程（在局部坐标系下）。

下，求解小车的运动状态   。（值得注意的是，控制量是有冗余的，即这三

由式 3 − 1 可知，转向半径
个控制量不是完全独立的）

另一方面，由 3 − 4 可知，小车的前进速度为

综上，式 3 − 6 至式 3 − 8 即为阿克曼小车的正运动学方程（在局部坐标系下）。

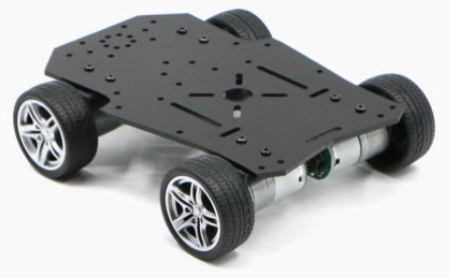
[picture p201: figure]
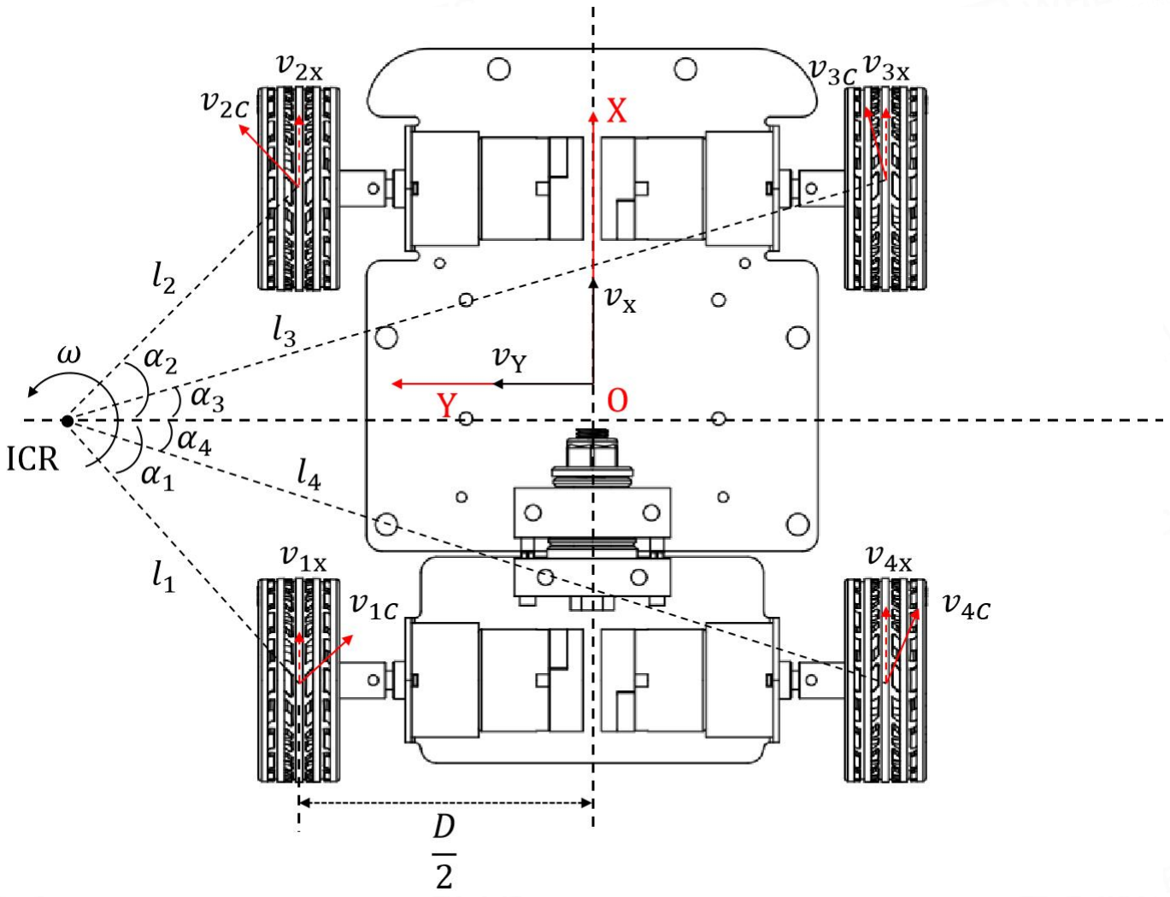
[picture p202: figure]

第 8 页 共 27 页

# 4. 四轮驱动小车

四轮驱动小车是指在整个行驶过程中一直保持着四轮驱动形式的普通轮式

小车（非全向轮），因为其出色的越障能力，使得其在野外非机构化场景中有着

广泛的应用。

图 4-1 四轮驱动小车的实物图

图 4-2 四轮驱动小车的运动状态

在进行运动学分析之前，先考察一下四轮驱动小车的特点。如图 4-2 所示，

给定小车的运动状态，可以容易求得理想情况下四个车轮质心的速度。这里只考

虑它们的纵向分速度，有

# 1x = 1c cos 1 = 1 cos 1 = ICR −

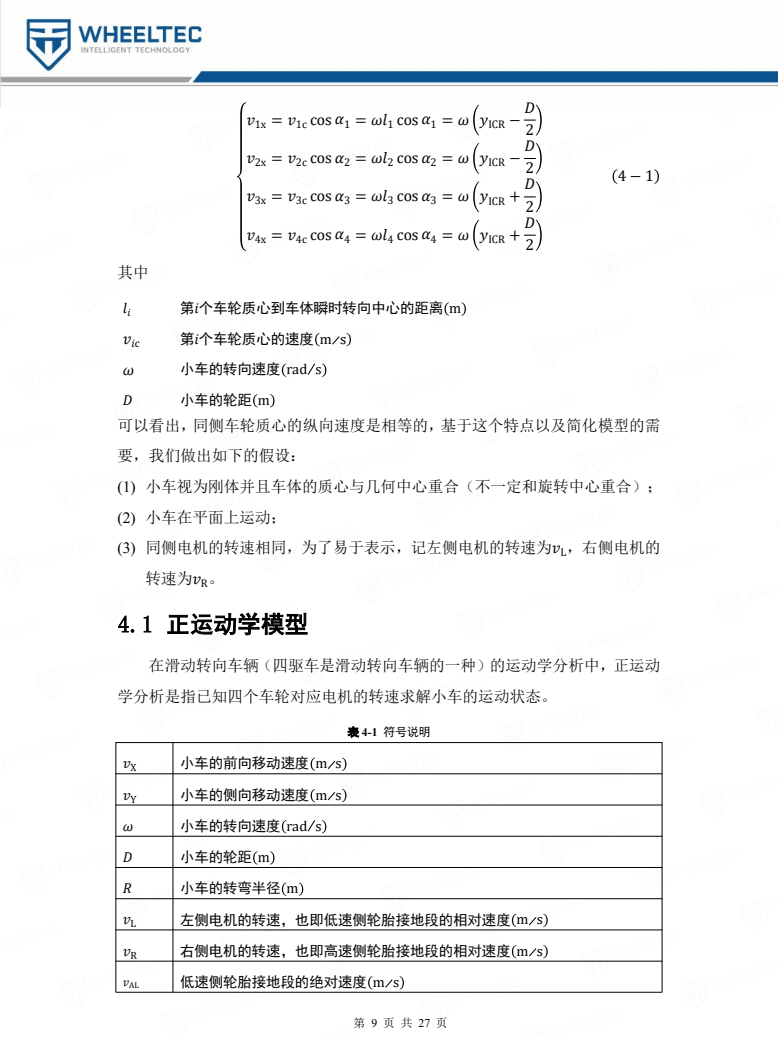
[picture p203: page 9]
其中  第个车轮质心到车体瞬时转向中心的距离 m; c 第个车轮质心的速度 m s;  小车的转向速度 rad s;  小车的轮距 m; 4.1 正运动学模型; 学分析是指已知四个车轮对应电机的转速求解小车的运动状态。; 表 4-1 符号说明

2x = 2c cos 2 = 2 cos 2 =  ICR −
3x = 3c cos 3 = 3 cos 3 =  ICR +
4x = 4c cos 4 = 4 cos 4 =  ICR +

可以看出，同侧车轮质心的纵向速度是相等的，基于这个特点以及简化模型的需

要，我们做出如下的假设：
(1) 小车视为刚体并且车体的质心与几何中心重合（不一定和旋转中心重合）；
(3) 同侧电机的转速相同，为了易于表示，记左侧电机的转速为L，右侧电机的
(2) 小车在平面上运动；
转速为R。

在滑动转向车辆（四驱车是滑动转向车辆的一种）的运动学分析中，正运动

X | 小车的前向移动速度 m s

Y | 小车的侧向移动速度 m s

 | 小车的转向速度 rad s

 | 小车的轮距 m

 | 小车的转弯半径 m

L | 左侧电机的转速，也即低速侧轮胎接地段的相对速度 m s

R | 右侧电机的转速，也即高速侧轮胎接地段的相对速度 m s AL 低速侧轮胎接地段的绝对速度 m s

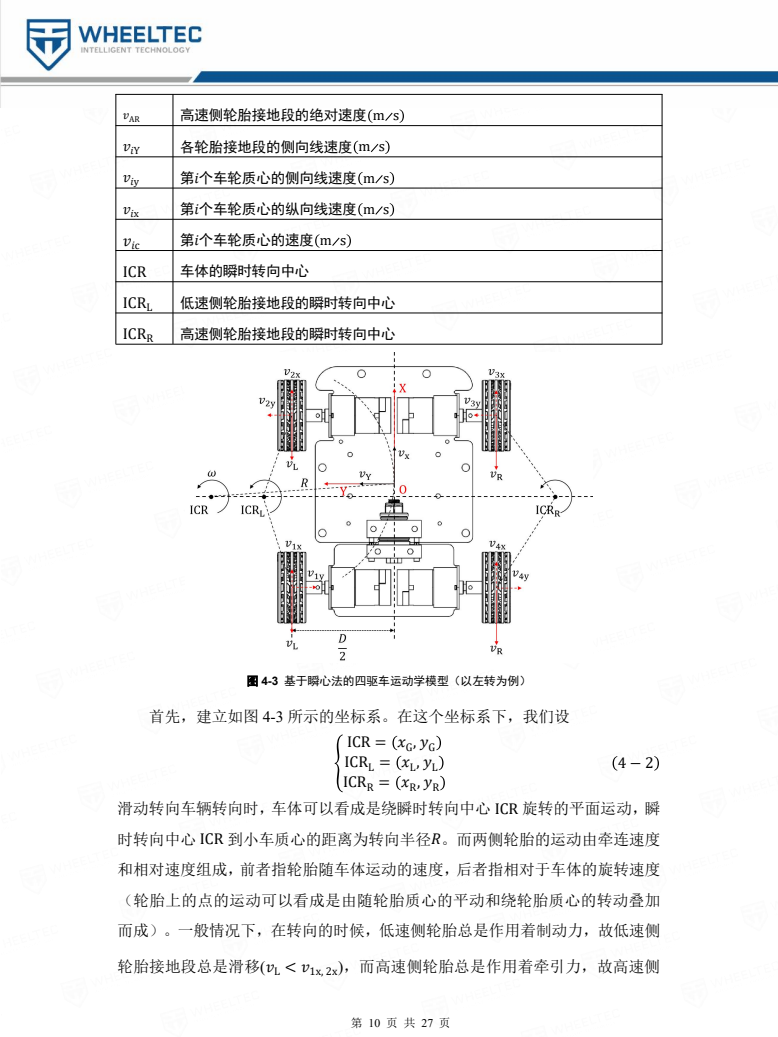
[picture p204: page 10]
ICRR; 高速侧轮胎接地段的瞬时转向中心; 图 4-3 基于瞬心法的四驱车运动学模型（以左转为例） ICR = G, G ICRL = L; , L ICRR = R, R; （轮胎上的点的运动可以看成是由随轮胎质心的平动和绕轮胎质心的转动叠加; )，而高速侧轮胎总是作用着牵引力，故高速侧

AR | 高速侧轮胎接地段的绝对速度 m s

Y | 各轮胎接地段的侧向线速度 m s

y | 第个车轮质心的侧向线速度 m s

x | 第个车轮质心的纵向线速度 m s

c | 第个车轮质心的速度 m s

ICR | 车体的瞬时转向中心

ICRL | 低速侧轮胎接地段的瞬时转向中心

首先，建立如图 4-3 所示的坐标系。在这个坐标系下，我们设

滑动转向车辆转向时，车体可以看成是绕瞬时转向中心 ICR 旋转的平面运动，瞬

时转向中心 ICR 到小车质心的距离为转向半径。而两侧轮胎的运动由牵连速度

和相对速度组成，前者指轮胎随车体运动的速度，后者指相对于车体的旋转速度

而成）。一般情况下，在转向的时候，低速侧轮胎总是作用着制动力，故低速侧
轮胎接地段总是滑移(L < 1x, 2x

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

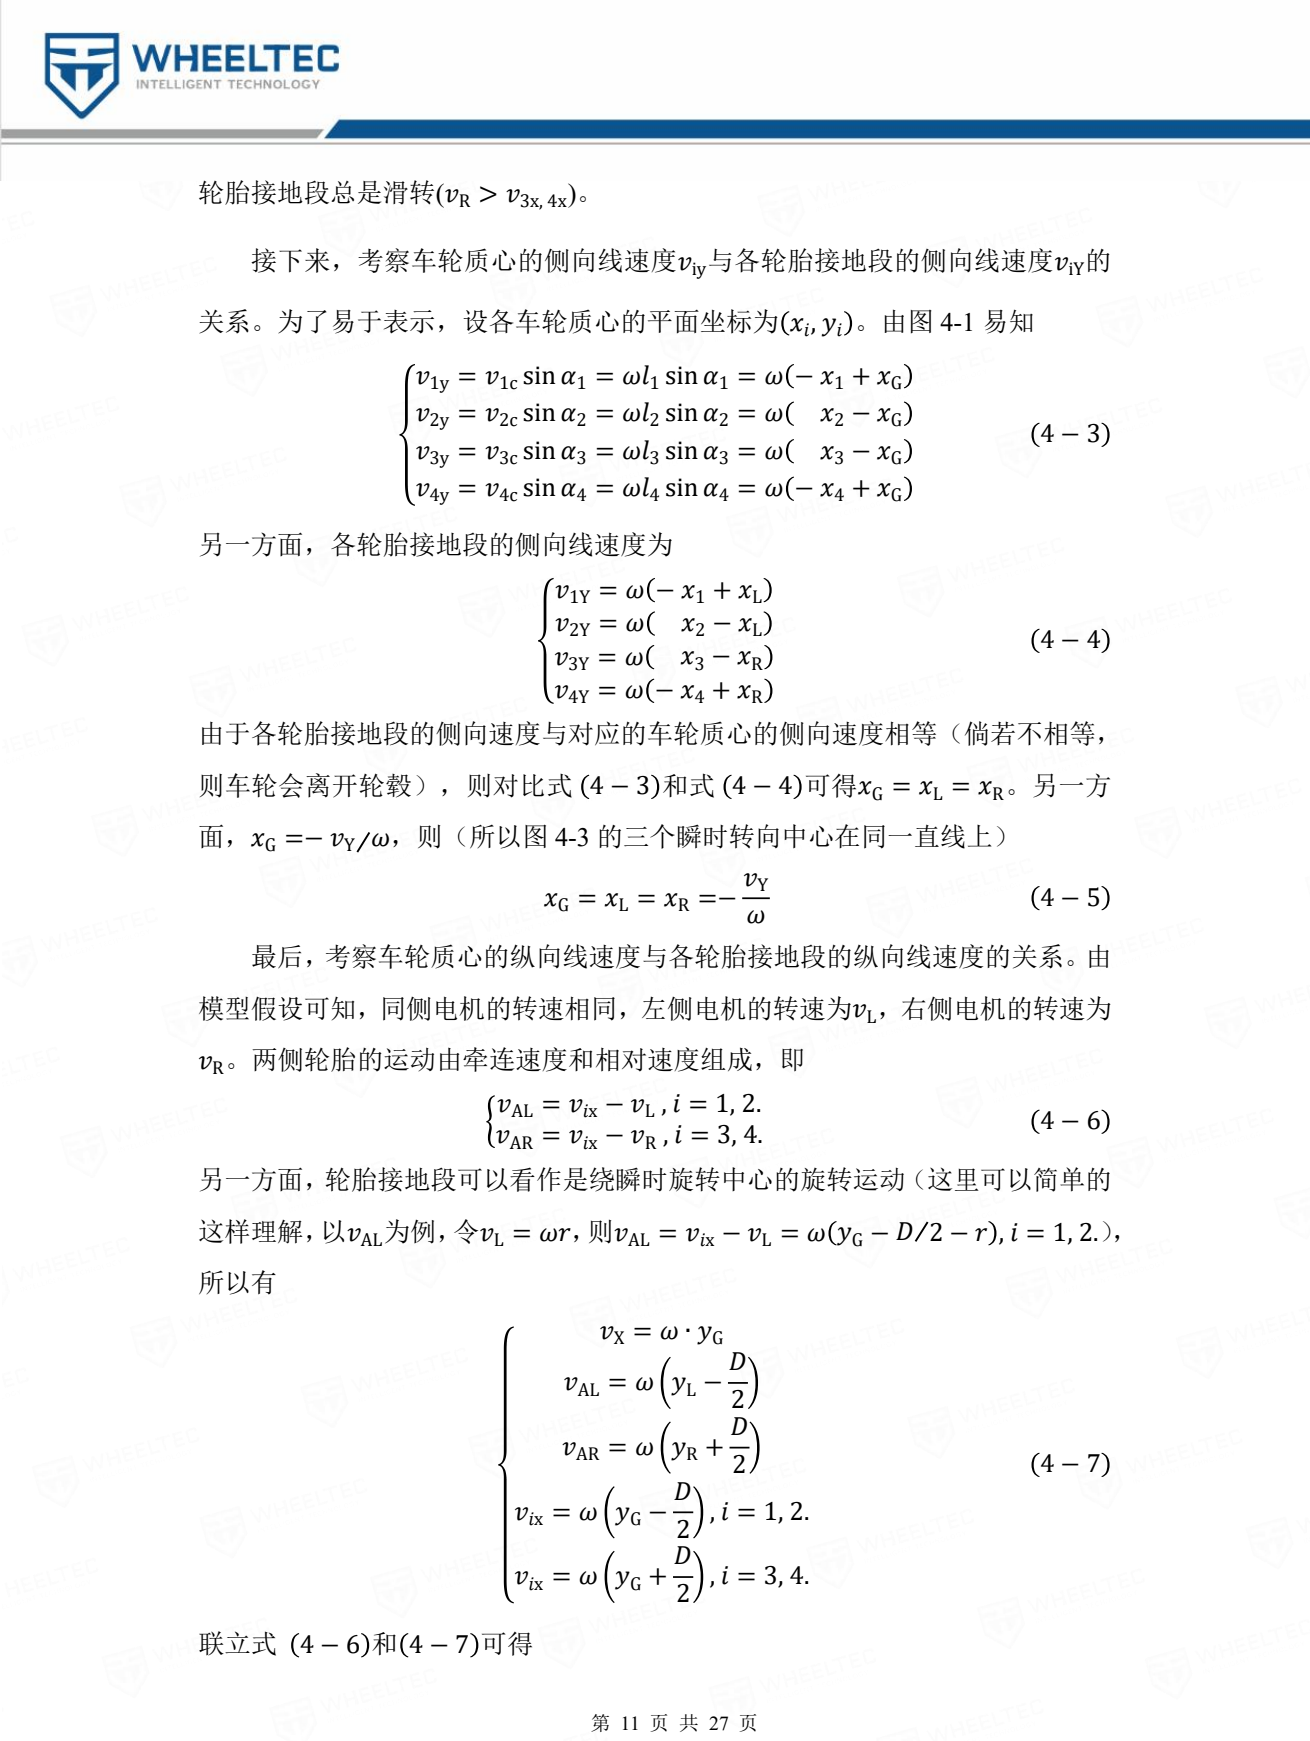
[picture p205: page 11]

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

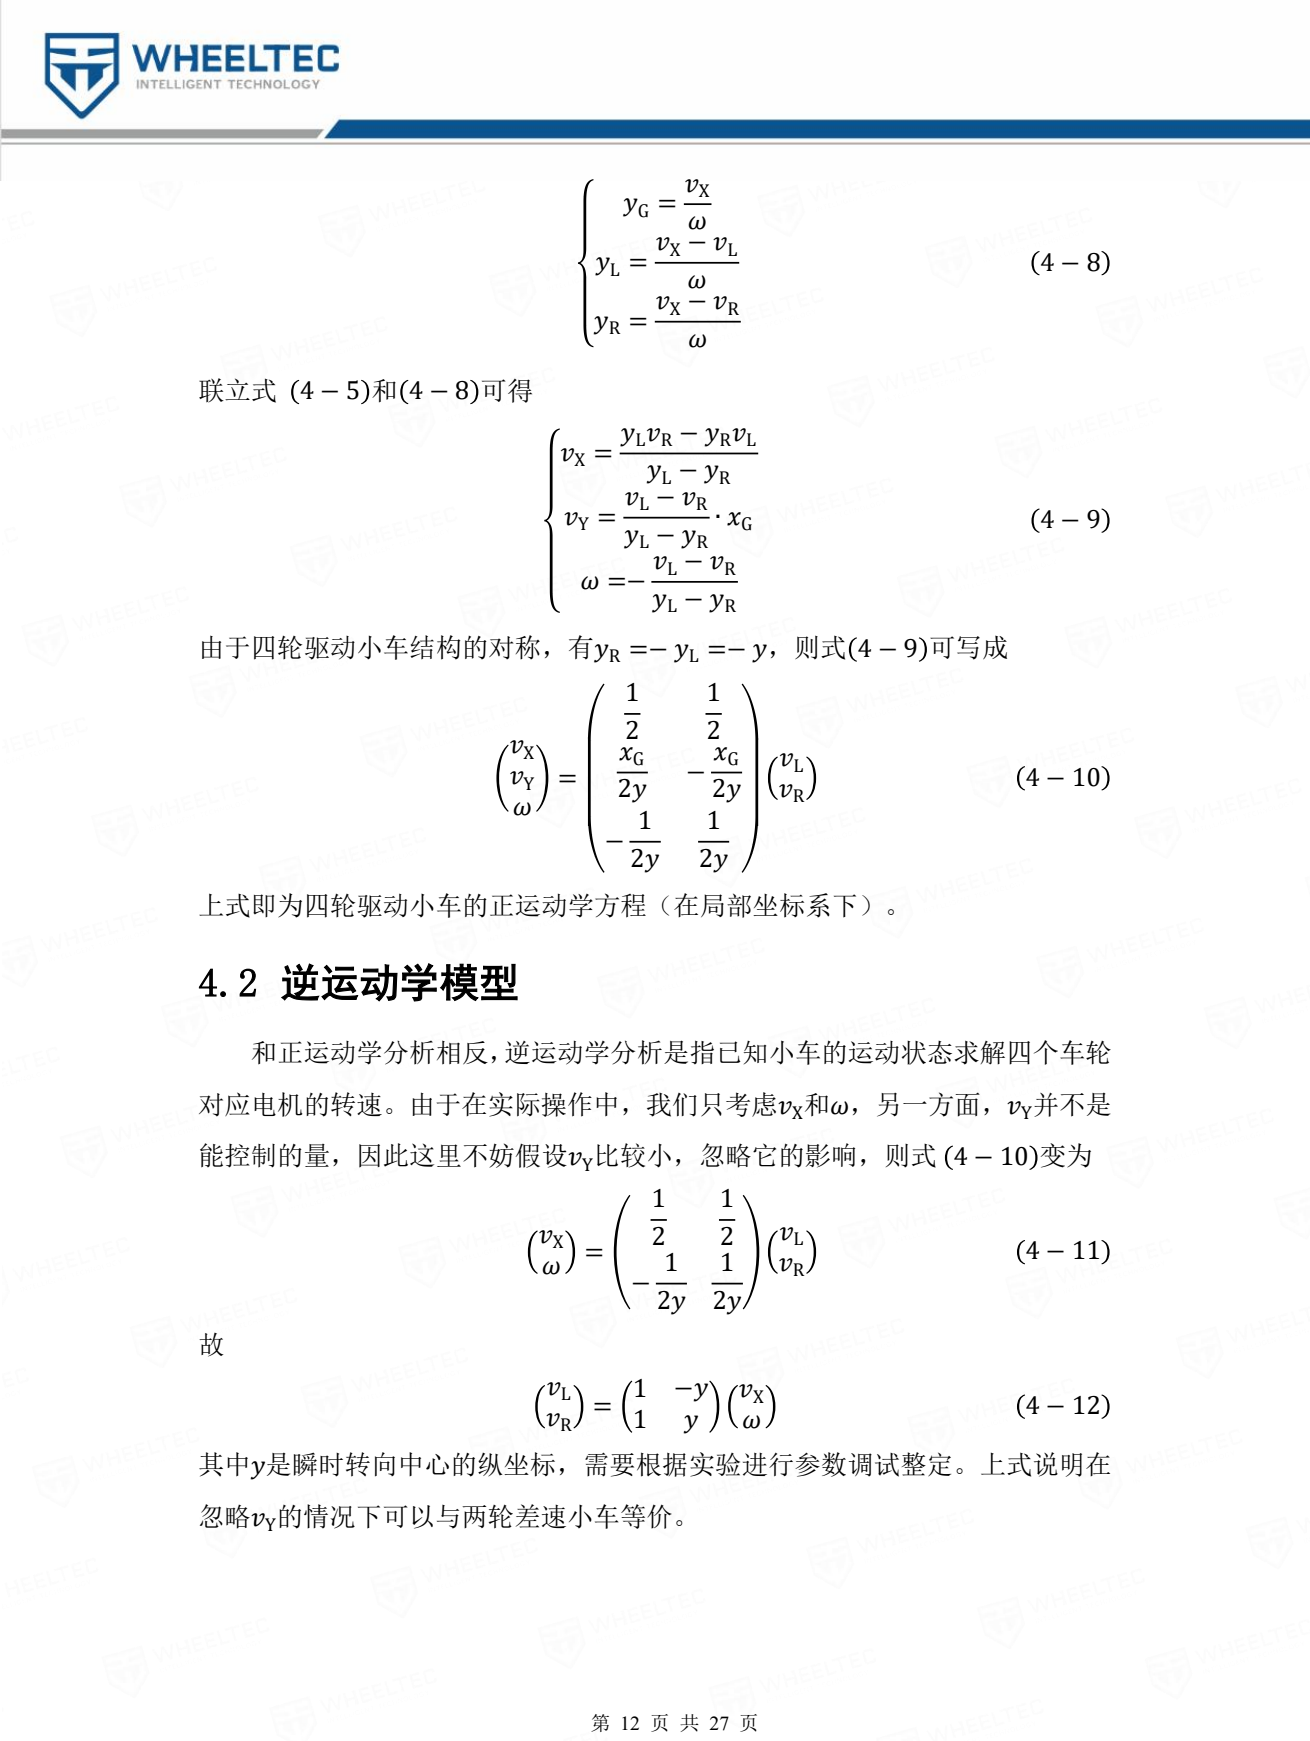
[picture p206: page 12]

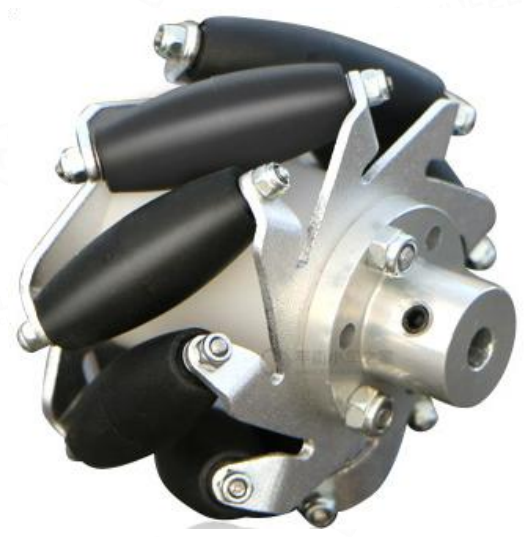
[picture p207: figure]
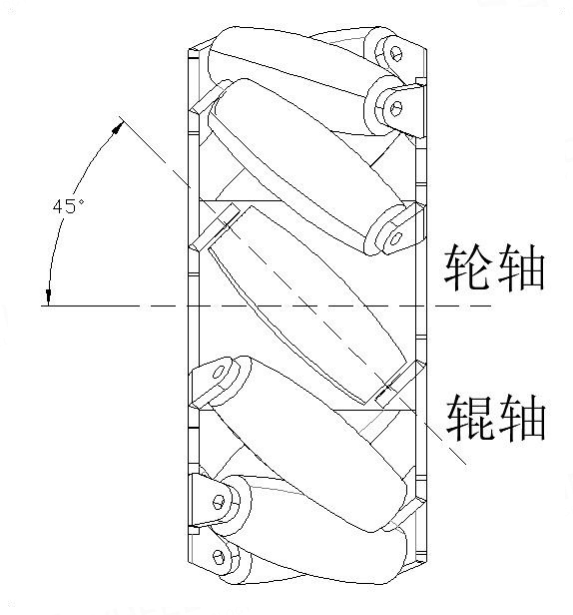
[picture p208: figure]

第 13 页 共 27 页

# 5. 麦克纳姆轮小车

## 麦克纳姆轮(Mecanum Wheel)，又称为艾隆轮(Ilon Wheel)，是一种全向轮。

其由轮毂和固定在外周的许多小辊子构成，轮轴和辊轴之间的夹角通常为 45°。

每个轮子具有 3 个自由度，分别是绕轮轴转动，沿垂直于与地面接触的辊子的轴

心方向移动，绕轮子和地面的接触点转动。根据机械原理，机构的原动件数应该

等于机构的自由度，因此，若要实现 3 个自由度的控制，则应该有 3 个独立的输

入。而每个麦克纳姆轮可以看作 1 个原动件，因此，若要实现平面 3 个自由度的

控制，就应该至少有 3 个麦克纳姆轮。也就是说，理论上只要有 3 个这样的轮子

组成的移动平台便可实现全向移动。但是，在实际应用中，麦克纳姆轮都是成对

使用的，2 个左旋轮，2 个右旋轮，其中左旋轮和右旋轮呈手性对称，这样既可

以增加机构的稳定性，又方便控制，同时还提升了载重能力。

图 5-1 麦克纳姆轮的实物图 | 图 5-2 麦克纳姆轮的轮轴和辊轴

下面对麦克纳姆轮小车进行运动学分析，建立运动学模型。为了简化模型，

做出如下三点假设：

(1) 小车是刚体；
(2) 小车的运动局限在平面上，忽略地面的凹凸不平及其带来的影响；
(3) 车轮不与地面打滑。

## 5.1 逆运动学模型

在麦克纳姆轮小车的运动学分析中，逆运动学分析是指已知小车的运动状态

求解 4 个车轮对应的电机的转速。为了易于说明，建立如图 5-4 所示的坐标系，

| 小车的角速度 rad/s

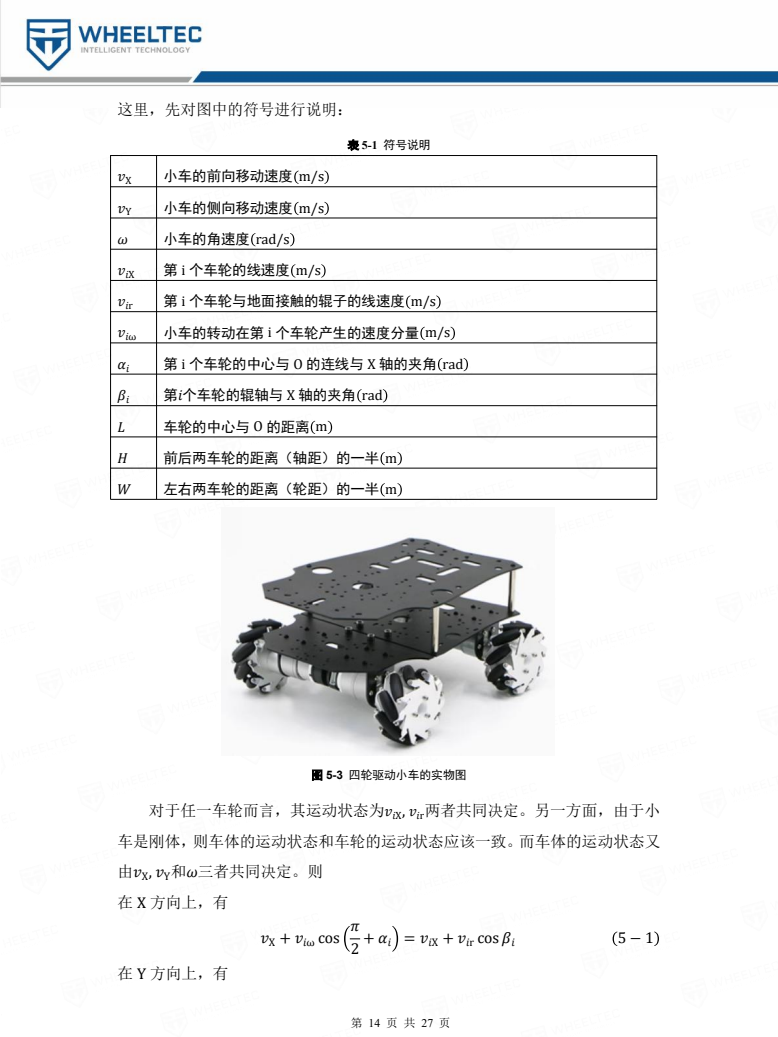
[picture p209: page 14]
这里，先对图中的符号进行说明：; 表 5-1 符号说明; 左右两车轮的距离（轮距）的一半 m; 图 5-3 四轮驱动小车的实物图; 车是刚体，则车体的运动状态和车轮的运动状态应该一致。而车体的运动状态又; , Y和三者共同决定。则; 在 X 方向上，有; X + ω cos; 2 +  = X + r cos ; 在 Y 方向上，有

X | 小车的前向移动速度 m/s

Y | 小车的侧向移动速度 m/s

X | 第 i 个车轮的线速度 m/s

r | 第 i 个车轮与地面接触的辊子的线速度 m/s

ω | 小车的转动在第 i 个车轮产生的速度分量 m/s

 | 第 i 个车轮的中心与 O 的连线与 X 轴的夹角 rad

 | 第个车轮的辊轴与 X 轴的夹角 rad

 | 车轮的中心与 O 的距离 m

 | 前后两车轮的距离（轴距）的一半 m

对于任一车轮而言，其运动状态为X, r两者共同决定。另一方面，由于小

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

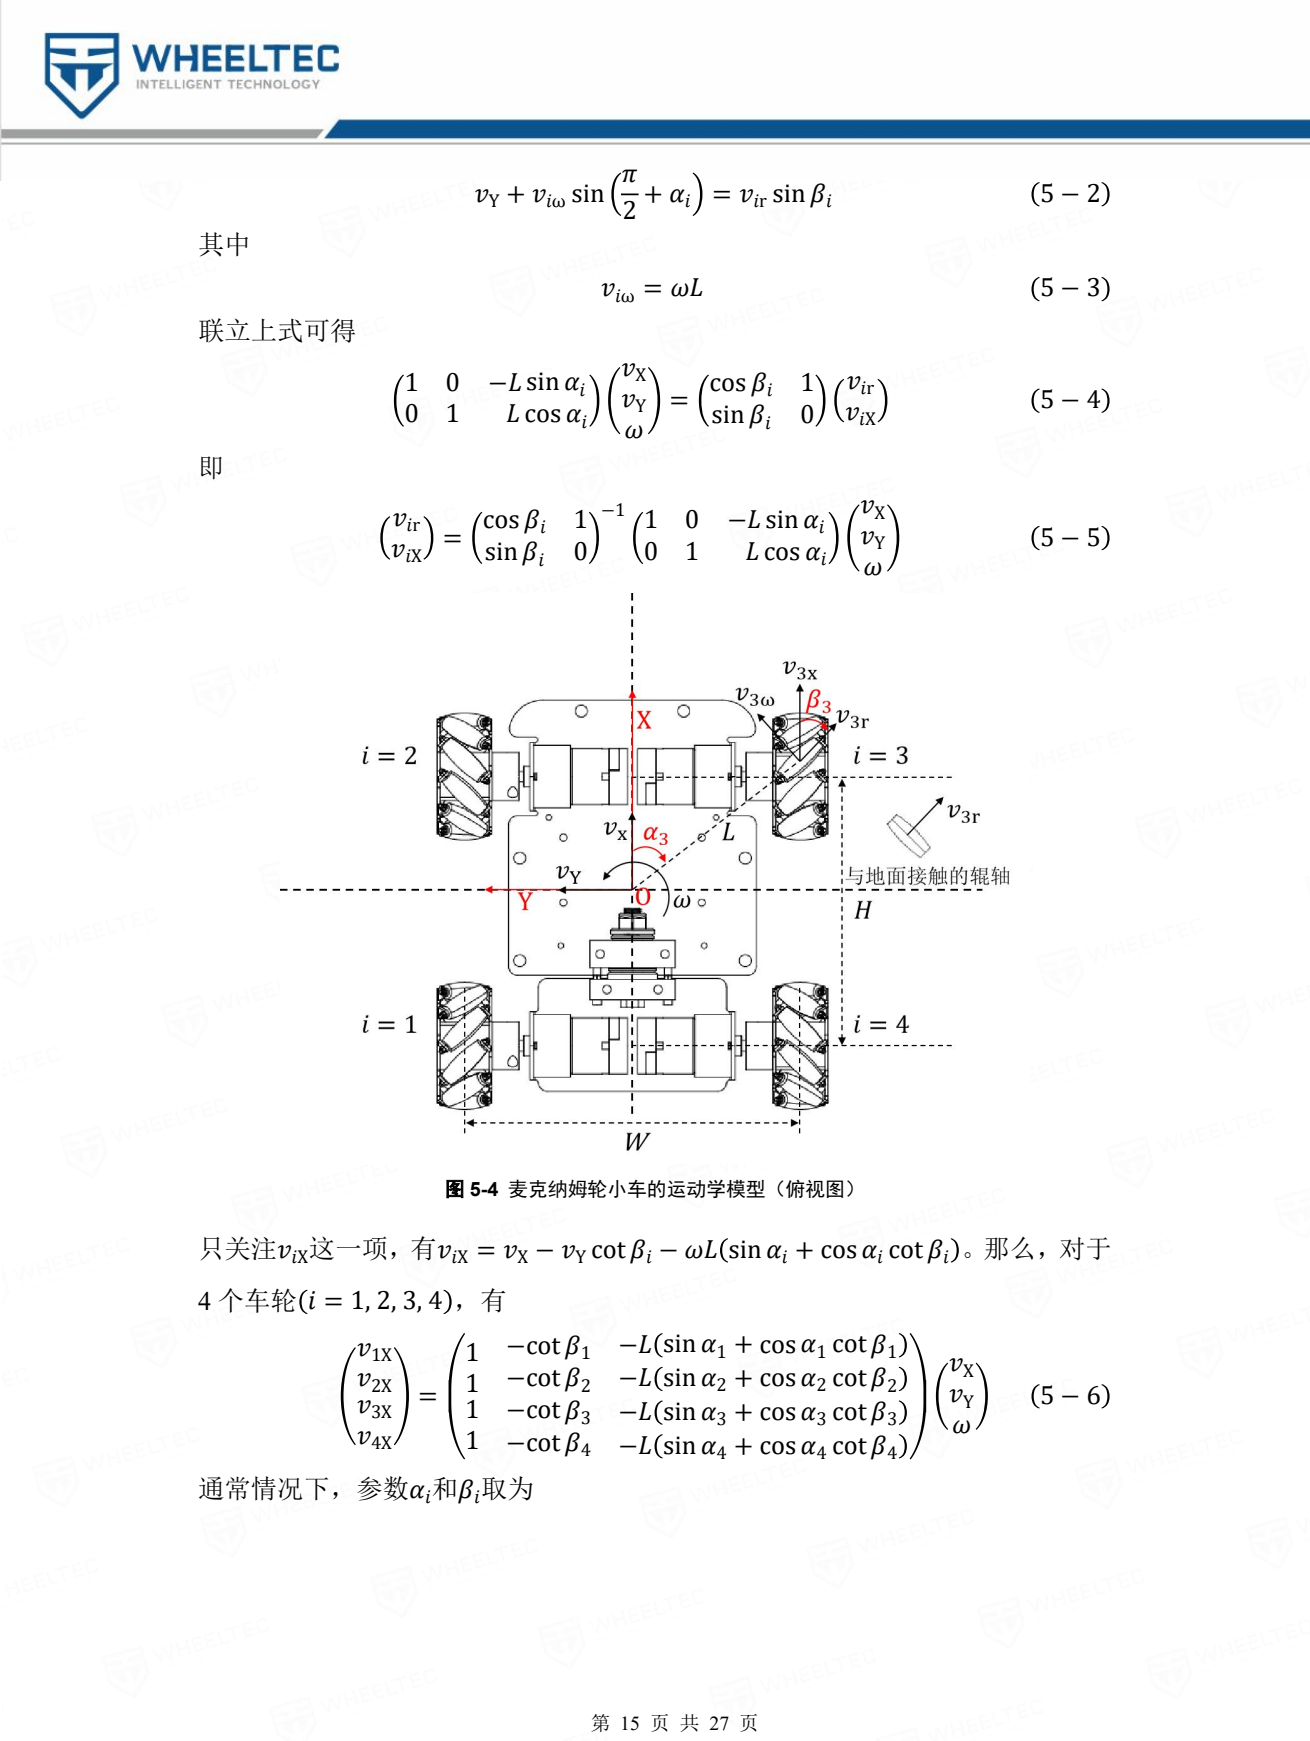
[picture p210: page 15]

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

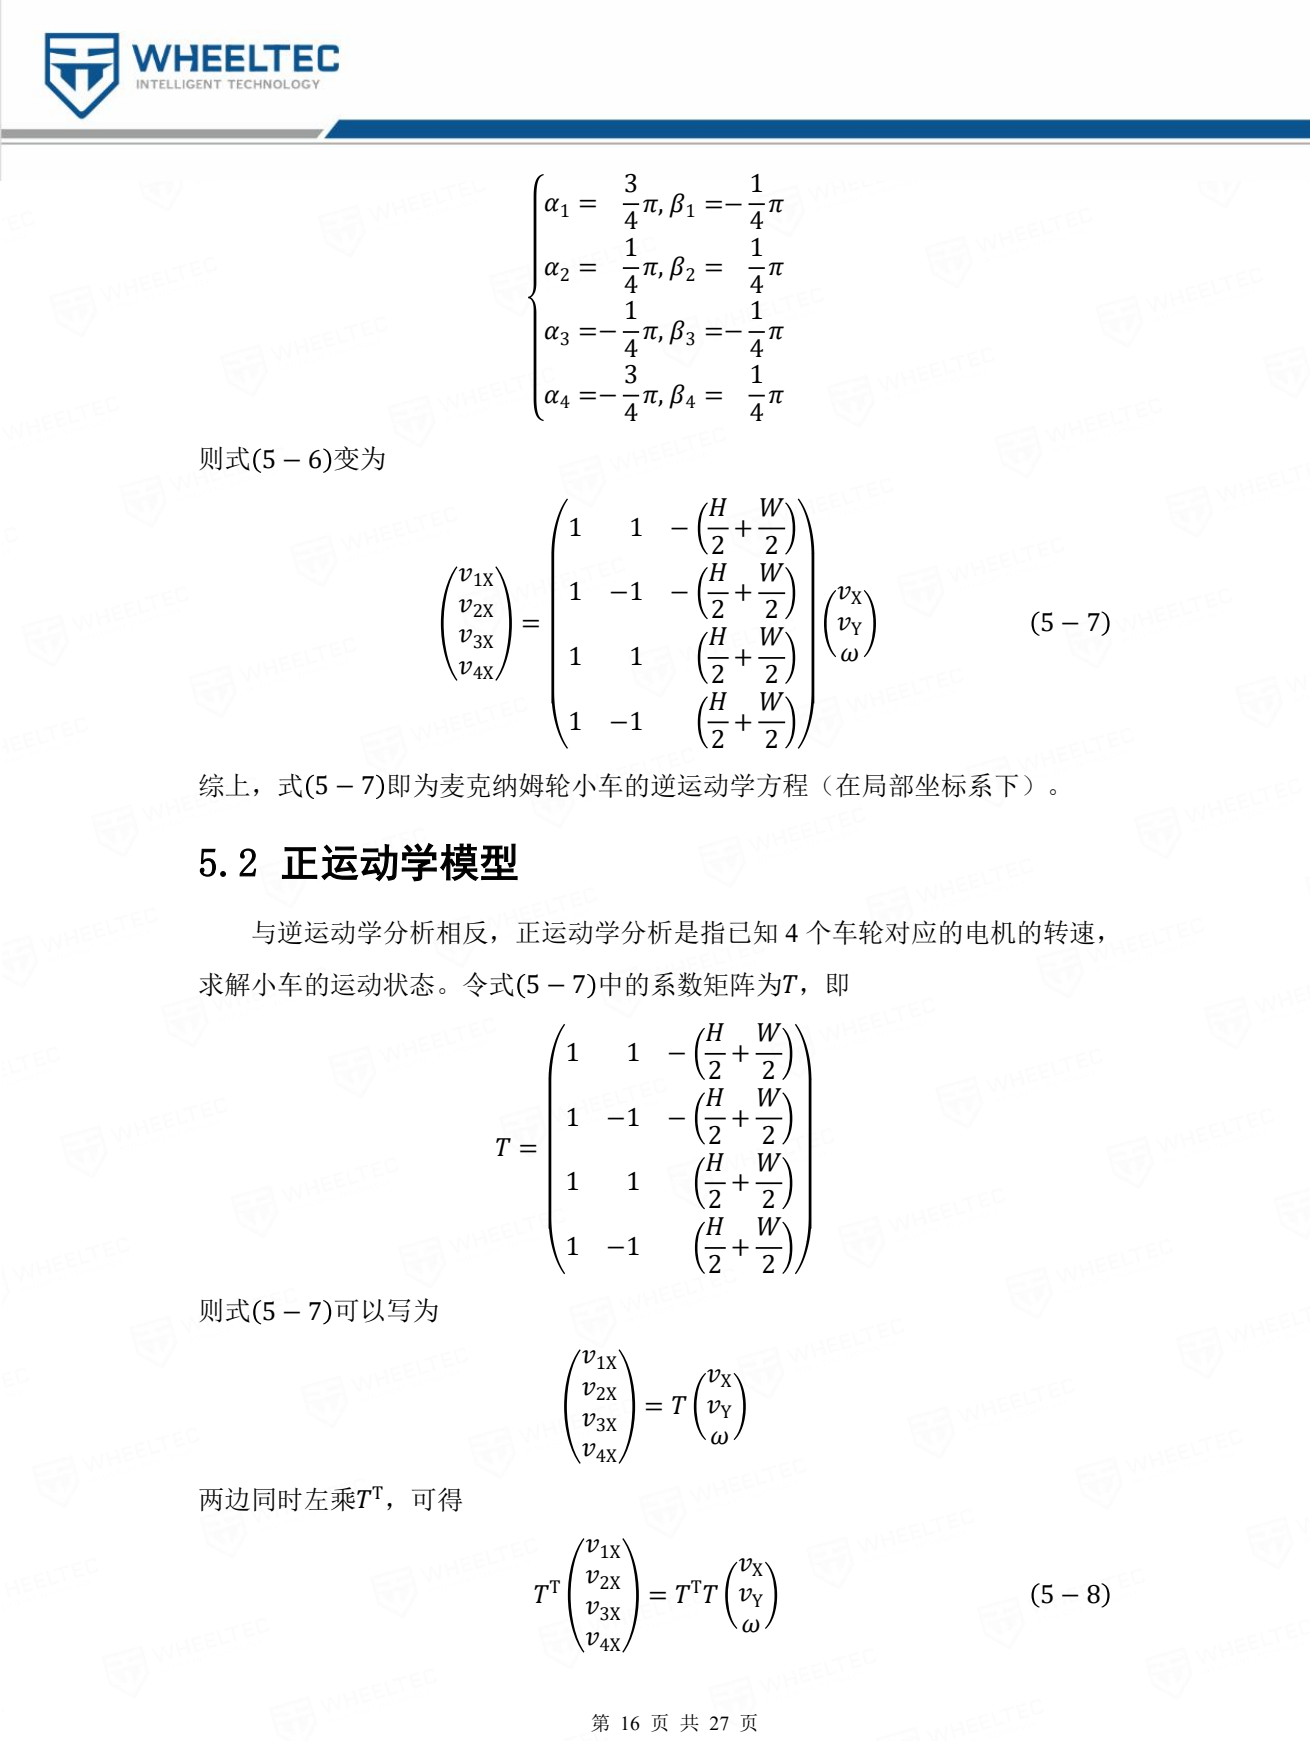
[picture p211: page 16]

# 由于 rank

# T = rank = 3，所以，矩阵

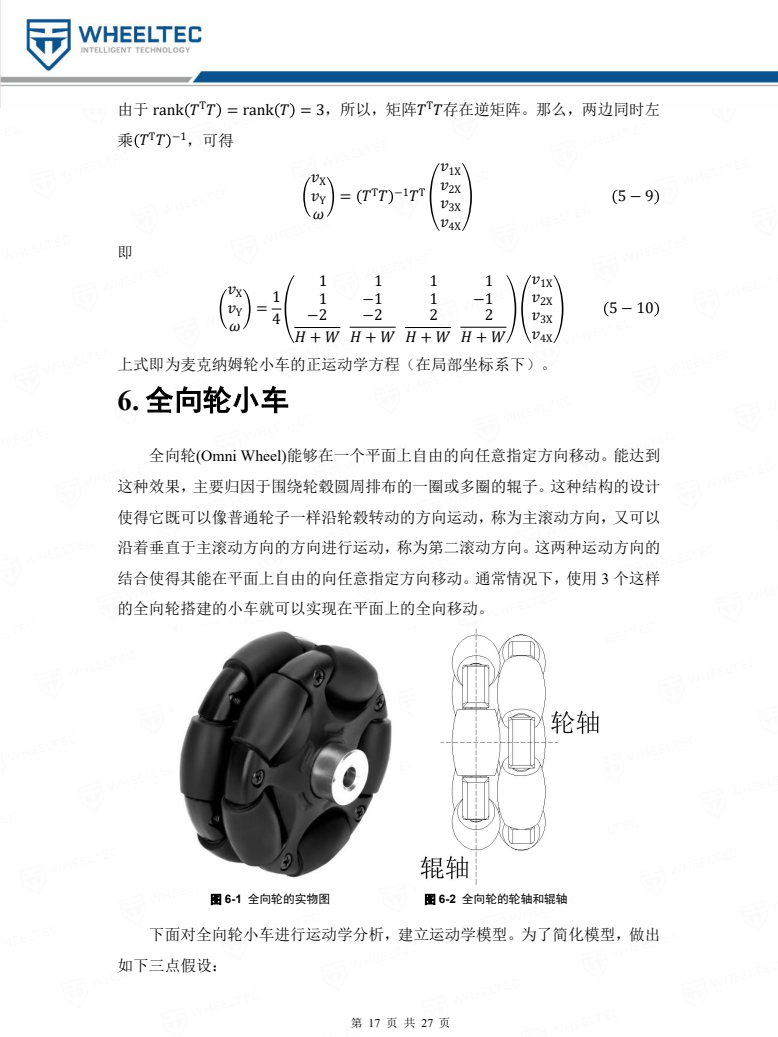
[picture p212: page 17]
T存在逆矩阵。那么，两边同时左; 上式即为麦克纳姆轮小车的正运动学方程（在局部坐标系下）。 6. 全向轮小车; 的全向轮搭建的小车就可以实现在平面上的全向移动。; 图 6-1 全向轮的实物图; 图 6-2 全向轮的轮轴和辊轴; 如下三点假设：

全向轮(Omni Wheel)能够在一个平面上自由的向任意指定方向移动。能达到

这种效果，主要归因于围绕轮毂圆周排布的一圈或多圈的辊子。这种结构的设计

使得它既可以像普通轮子一样沿轮毂转动的方向运动，称为主滚动方向，又可以

沿着垂直于主滚动方向的方向进行运动，称为第二滚动方向。这两种运动方向的
结合使得其能在平面上自由的向任意指定方向移动。通常情况下，使用 3 个这样

下面对全向轮小车进行运动学分析，建立运动学模型。为了简化模型，做出

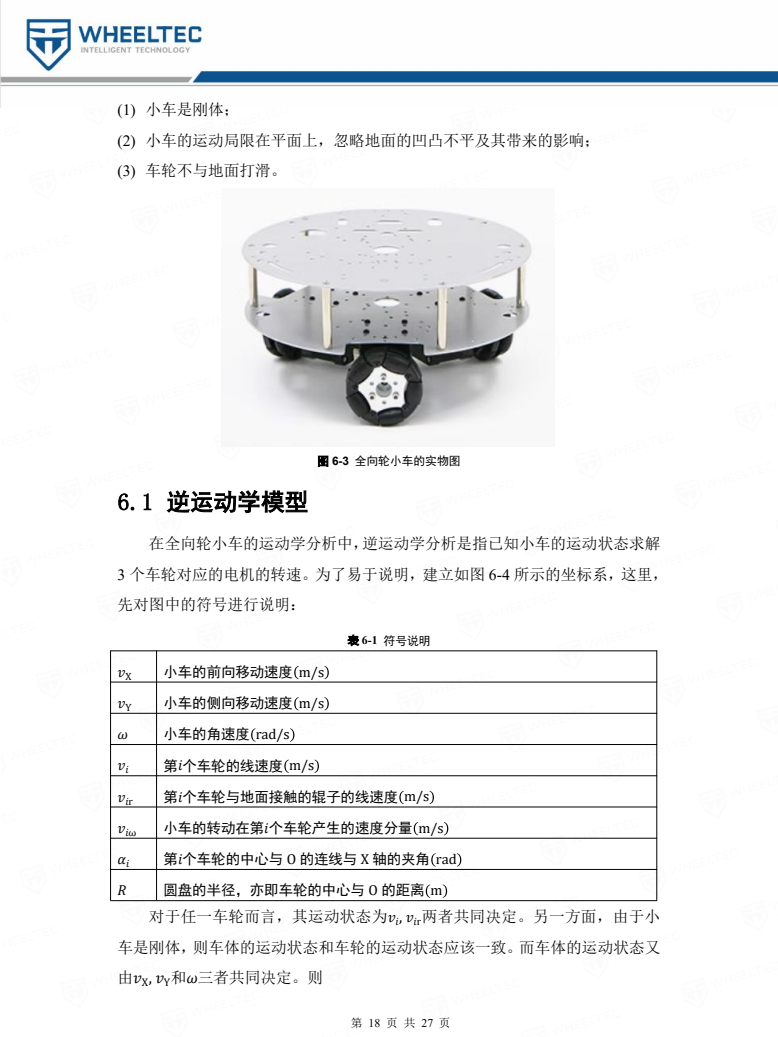
[picture p213: page 18]
(1) 小车是刚体；; (2) 小车的运动局限在平面上，忽略地面的凹凸不平及其带来的影响；; (3) 车轮不与地面打滑。; 图 6-3 全向轮小车的实物图; 6.1 逆运动学模型; 先对图中的符号进行说明：; 表 6-1 符号说明; 圆盘的半径，亦即车轮的中心与 O 的距离 m; 对于任一车轮而言，其运动状态为

在全向轮小车的运动学分析中，逆运动学分析是指已知小车的运动状态求解
3 个车轮对应的电机的转速。为了易于说明，建立如图 6-4 所示的坐标系，这里，

X | 小车的前向移动速度 m/s
 | 小车的角速度 rad/s

Y | 小车的侧向移动速度 m/s

 | 第个车轮的线速度 m/s

r | 第个车轮与地面接触的辊子的线速度 m/s

ω | 小车的转动在第个车轮产生的速度分量 m/s

 | 第个车轮的中心与 O 的连线与 X 轴的夹角 rad

, r两者共同决定。另一方面，由于小

由X, Y和三者共同决定。则
车是刚体，则车体的运动状态和车轮的运动状态应该一致。而车体的运动状态又

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

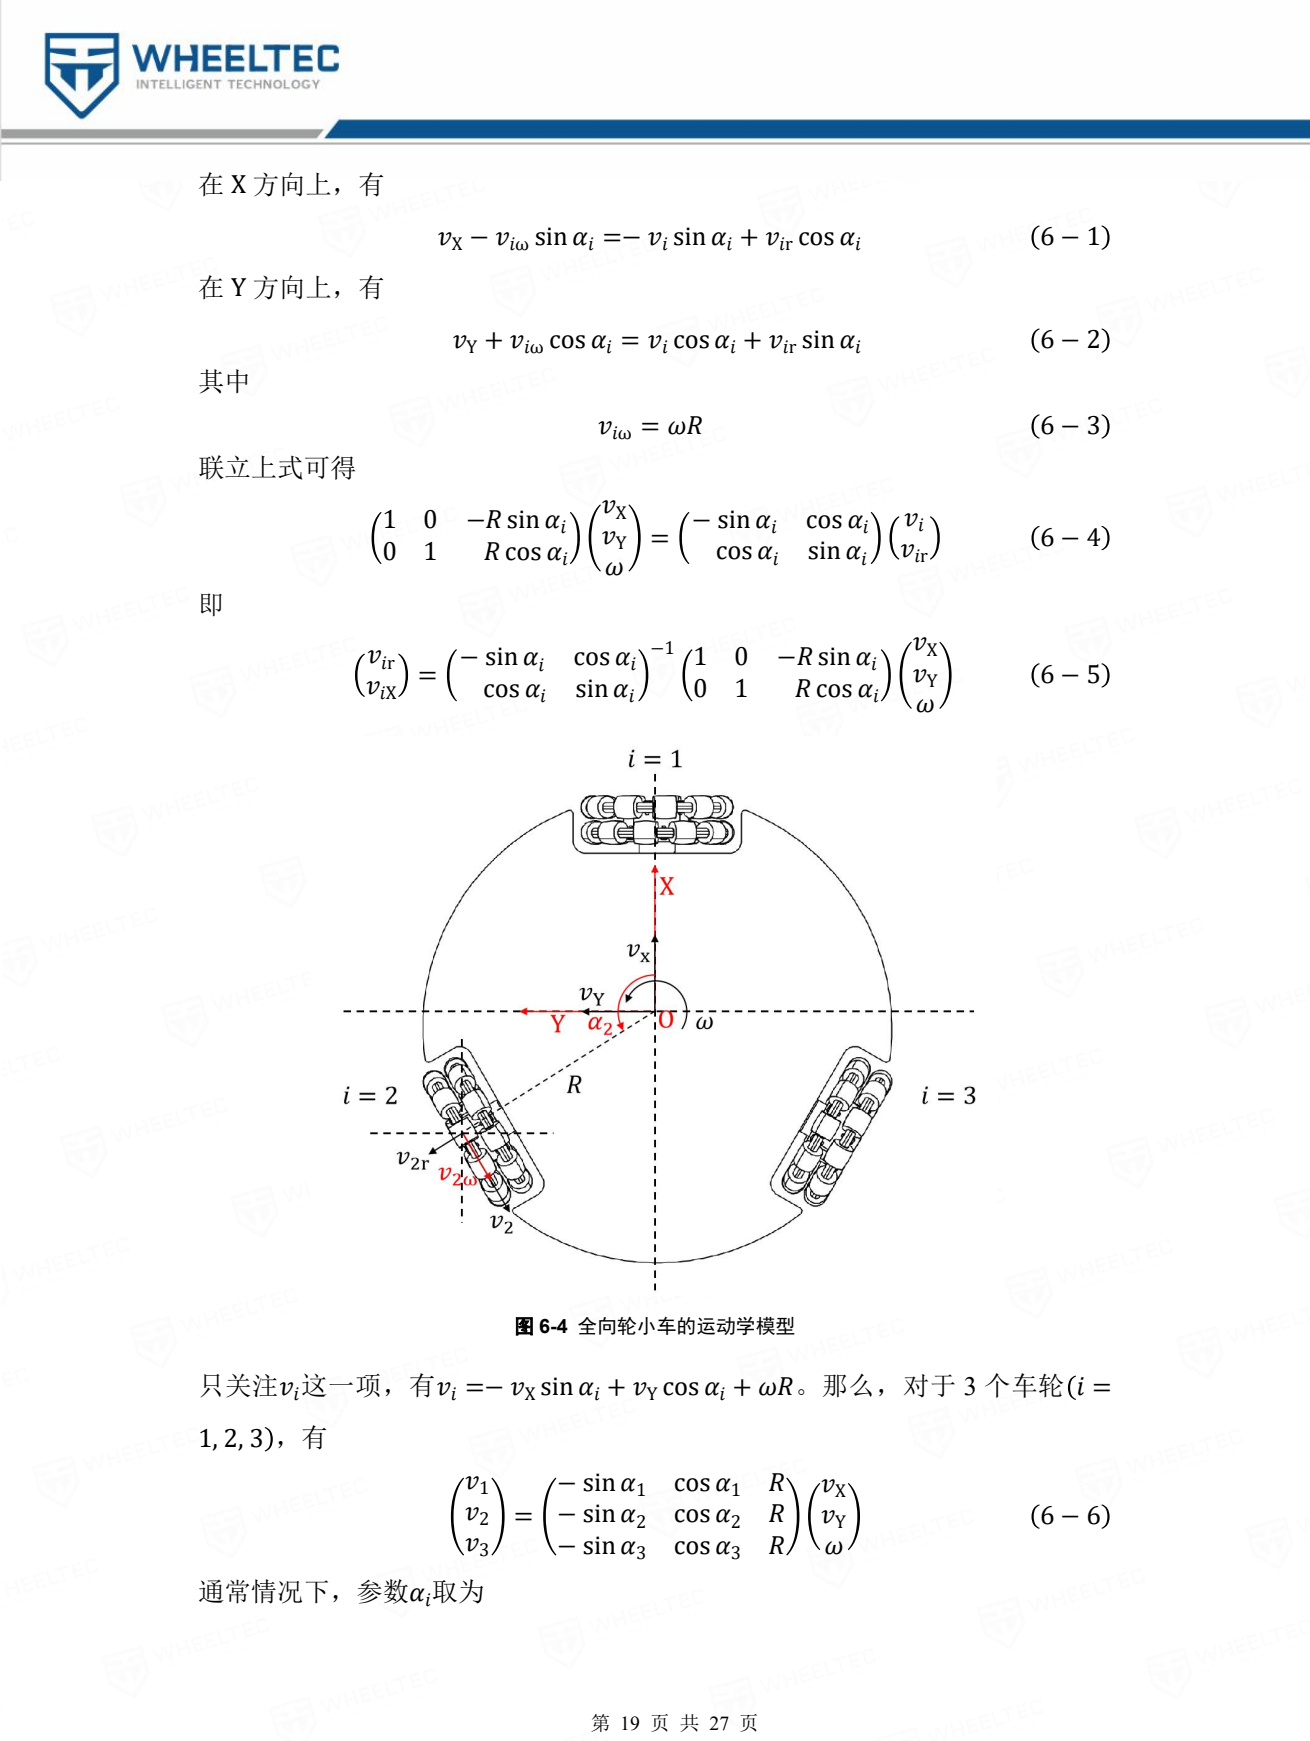
[picture p214: page 19]

1 = 0
2 =

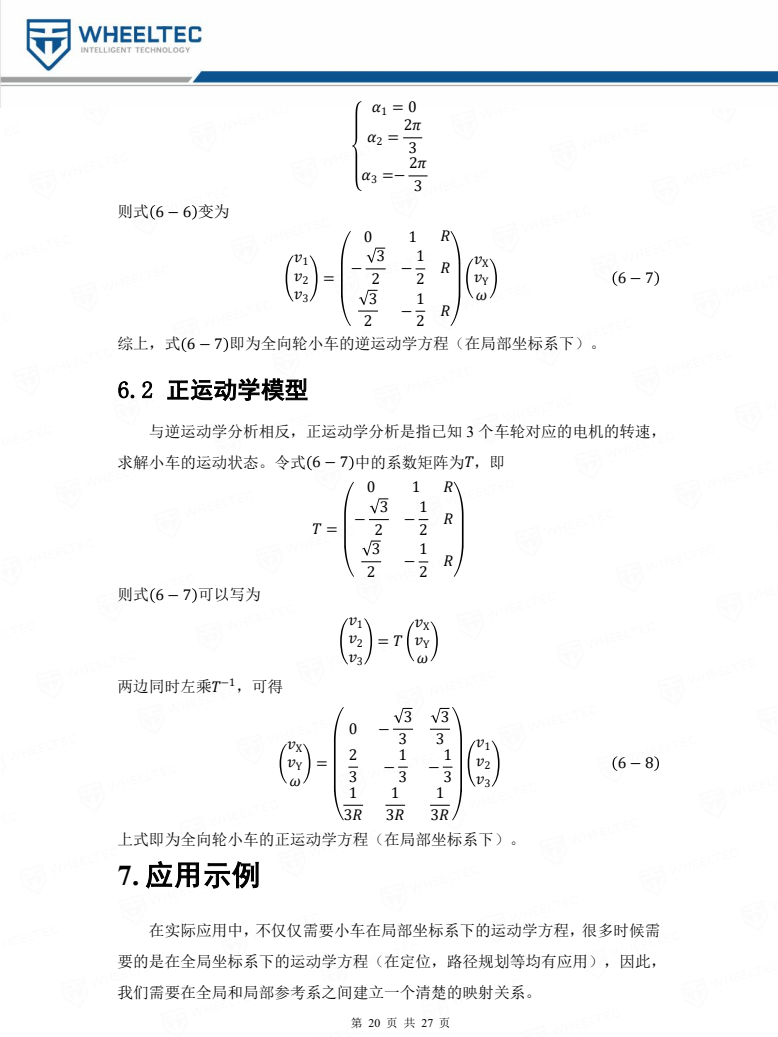
[picture p215: page 20]
综上，式 6 − 7 即为全向轮小车的逆运动学方程（在局部坐标系下）。; 6.2 正运动学模型; 则式 6 − 7 可以写为; 两边同时左乘 −1，可得; 上式即为全向轮小车的正运动学方程（在局部坐标系下）。 7. 应用示例; 我们需要在全局和局部参考系之间建立一个清楚的映射关系。

求解小车的运动状态。令式 6 − 7 中的系数矩阵为，即
与逆运动学分析相反，正运动学分析是指已知 3 个车轮对应的电机的转速，

在实际应用中，不仅仅需要小车在局部坐标系下的运动学方程，很多时候需

要的是在全局坐标系下的运动学方程（在定位，路径规划等均有应用），因此，

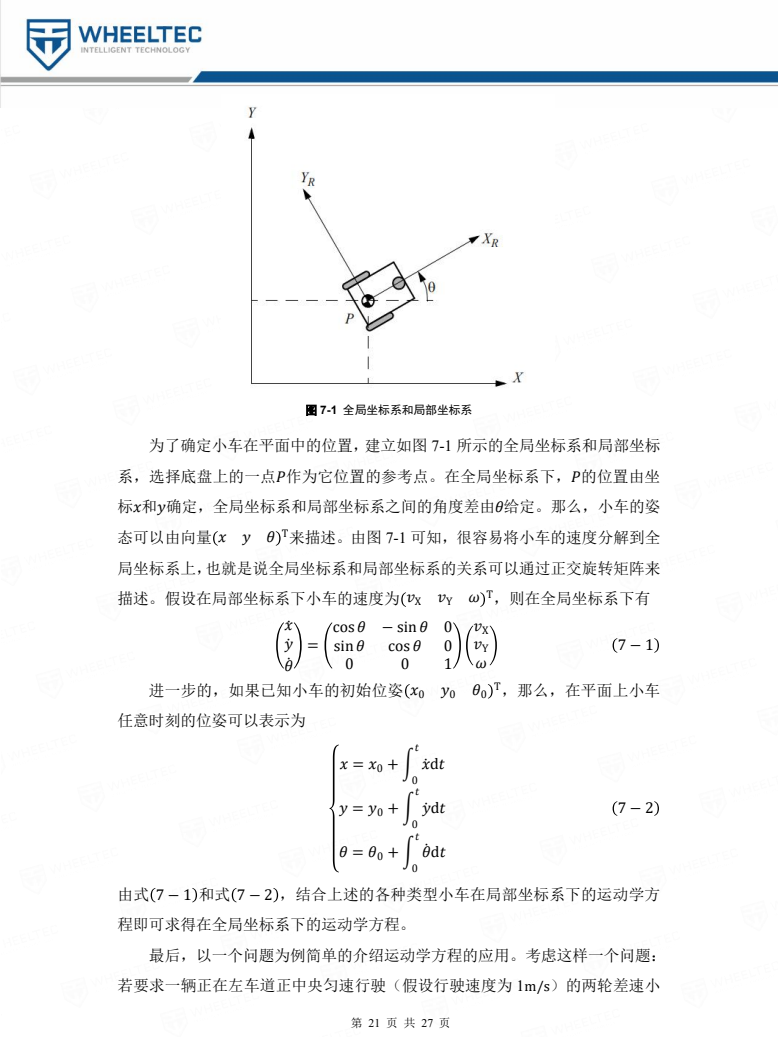
[picture p216: page 21]
图 7-1 全局坐标系和局部坐标系; 为了确定小车在平面中的位置，建立如图 7-1 所示的全局坐标系和局部坐标; 系，选择底盘上的一点作为它位置的参考点。在全局坐标系下，的位置由坐; 标和确定，全局坐标系和局部坐标系之间的角度差由给定。那么，小车的姿; 态可以由向量   ; cos  − sin  0 sin  cos  0 0 0 1; 进一步的，如果已知小车的初始位姿 0 0 0; T，那么，在平面上小车; 任意时刻的位姿可以表示为

T来描述。由图 7-1 可知，很容易将小车的速度分解到全

描述。假设在局部坐标系下小车的速度为 X Y  T，则在全局坐标系下有
局坐标系上，也就是说全局坐标系和局部坐标系的关系可以通过正交旋转矩阵来

由式 7 − 1 和式 7 − 2 ，结合上述的各种类型小车在局部坐标系下的运动学方

程即可求得在全局坐标系下的运动学方程。
若要求一辆正在左车道正中央匀速行驶（假设行驶速度为 1m/s）的两轮差速小
最后，以一个问题为例简单的介绍运动学方程的应用。考虑这样一个问题：

第 22 页 共 27 页

车变到相距 1m 的右车道正中央，那么要怎么控制两驱动轮的速度？（这里不做

详细的分析，只作为一个抛砖引玉的例子）可以简单的做如下分析：如果没有其

它附加要求，我们可以在不改变小车前进速度的前提下，对小车的转向速度进行

反馈控制，离目标位置越远，转向速度越大，另一方面，角度偏离正方向越大，

转向速度越小（因为变道完成后，小车依然是朝正方向直线行驶）。那么，不妨

做如下的控制

=− 1 1 − + 2

2 − 7 − 3

其中，1和2是反馈系数，需要自己调试。再将全局坐标系下小车的速度

T变换到局部坐标系下小车的速度 X Y T即可实现对两驱动轮

速度的控制。下面是在 MATLAB 平台上的仿真程序：

clc
clear
close all
W = 0.2; % 轮距
v = 1; % 初始前向速度
theta_dot = 0; % 初始转向速度
x = 0; % 初始位置（X 方向）
y = 0; % 初始位置（Y 方向）
theta = pi/2; % 初始姿态
t = 0:0.05:10; % 50ms 控制一次 for i = 1:length(t)
x_dot = v*cos(theta);
y_dot = v*sin(theta);
x = x + x_dot*0.05; % 全局坐标系下的位置（X 分量） y = y + y_dot*0.05; % 全局坐标系下的位置（Y 分量） theta = theta + theta_dot*0.1; % 全局坐标系下的姿态 theta_dot = -1*(1 - x) - 2*(theta - pi/2);
% 逆运动学方程（局部坐标系下）
omega = theta_dot;
v_L = v - omega*W/2;
v_R = v + omega*W/2;
% 绘制图像
subplot(2,2,1)
plot(t(i),v_L,'b.')
ylabel('v_L')
xlabel('Time')
xlim([0 10]);
ylim([0.8 1.2]);
hold on

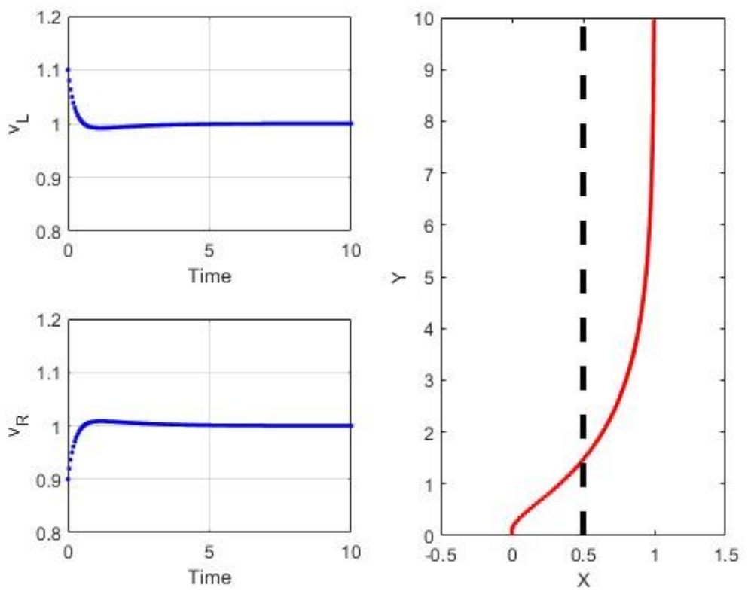
[picture p217: figure]

第 23 页 共 27 页

grid on
subplot(2,2,3)
plot(t(i),v_R,'b.')
ylabel('v_R')
xlabel('Time')
xlim([0 10]);
ylim([0.8 1.2]);
hold on
grid on
subplot(2,2,[2 4])
plot(x,y,'r.');
ylabel('Y')
xlabel('X')
line([0.5 0.5],[0 10],'LineStyle','--','Color','k','LineWidth',3) xlim([-0.5 1.5]);
ylim([0 10])
hold on
pause(0.01)
end

运行的结果如下所示：

图 7-2 两轮差速小车变道的模拟结果

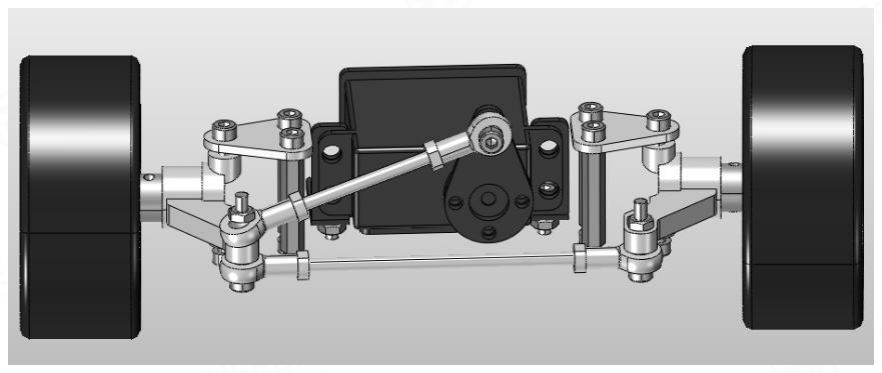
[picture p218: figure]
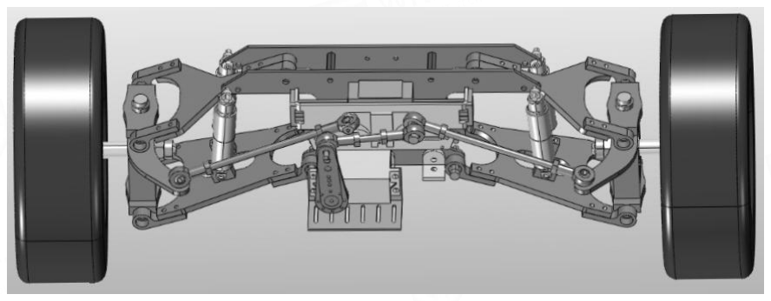
[picture p219: figure]

第 24 页 共 27 页

# 8. 附录

这一节对阿克曼转向机构做一个补充说明，目前尚没有一种成熟的机构能使

内外侧转向轮的转角在全部范围内精确地满足式 3 − 2 这一理想的关系，只能

通过梯形连杆机构或其衍生机构来近似满足。常见的转向机构往往是基于曲柄摇

杆机构或者基于曲柄滑块机构设计的，如下图所示。可以看到在整个转向机构中，

舵机充当主动件，而关于控制舵机的转动在我们产品中的实现方式有两种：传递

PWM 值直接控制舵机的转动（无滑块位置传感器或基于曲柄摇杆的机构）和传

递滑块的位置信息利用增量式PID控制PWM值的大小进而间接控制舵机的转动

（有滑块位置传感器）。下面对两种情况进行说明。

图 8-1 基于曲柄摇杆机构的阿克曼转向机构

图 8-2 基于曲柄滑块机构的阿克曼转向机构

## 8.1 关于转向机构（无反馈）

在这种情况下，主要探究舵机的转动角（与 PWM 值一一对应）和小车前轮

转向角（以左轮为研究对象）的关系（这里以高配阿克曼小车为例）。首先，根

据已知数据（由实验测得）绘制出散点图，如图 8-3 所示。通过观察，不难看出

曲线的走势可以用二次曲线或者三次曲线来进行拟合。为了简单起见，可以调用

MATLAB 的曲线拟合工具箱（在 MATLAB 的命令行上输入 cftool 即可，至于工

具箱的使用请自行学习，这里不再赘述）查看曲线的拟合情况（这里选择三次曲

线，因为在避免过拟合的情况下，次数越高，拟合效果越好），如图 8-4 所示。

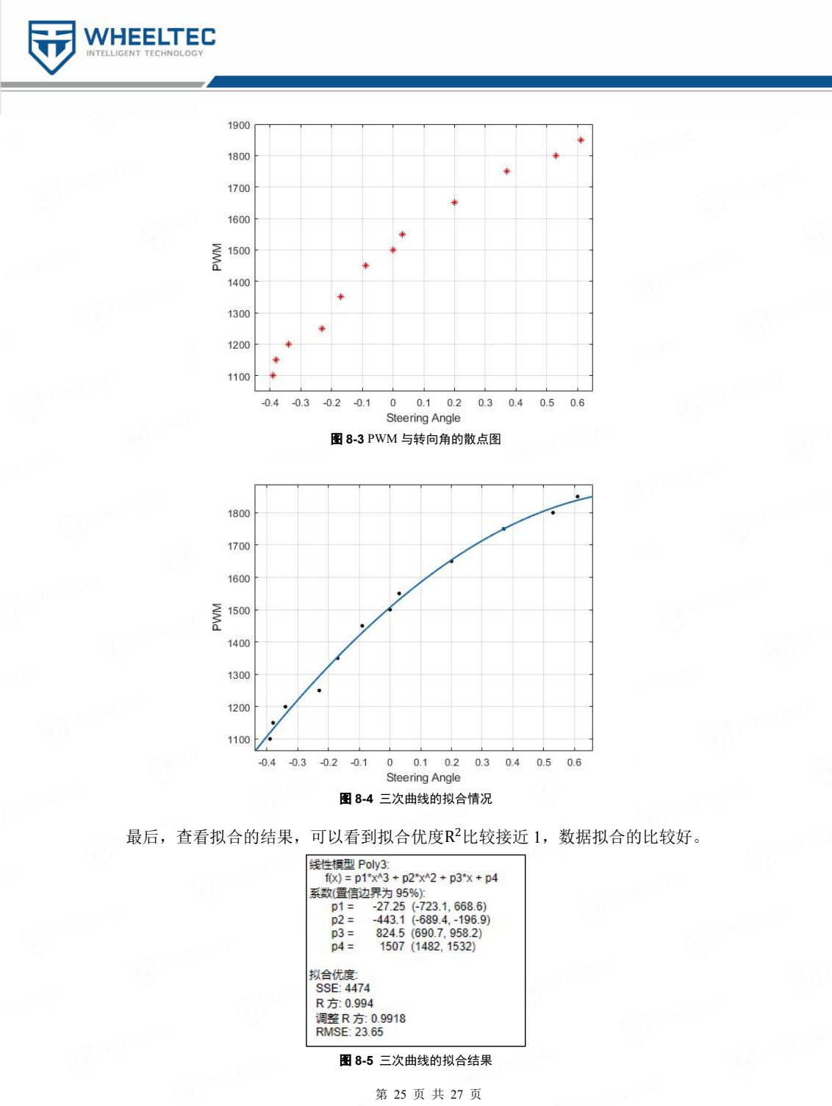
[picture p220: page 25]

第 25 页 共 27 页

图 8-3 PWM 与转向角的散点图

图 8-4 三次曲线的拟合情况
最后，查看拟合的结果，可以看到拟合优度R
2比较接近 1，数据拟合的比较好。

图 8-5 三次曲线的拟合结果

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

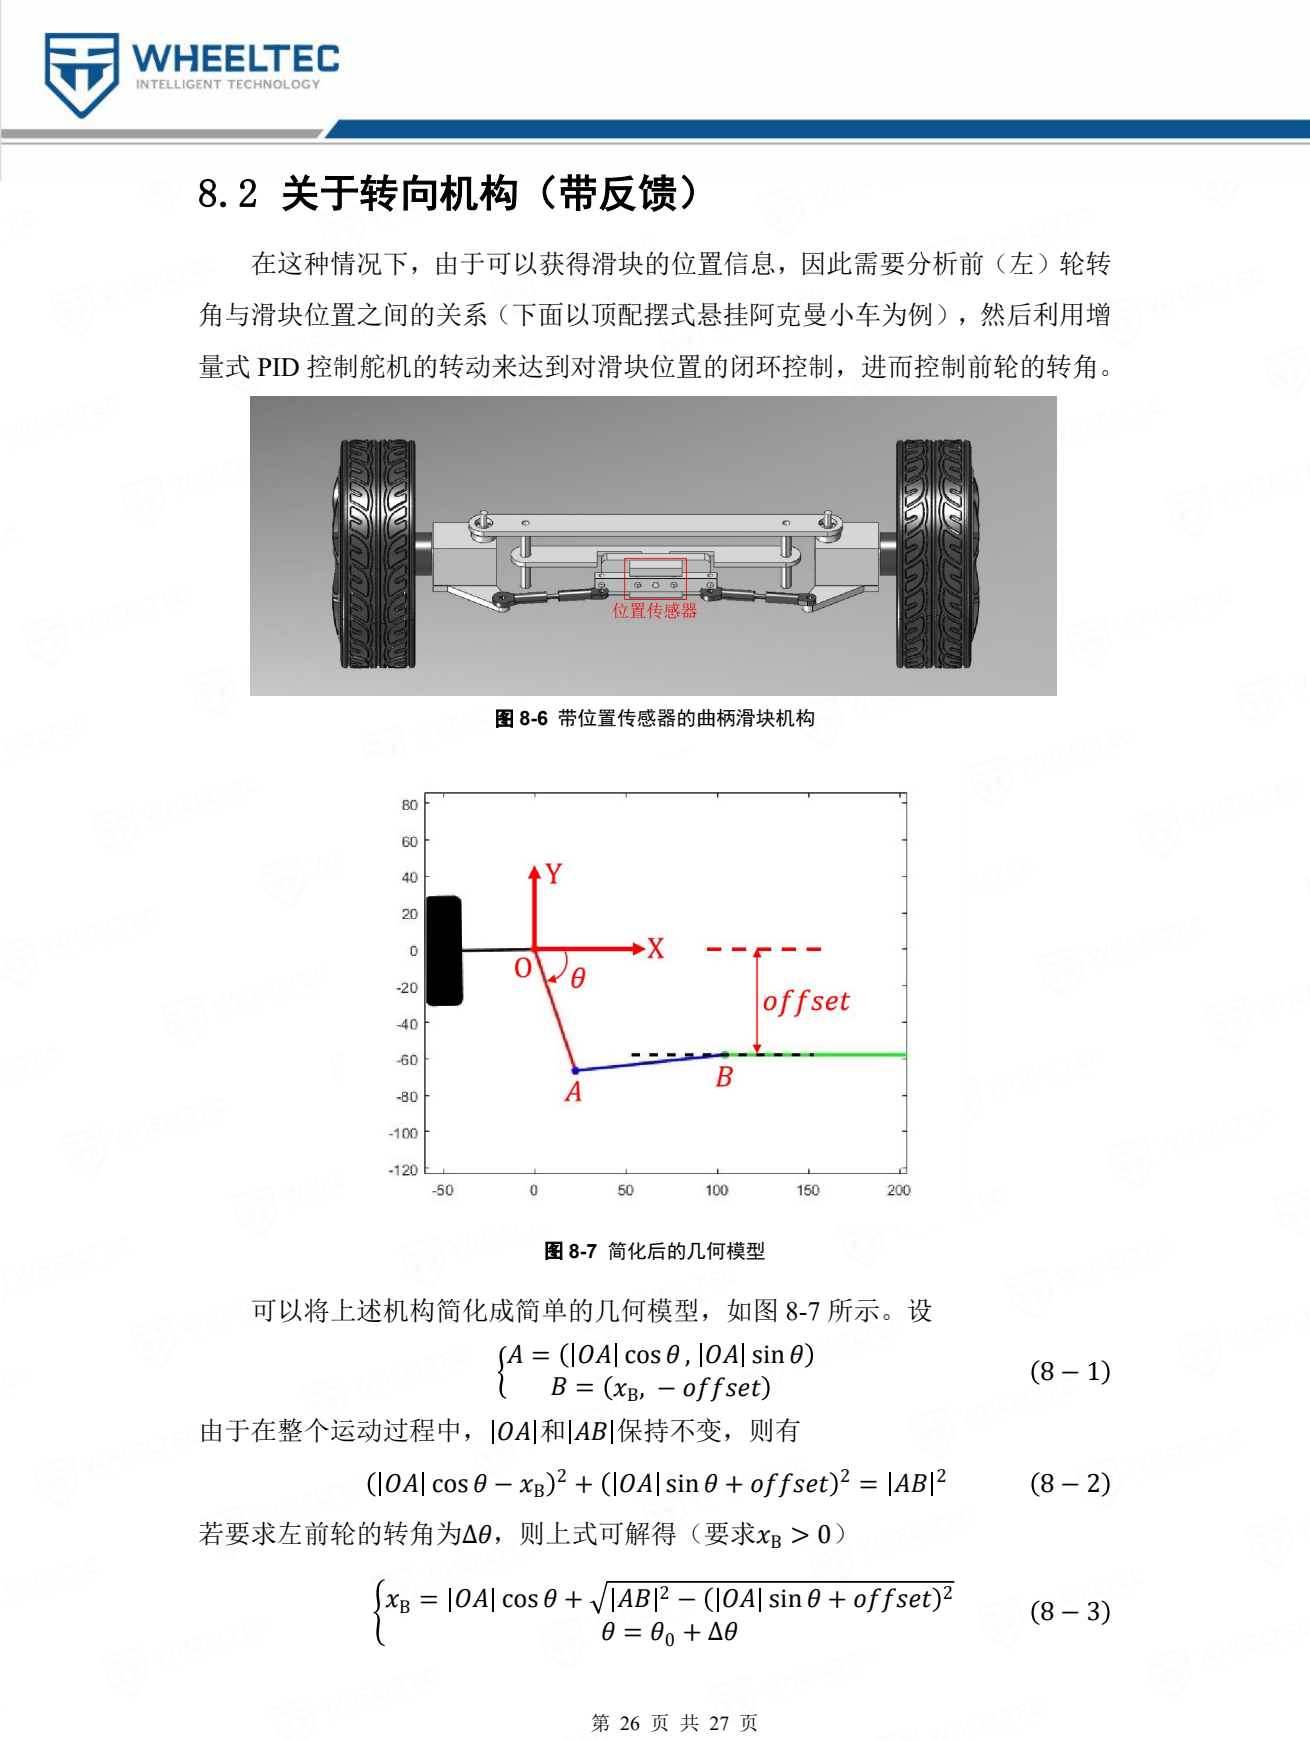
[picture p221: page 26]

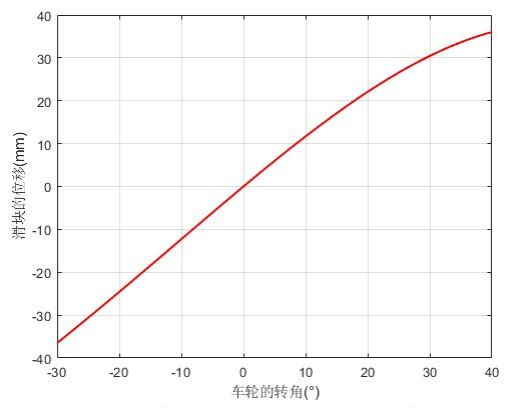
[picture p222: figure]

第 27 页 共 27 页

其中，0为的初始值，即当车轮没有转动的时候，的大小。那么，此时滑块

的位移为∆ = B − 0，类似的，0为B的初始值，即当车轮没有转动的时候，B

的大小。只要控制滑块移动设置的距离，就能达到控制车轮转动目标的角度。下

面是在 MATLAB 平台上的计算程序：

clc
clear
close all
%% 参数
AB = 82.27;
OA = 70.20;
offset = 57.80;
delta_theta = -30:0.5:40;
theta = (delta_theta - 72.39)/180 * pi;
%% 计算
x_B = OA*cos(theta) + sqrt(AB^2 - (OA*sin(theta) + offset).^2); delta_x = x_B - 103;
figure(1)
plot(delta_theta,delta_x,'r',LineWidth=1.5) xlabel('车轮的转角(°)')
ylabel('滑块的位移(mm)')
grid on

运行的结果如下所示：

图 8-8 车轮转角与滑块位移的关系
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
