MXDfc/ShanghaiTech_EE114-Embedded-Systems/Lab9and10/FinalExhibition/L150_HAL_20250507/Src/main.c

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
/* Includes ------------------------------------------------------------------*/
#include "main.h"
#include "adc.h"
#include "tim.h"
#include "usart.h"
#include "gpio.h"

/* USER CODE BEGIN Includes */
#include "Header.h"
/* USER CODE END Includes */

/* USER CODE BEGIN PM */
volatile u8 delay_50,delay_flag; 		//延时变量			
u16 Voltage;							//电压变量，放大100倍储存
u8 Flag_Stop;							//电机启停标志位
u8 PS2_ON_Flag = 0,APP_ON_Flag = 0,ROS_ON_Flag = 0,Remote_ON_Flag;		//默认所有方式不控制
u8 Car_Num;								//车型号码选择
u8 Flag_Show = 1;						//显示标志位，默认开启，长按切换到上位机模式，此时关闭
float Perimeter; 						//轮子的周长
float Wheelspacing; 					//轮子的轮距
u8 one_lap_data_success_flag=0,Lidar_Success_Receive_flag;         //雷达数据完成一圈的接收标志位
int lap_count=0;//当前雷达这一圈数据有多少个点
int PointDataProcess_count=0,test_once_flag=0,Dividing_point=0;//雷达接收数据点的计算值、接收到一圈数据最后一帧数据的标志位、需要切割数据的数据数
/* USER CODE END PM */


void SystemClock_Config(void);
/**
  * @brief  The application entry point.
  * @retval int
  */
int main(void)
{

  /* USER CODE BEGIN 1 */
  u32 Voltage_Sum = 0;
	u8 Voltage_Count = 0;				
	u16 Ultrasonic_Distance = 0;
	/* USER CODE END 1 */

  /* MCU Configuration--------------------------------------------------------*/

  /* Reset of all peripherals, Initializes the Flash interface and the Systick. */
  HAL_Init();

  /* Configure the system clock */
  SystemClock_Config();

  /* Initialize all configured peripherals */
  MX_GPIO_Init();
  MX_ADC1_Init();
  MX_ADC2_Init();
  MX_TIM3_Init();
  MX_TIM4_Init();
  MX_TIM8_Init();
  MX_UART5_Init();
  MX_USART1_UART_Init();
  MX_USART3_UART_Init();
  MX_UART4_Init();
  /* USER CODE BEGIN 2 */
  printf("[UART] USART1 ready: 9600 8N1, HCLK=%lu, PCLK1=%lu, PCLK2=%lu, BRR=0x%04lX\r\n",
         HAL_RCC_GetHCLKFreq(),
         HAL_RCC_GetPCLK1Freq(),
         HAL_RCC_GetPCLK2Freq(),
         (unsigned long)USART1->BRR);
#if !USART1_TEXT_DEBUG_ONLY || FINAL_EXHIBITION_AUTO_SCAN
	OLED_Init();
#endif
//Distance_Cap_Init(65535,72-1);//用于测量超声波的距离，默认注释，具体看capture.h
  PWM_Cap_Init(65535,72-1);  //航模初始化
  HC_SR04_Init();            //超声波初始化
#if USART1_TEXT_DEBUG_ONLY && HC_SR04_STREAMING_DEBUG
  printf("[HC_SR04] streaming start\r\n");
  while (1)
  {
    Ultrasonic_Distance = HC_SR04_ReadMedian();
    printf("distance = %u\r\n", (unsigned int)Ultrasonic_Distance);
    delay_ms(200);
  }
#endif
  MPU6050_Init();           //MPU6050初始化	
    PS2_SetInit();                //手柄配置初始化
    Robot_Select();
	BEEP_ON();													//按键按下蜂鸣器提示
	delay_ms(300);
	BEEP_OFF();
	if(Car_Num == Akm_Car)
		  MX_TIM1_Init();									//阿克曼车型初始化舵机
	Car_Perimeter_Init();										//初始化轮子周长和轮距
	// Auto_Demo relies on Turn_Off() in the TIM5 interrupt. Initialize Voltage before TIM5 starts,
	// otherwise the default value 0 is treated as low battery and the auto task is stopped immediately.
	Voltage_Sum = 0;
	for(Voltage_Count = 0; Voltage_Count < 5; Voltage_Count++)
	{
		Voltage_Sum += Get_Voltage();
		delay_ms(2);
	}
	Voltage = Voltage_Sum / 5;
	Voltage_Sum = 0;
	Voltage_Count = 0;
    MX_TIM5_Init();							//5ms中断控制，大部分控制逻辑在里面
#if FINAL_EXHIBITION_AUTO_SCAN
    Auto_Demo_Start();
    printf("[AUTO] start: car=%u voltage=%u\r\n", (unsigned int)Car_Num, (unsigned int)Voltage);
#endif
  /* USER CODE END 2 */

  /* Infinite loop */
  /* USER CODE BEGIN WHILE */
  while (1)
  {
    /* USER CODE END WHILE */
    /* USER CODE BEGIN 3 */
	    Robot_Select();
#if FINAL_EXHIBITION_AUTO_SCAN
		Auto_Demo_Service_Main();
#endif
		if(Flag_Show)											//正常显示，非上位机模式
		{
			LED2_OFF;
			PS2_Read();											//手柄数据读取
			
			Show();												//显示屏
#if !USART1_TEXT_DEBUG_ONLY
			APP_Show();											//手机蓝牙显示
#endif

			Voltage_Sum += Get_Voltage();						//电压测量，每5次取一次平均
			if((++Voltage_Count) == 5)
				Voltage = Voltage_Sum/5,Voltage_Count = 0,Voltage_Sum = 0;
		}
		else													//进入上位机模式
		{
			LED2_ON;											//LED2常亮指示进入了上位机模式
#if !USART1_TEXT_DEBUG_ONLY
			DataScope();										//上位机示波器显示
#endif
		}
		delay_flag=1;	
		delay_50=0;
		while(delay_flag);	     								//通过定时中断实现的50ms延时，主要用于示波
  }
  /* USER CODE END 3 */
}

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
