MXDfc/ShanghaiTech_EE114-Embedded-Systems/Lab9and10/FinalExhibition/L150_HAL_20250507/miniBlance.ioc

Mcu.UserName=STM32F103RCTx
PA0-WKUP.Signal=GPIO_Input
PA10.Signal=USART1_RX
PA13.Signal=SYS_JTMS-SWDIO
PA14.Signal=SYS_JTCK-SWCLK
PA15.Signal=GPIO_Output
PA6.Signal=S_TIM3_CH1
PA7.Signal=S_TIM3_CH2
PA8.Signal=S_TIM1_CH1
PA9.Signal=USART1_TX
PB0.Signal=S_TIM3_CH3
PB1.Signal=S_TIM3_CH4
PB10.Signal=USART3_TX
PB11.Signal=USART3_RX
PB14.Signal=GPIO_Output
PB15.Signal=GPIO_Output
PB3.Signal=GPIO_Output
PB4.Signal=GPIO_Output
PB5.Signal=GPIO_Output
PB6.Signal=S_TIM4_CH1
PB7.Signal=S_TIM4_CH2
PB8.Signal=GPIO_Input
PC0.Signal=ADCx_IN10
PC1.Signal=ADCx_IN11
PC10.Signal=UART4_TX
PC11.Signal=UART4_RX
PC12.Signal=UART5_TX
PC13-TAMPER-RTC.Signal=GPIO_Input
PC14-OSC32_IN.Signal=GPIO_Output
PC2.Signal=GPIO_Output
PC3.Signal=GPIO_Output
PC4.Signal=GPIO_Output
PC6.Signal=S_TIM8_CH1
PC7.Signal=S_TIM8_CH2
PC8.Signal=GPIO_Output
PC9.Signal=GPIO_Output
PD0-OSC_IN.Signal=RCC_OSC_IN
PD1-OSC_OUT.Signal=RCC_OSC_OUT
PD2.Signal=UART5_RX
