MXDfc/ShanghaiTech_EE114-Embedded-Systems/Lab2and3/Device Data/AI语音交互/1.教程资料/4 STM32通信/4.4.3 STM32模块地址修改例程/01 STM32F103/02 程序文件/STM32F103_Asr_IICaddr_change/USER/main.c

#include "include.h"
#include "IIC.h"
#include <string.h>

/******************************************************
//	Company:深圳幻尔科技有限公司					 //
//	作者：CuZn                                       //
//	我们的店铺:lobot-zone.taobao.com                 //
//	我们的官网:https://www.hiwonder.com/             //
******************************************************/
//hiwonder 语音识别模块例程

/* 模块地址修改功能例程 */

int main(void)
{
	SystemInit();
	InitDelay(72);																		//初始化延时函数
	Usart1_Init(); //串口初始化
	IIC_Init();		//IIC初始化
  DelayMs(200);
	printf("start");
	
	while (1)
	{
				DelayMs(2000);
		
				printf("now,asr module's IIC Address is 0x34!");
				Asr_IICaddr_change(0x34);
				DelayMs(300);
		
        Asr_Speak(ASR_CMDMAND , 0x01); // 命令词播报语 播报：正在前进
        DelayMs(20000);
        Asr_Speak(ASR_ANNOUNCER , 0x01); // 播报语 播报：可回收物
        DelayMs(20000);
		
				DelayMs(2000);
		
				printf("now,asr module's IIC Address is 0x33!");
				Asr_IICaddr_change(0x33);
				DelayMs(300);
		
        Asr_Speak(ASR_CMDMAND , 0x01); // 命令词播报语 播报：正在前进
        DelayMs(20000);
        Asr_Speak(ASR_ANNOUNCER , 0x01); // 播报语 播报：可回收物
        DelayMs(20000);

	}
}
