MXDfc/ShanghaiTech_EE114-Embedded-Systems/Lab11and12/WHEELTEC L150(LD14P) 避障巡线小车源码_2026.04.13/WHEELTEC L150(LD14P) 避障巡线雷达小车HAL库_2026.04.13/CONTROL/pid.h

/***********************************************
公司：轮趣科技（东莞）有限公司
品牌：WHEELTEC
官网：wheeltec.net
淘宝店铺：shop114407458.taobao.com 
速卖通: https://minibalance.aliexpress.com/store/4455017
版本：V1.0
修改时间：2023-03-02

Brand: WHEELTEC
Website: wheeltec.net
Taobao shop: shop114407458.taobao.com 
Aliexpress: https://minibalance.aliexpress.com/store/4455017
Version: V1.0
Update：2023-03-02

All rights reserved
***********************************************/


#ifndef __PID_H
#define	__PID_H


#include "Header.h"
extern float Velocity_KP,Velocity_KI;					//增量式PI参数
extern float Distance_KP,Distance_KD,Distance_KI;		//距离调整PID参数
extern float Follow_KP,Follow_KD,Follow_KI;				//跟随模式转向的PID控制参数
extern float Follow_KP_Akm,Follow_KD_Akm;



extern float ELE_KP_Akm,ELE_KD_Akm,ELE_KI_Akm,ELE_K_Akm;

extern float ELE_KP_Diff,ELE_KD_Diff,ELE_KI_Diff,ELE_K_Diff;

extern float ELE_KP_STank,ELE_KD_STank,ELE_KI_STank,ELE_K_STank;

extern float ELE_KP_BTank,ELE_KD_BTank,ELE_KI_BTank,ELE_K_BTank;

extern float CCD_KP_Akm,CCD_KD_Akm,CCD_KI_Akm;

extern float CCD_KP_Diff,CCD_KD_Diff,CCD_KI_Diff;

extern float CCD_KP_STank,CCD_KD_STank,CCD_KI_STank;

extern float CCD_KP_BTank,CCD_KD_BTank,CCD_KI_BTank;

extern float Diff_Along_Distance_KP,Diff_Along_Distance_KD,Diff_Along_Distance_KI;

extern float Akm_Along_Distance_KP,Akm_Along_Distance_KD,Akm_Along_Distance_KI;

extern float STank_Along_Distance_KP,STank_Along_Distance_KD,STank_Along_Distance_KI;

extern float BTank_Along_Distance_KP,BTank_Along_Distance_KD,BTank_Along_Distance_KI;

int Incremental_PI_Left(float Encoder,float Target);//左电机pid控制
int Incremental_PI_Right(float Encoder,float Target);//右电机pid控制
float Follow_Turn_PID(float Current_Angle,float Target_Angle);
float Distance_Adjust_PID(float Current_Distance,float Target_Distance);
float ELE_PID(int Current_ELE_ADC,int Target_ELE_ADC );

float CCD_PID(float Current_Value,float Target_Value );
float Along_Adjust_PID(float Current_Distance,float Target_Distance);//距离调整PID

#endif
