MXDfc/ShanghaiTech_EE114-Embedded-Systems/Lab2and3/Device Data/AI语音交互/1.教程资料/4 STM32通信/4.4.1 STM32语音识别例程/01 STM32F103/02 程序文件/STM32F103_Asr_recognition/USER/Servo.h

#ifndef _PWM_H_
#define _PWM_H_

#define SERVO1 PCout(10)			//控制爪子的开合
#define SERVO2 PCout(11)			//上下爪子的舵机
#define SERVO3 PCout(12)
#define SERVO4 PDout(2)
#define SERVO5 PBout(5)
#define SERVO6 PBout(8)


extern uint16 ServoPwmDutySet[];

extern bool ServoPwmDutyHaveChange;

void ServoSetPluseAndTime(uint8 id,uint16 p,uint16 time);
void ServoPwmDutyCompare(void);//脉宽变化比较及速度控制
void InitServo(void);
bool ServoAction(void);   //判断舵机是否在运作

#endif
