MXDfc/ShanghaiTech_EE114-Embedded-Systems/Lab2and3/Device Data/AI语音交互/1.教程资料/4 STM32通信/4.4.1 STM32语音识别例程/01 STM32F103/02 程序文件/STM32F103_Asr_recognition/USER/Control.c

#include "include.h"

void Control(void)
{	
	u8 val;
	IIC_start();  
	IIC_send_byte(0x78);
	//IIC_wait_ack();	   
	//IIC_send_byte(0x01);   		
	val = IIC_wait_ack(); 	 										  		   

	//IIC_start();  	 	   		
	//IIC_send_byte(0x78);
	//IIC_wait_ack();
	//val = IIC_read_byte(1);	     	   
	IIC_stop();
	printf("%d",val);
  //printf("\n");
	DelayMs(1000);
}
