MXDfc/ShanghaiTech_EE114-Embedded-Systems/Lab11and12/WHEELTEC L150(LD14P) 避障巡线小车源码_2026.04.13/WHEELTEC L150(LD14P) 避障巡线雷达小车标准库_2026.04.13/User/CONTROL/capture.c

/***********************************************
公司：轮趣科技（东莞）有限公司
品牌：WHEELTEC
官网：wheeltec.net
淘宝店铺：shop114407458.taobao.com 
速卖通: https://minibalance.aliexpress.com/store/4455017
版本：V1.0
修改时间：2023-03-02

Brand: WHEELTEC
Website: wheeltec.net
Taobao shop: shop114407458.taobao.com 
Aliexpress: https://minibalance.aliexpress.com/store/4455017
Version: V1.0
Update：2023-03-02

All rights reserved
***********************************************/

//这个模块默认不使用
//4路超声波模块
//或 4路航模遥控
#include "capture.h"

//Variables related to remote control acquisition of model aircraft
//航模遥控采集相关变量
int Remoter_Ch1=1500,Remoter_Ch2=1500,Remoter_Ch3=1500,Remoter_Ch4=1500;
//Model aircraft remote control receiver variable
//航模遥控接收变量
int L_Remoter_Ch1=1500,L_Remoter_Ch2=1500,L_Remoter_Ch3=1500,L_Remoter_Ch4=1500; 

u16 Distance1,Distance2,Distance3,Distance4;	//4个超声波测距距离变量

// 定时器输入捕获用户自定义变量结构体定义
TIM_ICUserValueTypeDef Distance_TIM2_CH2_ICUserValueStructure = {0,0,0,0};//超声波模块1捕获相应的变量
TIM_ICUserValueTypeDef Distance_TIM2_CH3_ICUserValueStructure = {0,0,0,0};//超声波模块2捕获相应的变量
TIM_ICUserValueTypeDef Distance_TIM2_CH4_ICUserValueStructure = {0,0,0,0};//超声波模块3捕获相应的变量
TIM_ICUserValueTypeDef Distance_TIM1_CH4_ICUserValueStructure = {0,0,0,0};//超声波模块4捕获相应的变量


TIM_ICUserValueTypeDef PWM_TIM2_CH4_ICUserValueStructure = {0,0,0,0};//航模遥控第一路
TIM_ICUserValueTypeDef PWM_TIM2_CH3_ICUserValueStructure = {0,0,0,0};//航模遥控第二路
TIM_ICUserValueTypeDef PWM_TIM1_CH4_ICUserValueStructure = {0,0,0,0};//航模遥控第三路
TIM_ICUserValueTypeDef PWM_TIM1_CH1_ICUserValueStructure = {0,0,0,0};//航模遥控第四路


/**************************************************************************
Function: Distance_Capture_GPIO_Config
Input   : none
Output  : none
函数功能：超声波端口初始化
入口参数: 无
返回  值：无
**************************************************************************/	 	
void Distance_Capture_GPIO_Config(void)
{
	GPIO_InitTypeDef GPIO_InitStructure;
	RCC_APB2PeriphClockCmd(CAPTURE_TIM2_CH2_GPIO_CLK|CAPTURE_TRIG_GPIO_CLK1,ENABLE);//超声波模块1端口使能
	RCC_APB2PeriphClockCmd(CAPTURE_TIM2_CH3_GPIO_CLK|CAPTURE_TRIG_GPIO_CLK2,ENABLE);//超声波模块2端口使能
	RCC_APB2PeriphClockCmd(CAPTURE_TIM2_CH4_GPIO_CLK|CAPTURE_TRIG_GPIO_CLK3,ENABLE);//超声波模块3端口使能
	RCC_APB2PeriphClockCmd(CAPTURE_TIM1_CH4_GPIO_CLK|CAPTURE_TRIG_GPIO_CLK4,ENABLE);//超声波模块4端口使能

	//超声波模块1
	GPIO_InitStructure.GPIO_Pin  = CAPTURE_TIM2_CH2_PIN; 
	GPIO_InitStructure.GPIO_Mode = GPIO_Mode_IPD; 				//PA1 输入  
	GPIO_Init(CAPTURE_TIM2_CH2_PORT, &GPIO_InitStructure);

	GPIO_InitStructure.GPIO_Pin  = CAPTURE_TRIG_PIN1;     
	GPIO_InitStructure.GPIO_Mode = GPIO_Mode_Out_PP;     		//PC15输出 
	GPIO_InitStructure.GPIO_Speed = GPIO_Speed_2MHz;    
	GPIO_Init(CAPTURE_TRIG_PORT1, &GPIO_InitStructure);

	//超声波模块2
	GPIO_InitStructure.GPIO_Pin  = CAPTURE_TIM2_CH3_PIN; 
	GPIO_InitStructure.GPIO_Mode = GPIO_Mode_IPD; 				//PA2 输入  
	GPIO_Init(CAPTURE_TIM2_CH3_PORT, &GPIO_InitStructure);

	GPIO_InitStructure.GPIO_Pin  = CAPTURE_TRIG_PIN2;     
	GPIO_InitStructure.GPIO_Mode = GPIO_Mode_Out_PP;     		//PA12输出 
	GPIO_InitStructure.GPIO_Speed = GPIO_Speed_2MHz;    
	GPIO_Init(CAPTURE_TRIG_PORT2, &GPIO_InitStructure);
	
	//超声波模块3
	GPIO_InitStructure.GPIO_Pin  = CAPTURE_TIM2_CH4_PIN; 
	GPIO_InitStructure.GPIO_Mode = GPIO_Mode_IPD; 				//PA3 输入  
	GPIO_Init(CAPTURE_TIM2_CH4_PORT, &GPIO_InitStructure);

	GPIO_InitStructure.GPIO_Pin  = CAPTURE_TRIG_PIN3;     
	GPIO_InitStructure.GPIO_Mode = GPIO_Mode_Out_PP;     		//PB13输出 
	GPIO_InitStructure.GPIO_Speed = GPIO_Speed_2MHz;    
	GPIO_Init(CAPTURE_TRIG_PORT3, &GPIO_InitStructure);
	
	//超声波模块4
	GPIO_InitStructure.GPIO_Pin  = CAPTURE_TIM1_CH4_PIN; 
	GPIO_InitStructure.GPIO_Mode = GPIO_Mode_IPD; 				//PA11 输入  
	GPIO_Init(CAPTURE_TIM1_CH4_PORT, &GPIO_InitStructure);

	GPIO_InitStructure.GPIO_Pin  = CAPTURE_TRIG_PIN4;     
	GPIO_InitStructure.GPIO_Mode = GPIO_Mode_Out_PP;     		//PB12输出 
	GPIO_InitStructure.GPIO_Speed = GPIO_Speed_2MHz;    
	GPIO_Init(CAPTURE_TRIG_PORT4, &GPIO_InitStructure);
}


/**************************************************************************
Function: Distance_Capture_Mode_Config
Input   : TIM_Period,TIM_Prescaler
Output  : none
函数功能：超声波端口初始化
入口参数: 预装载值和预分频器 
返回  值：无
**************************************************************************/	 	
void Distance_Capture_Mode_Config(u16 arr,u16 psc)
{
	TIM_TimeBaseInitTypeDef  TIM_TimeBaseStructure;
	TIM_ICInitTypeDef  TIM_ICInitStructure;

	//使能定时器时钟。TIM2
	CAPTURE_TIM2_APBxClock_FUN(CAPTURE_TIM2_CLK,ENABLE);				
	//使能定时器时钟。TIM1
	CAPTURE_TIM1_APBxClock_FUN(CAPTURE_TIM1_CLK,ENABLE);
	
	/*时基定时器初始化*/
	//定时器2
	TIM_TimeBaseStructure.TIM_Period = arr; 					//设定计数器自动重装值 
	TIM_TimeBaseStructure.TIM_Prescaler =psc; 					//预分频器   
	TIM_TimeBaseStructure.TIM_ClockDivision = TIM_CKD_DIV1; 	//设置时钟分割:TDTS = Tck_tim
	TIM_TimeBaseStructure.TIM_CounterMode = TIM_CounterMode_Up; //TIM向上计数模式
	TIM_TimeBaseInit(CAPTURE_TIM2, &TIM_TimeBaseStructure); 	//根据TIM_TimeBaseInitStruct中指定的参数初始化TIMx的时间基数单位

	//定时器1
	TIM_TimeBaseStructure.TIM_Period = arr; 					//设定计数器自动重装值 
	TIM_TimeBaseStructure.TIM_Prescaler =psc; 					//预分频器   
	TIM_TimeBaseStructure.TIM_ClockDivision = TIM_CKD_DIV1; 	//设置时钟分割:TDTS = Tck_tim
	TIM_TimeBaseStructure.TIM_CounterMode = TIM_CounterMode_Up; //TIM向上计数模式
	TIM_TimeBaseInit(CAPTURE_TIM1, &TIM_TimeBaseStructure); 	//根据TIM_TimeBaseInitStruct中指定的参数初始化TIMx的时间基数单位

	/*捕获通道初始化*/
	//定时器2，CH2，CH3，CH4
	TIM_ICInitStructure.TIM_Channel = TIM_Channel_2; 			//通道2
	TIM_ICInitStructure.TIM_ICPolarity = TIM_ICPolarity_Rising;	//上升沿捕获
	TIM_ICInitStructure.TIM_ICSelection = TIM_ICSelection_DirectTI;
	TIM_ICInitStructure.TIM_ICPrescaler = TIM_ICPSC_DIV1;	 	//配置输入分频,不分频 
	TIM_ICInitStructure.TIM_ICFilter = 0x00;					//配置输入滤波器 不滤波
	TIM_ICInit(CAPTURE_TIM2, &TIM_ICInitStructure);

	TIM_ICInitStructure.TIM_Channel = TIM_Channel_3; 			//通道3
	TIM_ICInitStructure.TIM_ICPolarity = TIM_ICPolarity_Rising;	//上升沿捕获
	TIM_ICInitStructure.TIM_ICSelection = TIM_ICSelection_DirectTI;
	TIM_ICInitStructure.TIM_ICPrescaler = TIM_ICPSC_DIV1;	 	//配置输入分频,不分频 
	TIM_ICInitStructure.TIM_ICFilter = 0x00;					//配置输入滤波器 不滤波
	TIM_ICInit(CAPTURE_TIM2, &TIM_ICInitStructure);

	TIM_ICInitStructure.TIM_Channel = TIM_Channel_4; 			//通道4
	TIM_ICInitStructure.TIM_ICPolarity = TIM_ICPolarity_Rising;	//上升沿捕获
	TIM_ICInitStructure.TIM_ICSelection = TIM_ICSelection_DirectTI;
	TIM_ICInitStructure.TIM_ICPrescaler = TIM_ICPSC_DIV1;	 	//配置输入分频,不分频 
	TIM_ICInitStructure.TIM_ICFilter = 0x00;					//配置输入滤波器 不滤波
	TIM_ICInit(CAPTURE_TIM2, &TIM_ICInitStructure);

	//定时器1，CH4
	TIM_ICInitStructure.TIM_Channel = TIM_Channel_4; 			//通道4
	TIM_ICInitStructure.TIM_ICPolarity = TIM_ICPolarity_Rising;	//上升沿捕获
	TIM_ICInitStructure.TIM_ICSelection = TIM_ICSelection_DirectTI;
	TIM_ICInitStructure.TIM_ICPrescaler = TIM_ICPSC_DIV1;	 	//配置输入分频,不分频 
	TIM_ICInitStructure.TIM_ICFilter = 0x00;					//配置输入滤波器 不滤波
	TIM_ICInit(CAPTURE_TIM1, &TIM_ICInitStructure);

	//使能中断设置
	//TIM2_CH2,CH3,CH4
	TIM_ITConfig(CAPTURE_TIM2,TIM_IT_Update|TIM_IT_CC2|TIM_IT_CC3|TIM_IT_CC4,ENABLE);	//允许更新中断和捕获中断	
	//TIM1_CH4
	TIM_ITConfig(CAPTURE_TIM1,TIM_IT_Update|TIM_IT_CC4,ENABLE);	//允许更新中断 ,允许CC4IE捕获中断	

	//定时器使能
	TIM_Cmd(CAPTURE_TIM2,ENABLE); 										//使能定时器2
	
	TIM_Cmd(CAPTURE_TIM1,ENABLE); 										//使能定时器1
	
}

/**************************************************************************
Function: Distance_Capture_NVIC_Config
Input   : none
Output  : none
函数功能：超声波中断初始化
入口参数: 无 
返回  值：无
**************************************************************************/	 	

void Distance_Capture_NVIC_Config(void)
{
	NVIC_InitTypeDef NVIC_InitStructure;

	//中断优先级设置
	//TIM2总中断
	NVIC_InitStructure.NVIC_IRQChannel = CAPTURE_TIM2_IRQ;  	//TIM2中断
	NVIC_InitStructure.NVIC_IRQChannelPreemptionPriority = 1;  	//先占优先级2级
	NVIC_InitStructure.NVIC_IRQChannelSubPriority = 2;  		//从优先级2级
	NVIC_InitStructure.NVIC_IRQChannelCmd = ENABLE; 			//IRQ通道被使能
	NVIC_Init(&NVIC_InitStructure);  							//根据NVIC_InitStruct中指定的参数初始化外设NVIC寄存器 

	//TIM1更新中断和捕获中断
	NVIC_InitStructure.NVIC_IRQChannel = CAPTURE_TIM1_CC_IRQn;  //TIM1捕获中断
	NVIC_InitStructure.NVIC_IRQChannelPreemptionPriority = 1;  	//先占优先级2级
	NVIC_InitStructure.NVIC_IRQChannelSubPriority = 2;  		//从优先级2级
	NVIC_InitStructure.NVIC_IRQChannelCmd = ENABLE; 			//IRQ通道被使能
	NVIC_Init(&NVIC_InitStructure);  							//根据NVIC_InitStruct中指定的参数初始化外设NVIC寄存器 

	NVIC_InitStructure.NVIC_IRQChannel = PWM_TIM1_UP_IRQn;  	//TIM1更新中断
	NVIC_InitStructure.NVIC_IRQChannelPreemptionPriority = 1;  	//先占优先级2级
	NVIC_InitStructure.NVIC_IRQChannelSubPriority = 2;  		//从优先级2级
	NVIC_InitStructure.NVIC_IRQChannelCmd = ENABLE; 			//IRQ通道被使能
	NVIC_Init(&NVIC_InitStructure);  							//根据NVIC_InitStruct中指定的参数初始化外设NVIC寄存器 

}




/**************************************************************************
Function: Distance_Cap_Init
Input   : TIM_Period,TIM_Prescaler
Output  : none
函数功能：超声波初始化
入口参数: 预装载值和预分频器 
返回  值：无
**************************************************************************/	 	
void Distance_Cap_Init(u16 arr,u16 psc)
{
	Distance_Capture_GPIO_Config();
	Distance_Capture_NVIC_Config();
	Distance_Capture_Mode_Config(arr,psc);
}





/**************************************************************************
Function: PWM_Capture_GPIO_Config
Input   : none
Output  : none
函数功能：航模遥控端口初始化
入口参数: 无
返回  值：无
**************************************************************************/	 	
void PWM_Capture_GPIO_Config(void)
{
	GPIO_InitTypeDef GPIO_InitStructure;
	RCC_APB2PeriphClockCmd(PWM_TIM2_CH4_GPIO_CLK,ENABLE);//航模遥控第一路接口
	RCC_APB2PeriphClockCmd(PWM_TIM2_CH3_GPIO_CLK,ENABLE);//航模遥控第二路接口
//	RCC_APB2PeriphClockCmd(PWM_TIM1_CH4_GPIO_CLK,ENABLE);//航模遥控第三路接口
//	RCC_APB2PeriphClockCmd(PWM_TIM1_CH1_GPIO_CLK,ENABLE);//航模遥控第四路接口

	//第一路
	GPIO_InitStructure.GPIO_Pin  = PWM_TIM2_CH4_PIN; 
	GPIO_InitStructure.GPIO_Mode = GPIO_Mode_IPU; 				//PA3 输入  
	GPIO_Init(PWM_TIM2_CH4_PORT, &GPIO_InitStructure);


	//第二路
	GPIO_InitStructure.GPIO_Pin  = PWM_TIM2_CH3_PIN; 
	GPIO_InitStructure.GPIO_Mode = GPIO_Mode_IPU; 				//PA2 输入  
	GPIO_Init(PWM_TIM2_CH3_PORT, &GPIO_InitStructure);

	//第三路
//	GPIO_InitStructure.GPIO_Pin  = PWM_TIM1_CH4_PIN; 
//	GPIO_InitStructure.GPIO_Mode = GPIO_Mode_IPD; 				//PA11 输入  
//	GPIO_Init(PWM_TIM1_CH4_PORT, &GPIO_InitStructure);
//	
//	//第四路
//	GPIO_InitStructure.GPIO_Pin  = PWM_TIM1_CH1_PIN; 
//	GPIO_InitStructure.GPIO_Mode = GPIO_Mode_IPD; 				//PA8 输入  
//	GPIO_Init(PWM_TIM1_CH1_PORT, &GPIO_InitStructure);
}

/**************************************************************************
Function: PWM_Capture_Mode_Config
Input   : TIM_Period,TIM_Prescaler
Output  : none
函数功能：航模遥控捕获PWM高电平初始化
入口参数: 预装载值和预分频器 
返回  值：无
**************************************************************************/	 	
void PWM_Capture_Mode_Config(u16 arr,u16 psc)
{
	TIM_TimeBaseInitTypeDef  TIM_TimeBaseStructure;
	TIM_ICInitTypeDef  TIM_ICInitStructure;

	//使能定时器时钟。TIM2
	PWM_TIM2_APBxClock_FUN(PWM_TIM2_CLK,ENABLE);				
	//使能定时器时钟。TIM1
//	PWM_TIM1_APBxClock_FUN(PWM_TIM1_CLK,ENABLE);
	
	/*时基定时器初始化*/
	//定时器2
	TIM_TimeBaseStructure.TIM_Period = arr; 					//设定计数器自动重装值 
	TIM_TimeBaseStructure.TIM_Prescaler =psc; 					//预分频器   
	TIM_TimeBaseStructure.TIM_ClockDivision = TIM_CKD_DIV1; 	//设置时钟分割:TDTS = Tck_tim
	TIM_TimeBaseStructure.TIM_CounterMode = TIM_CounterMode_Up; //TIM向上计数模式
	TIM_TimeBaseInit(PWM_TIM2, &TIM_TimeBaseStructure); 		//根据TIM_TimeBaseInitStruct中指定的参数初始化TIMx的时间基数单位

	//定时器1
//	TIM_TimeBaseStructure.TIM_Period = arr; 					//设定计数器自动重装值 
//	TIM_TimeBaseStructure.TIM_Prescaler =psc; 					//预分频器   
//	TIM_TimeBaseStructure.TIM_ClockDivision = TIM_CKD_DIV1; 	//设置时钟分割:TDTS = Tck_tim
//	TIM_TimeBaseStructure.TIM_CounterMode = TIM_CounterMode_Up; //TIM向上计数模式
//	TIM_TimeBaseInit(PWM_TIM1, &TIM_TimeBaseStructure); 		//根据TIM_TimeBaseInitStruct中指定的参数初始化TIMx的时间基数单位

	/*捕获通道初始化*/
	//定时器2CH3，CH4
	TIM_ICInitStructure.TIM_Channel = TIM_Channel_3; 			//通道3
	TIM_ICInitStructure.TIM_ICPolarity = TIM_ICPolarity_Rising;	//上升沿捕获
	TIM_ICInitStructure.TIM_ICSelection = TIM_ICSelection_DirectTI;
	TIM_ICInitStructure.TIM_ICPrescaler = TIM_ICPSC_DIV1;	 	//配置输入分频,不分频 
	TIM_ICInitStructure.TIM_ICFilter = 0x00;					//配置输入滤波器 不滤波
	TIM_ICInit(PWM_TIM2, &TIM_ICInitStructure);

	TIM_ICInitStructure.TIM_Channel = TIM_Channel_4; 			//通道4
	TIM_ICInitStructure.TIM_ICPolarity = TIM_ICPolarity_Rising;	//上升沿捕获
	TIM_ICInitStructure.TIM_ICSelection = TIM_ICSelection_DirectTI;
	TIM_ICInitStructure.TIM_ICPrescaler = TIM_ICPSC_DIV1;	 	//配置输入分频,不分频 
	TIM_ICInitStructure.TIM_ICFilter = 0x00;					//配置输入滤波器 不滤波
	TIM_ICInit(PWM_TIM2, &TIM_ICInitStructure);

	//定时器1CH4，CH3
//	TIM_ICInitStructure.TIM_Channel = TIM_Channel_4; 			//通道4
//	TIM_ICInitStructure.TIM_ICPolarity = TIM_ICPolarity_Rising;	//上升沿捕获
//	TIM_ICInitStructure.TIM_ICSelection = TIM_ICSelection_DirectTI;
//	TIM_ICInitStructure.TIM_ICPrescaler = TIM_ICPSC_DIV1;	 	//配置输入分频,不分频 
//	TIM_ICInitStructure.TIM_ICFilter = 0x00;					//配置输入滤波器 不滤波
//	TIM_ICInit(PWM_TIM1, &TIM_ICInitStructure);

//	TIM_ICInitStructure.TIM_Channel = TIM_Channel_1; 			//通道4
//	TIM_ICInitStructure.TIM_ICPolarity = TIM_ICPolarity_Rising;	//上升沿捕获
//	TIM_ICInitStructure.TIM_ICSelection = TIM_ICSelection_DirectTI;
//	TIM_ICInitStructure.TIM_ICPrescaler = TIM_ICPSC_DIV1;	 	//配置输入分频,不分频 
//	TIM_ICInitStructure.TIM_ICFilter = 0x00;					//配置输入滤波器 不滤波
//	TIM_ICInit(PWM_TIM1, &TIM_ICInitStructure);

	//使能中断设置
	//TIM2_CH3,CH4
	TIM_ITConfig(PWM_TIM2,TIM_IT_CC3|TIM_IT_CC4,ENABLE);	//允许捕获中断	
	//TIM1_CH1，CH4
//	TIM_ITConfig(PWM_TIM1,TIM_IT_Update|TIM_IT_CC1|TIM_IT_CC4,ENABLE);	//允许更新中断 ,允许CC4IE捕获中断	

	//定时器使能
	TIM_Cmd(PWM_TIM2,ENABLE); 										//使能定时器2
	
//	TIM_Cmd(PWM_TIM1,ENABLE); 										//使能定时器1
	
}
/**************************************************************************
Function: PWM_Capture_Mode_Config
Input   : none
Output  : none
函数功能：航模遥控捕获PWM高电平初始化
入口参数: 无 
返回  值：无
**************************************************************************/	 	

void PWM_Capture_NVIC_Config(void)
{
	NVIC_InitTypeDef NVIC_InitStructure;

	//中断优先级设置
	//TIM2总中断
	NVIC_InitStructure.NVIC_IRQChannel = PWM_TIM2_IRQ;  		//TIM2中断
	NVIC_InitStructure.NVIC_IRQChannelPreemptionPriority = 1;  	//先占优先级2级
	NVIC_InitStructure.NVIC_IRQChannelSubPriority = 2;  		//从优先级2级
	NVIC_InitStructure.NVIC_IRQChannelCmd = ENABLE; 			//IRQ通道被使能
	NVIC_Init(&NVIC_InitStructure);  							//根据NVIC_InitStruct中指定的参数初始化外设NVIC寄存器 

	//TIM1更新中断和捕获中断
//	NVIC_InitStructure.NVIC_IRQChannel = PWM_TIM1_CC_IRQn;  	//TIM1捕获中断
//	NVIC_InitStructure.NVIC_IRQChannelPreemptionPriority = 1;  	//先占优先级2级
//	NVIC_InitStructure.NVIC_IRQChannelSubPriority = 2;  		//从优先级2级
//	NVIC_InitStructure.NVIC_IRQChannelCmd = ENABLE; 			//IRQ通道被使能
//	NVIC_Init(&NVIC_InitStructure);  							//根据NVIC_InitStruct中指定的参数初始化外设NVIC寄存器 

//	NVIC_InitStructure.NVIC_IRQChannel = CAPTURE_TIM1_UP_IRQn;  //TIM1更新中断
//	NVIC_InitStructure.NVIC_IRQChannelPreemptionPriority = 1;  	//先占优先级2级
//	NVIC_InitStructure.NVIC_IRQChannelSubPriority = 2;  		//从优先级2级
//	NVIC_InitStructure.NVIC_IRQChannelCmd = ENABLE; 			//IRQ通道被使能
//	NVIC_Init(&NVIC_InitStructure);  							//根据NVIC_InitStruct中指定的参数初始化外设NVIC寄存器 

}




/**************************************************************************
Function: PWM_Capture_Mode_Config
Input   : TIM_Period,TIM_Prescaler
Output  : none
函数功能：航模遥控捕获PWM高电平初始化
入口参数: 预装载值和预分频器 
返回  值：无
**************************************************************************/	 	
void PWM_Cap_Init(u16 arr,u16 psc)
{
	PWM_Capture_GPIO_Config();
	PWM_Capture_NVIC_Config();
	PWM_Capture_Mode_Config(arr,psc);
}




/**************************************************************************
Function: Read_Distane
Input   : none
Output  : none
函数功能：获取超声波测距距离
入口参数: 无
返回  值：无
**************************************************************************/	 	
//在5ms定时中断中调用
void Read_Distane(void)        
{   
	
	static u16 cnt = 0;	 //计数，超声波触发不要太频繁，会对距离的获取有一定的影响
	u32 temp_distance;
	cnt++;
	if(cnt == 20)		 //调节触发的速度
	{
		TRIG_HIGH1;      //超声波模块1触发   
		delay_us(15);  
		TRIG_LOW1;	
		
		TRIG_HIGH2;      //超声波模块2触发   
		delay_us(15);  
		TRIG_LOW2;	

	}
	if(cnt == 40)
	{
		cnt =0;
		TRIG_HIGH3;      //超声波模块3触发   
		delay_us(15);  
		TRIG_LOW3;	
		
		TRIG_HIGH4;      //超声波模块4触发   
		delay_us(15);  
		TRIG_LOW4;	
	}

	//超声波模块1
	if(Distance_TIM2_CH2_ICUserValueStructure.Capture_FinishFlag)//成功捕获到了一次高电平
	{
		temp_distance=Distance_TIM2_CH2_ICUserValueStructure.Capture_CcrValue+Distance_TIM2_CH2_ICUserValueStructure.Capture_Period*65536; //一共计数多少次
		Distance1=temp_distance*Light_Speed/2/1000;  						//时间*声速/2（来回） 一个计数0.001ms
		Distance_TIM2_CH2_ICUserValueStructure.Capture_FinishFlag = 0;			//开启下一次捕获
	}
	//超声波模块2
	if(Distance_TIM2_CH3_ICUserValueStructure.Capture_FinishFlag)//成功捕获到了一次高电平
	{
		temp_distance=Distance_TIM2_CH3_ICUserValueStructure.Capture_CcrValue+Distance_TIM2_CH3_ICUserValueStructure.Capture_Period*65536; //一共计数多少次
		Distance2=temp_distance*Light_Speed/2/1000;  						//时间*声速/2（来回） 一个计数0.001ms
		Distance_TIM2_CH3_ICUserValueStructure.Capture_FinishFlag = 0;			//开启下一次捕获
	}
	//超声波模块3
	if(Distance_TIM2_CH4_ICUserValueStructure.Capture_FinishFlag)//成功捕获到了一次高电平
	{
		temp_distance=Distance_TIM2_CH4_ICUserValueStructure.Capture_CcrValue+Distance_TIM2_CH4_ICUserValueStructure.Capture_Period*65536; //一共计数多少次
		Distance3=temp_distance*Light_Speed/2/1000;  						//时间*声速/2（来回） 一个计数0.001ms
		Distance_TIM2_CH4_ICUserValueStructure.Capture_FinishFlag = 0;			//开启下一次捕获
	}
	//超声波模块4
	if(Distance_TIM1_CH4_ICUserValueStructure.Capture_FinishFlag)//成功捕获到了一次高电平
	{
		temp_distance=Distance_TIM1_CH4_ICUserValueStructure.Capture_CcrValue+Distance_TIM1_CH4_ICUserValueStructure.Capture_Period*65536; //一共计数多少次
		Distance4=temp_distance*Light_Speed/2/1000;  						//时间*声速/2（来回） 一个计数0.001ms
		Distance_TIM1_CH4_ICUserValueStructure.Capture_FinishFlag = 0;			//开启下一次捕获
	}

}


//使用超声波
#ifdef Distance_Capture


/**************************************************************************
Function: CAPTURE_TIM2_IRQHandler
Input   : none
Output  : none
函数功能：高电平捕获中断函数
入口参数: 无
返回  值：无
**************************************************************************/	 	
void CAPTURE_TIM2_IRQHandler(void)
{ 	
	// 当要被捕获的信号的周期大于定时器的最长定时时，定时器就会溢出，产生更新中断
	// 这个时候我们需要把这个最长的定时周期加到捕获信号的时间里面去
	
	/*************************************通道2*******************************************/
	
	if(Distance_TIM2_CH2_ICUserValueStructure.Capture_FinishFlag == 0)//没有完成一次的时候捕获才能进去，防止溢出次数错误
	{
		if ( TIM_GetITStatus ( CAPTURE_TIM2, TIM_IT_Update) != RESET )               
			Distance_TIM2_CH2_ICUserValueStructure.Capture_Period ++;
		
		// 捕获中断，第一次是上升沿中断，第二次是下降沿中断
		if ( TIM_GetITStatus (CAPTURE_TIM2, TIM_IT_CC2 ) != RESET)
		{
			// 第一次捕获
			if ( Distance_TIM2_CH2_ICUserValueStructure.Capture_StartFlag == 0 )
			{
				//第一次捕获时，把捕获值储存起来
				Distance_TIM2_CH2_ICUserValueStructure.Capture_CcrValue = 
				TIM_GetCapture2 (CAPTURE_TIM2);
				// 自动重装载寄存器更新标志清0
				Distance_TIM2_CH2_ICUserValueStructure.Capture_Period = 0;
//				// 存捕获比较寄存器的值的变量的值清0			
//				Distance_TIM2_CH2_ICUserValueStructure.Capture_CcrValue = 0;

				// 当第一次捕获到上升沿之后，就把捕获边沿配置为下降沿
				TIM_OC2PolarityConfig(CAPTURE_TIM2, CAPTURE_TIM_END_ICPolarity);
				// 开始捕获标志位置1			
				Distance_TIM2_CH2_ICUserValueStructure.Capture_StartFlag = 1;			
			}
			// 下降沿捕获中断
			else // 第二次捕获
			{
				// 获取捕获比较寄存器的值，这个值就是捕获到的高电平的时间的值
				Distance_TIM2_CH2_ICUserValueStructure.Capture_CcrValue = 
				TIM_GetCapture2 (CAPTURE_TIM2)-Distance_TIM2_CH2_ICUserValueStructure.Capture_CcrValue;

				// 当第二次捕获到下降沿之后，就把捕获边沿配置为上升沿，好开启新的一轮捕获
				TIM_OC2PolarityConfig(CAPTURE_TIM2, CAPTURE_TIM_STRAT_ICPolarity);
				// 开始捕获标志清0		
				Distance_TIM2_CH2_ICUserValueStructure.Capture_StartFlag = 0;
				// 捕获完成标志置1			
				Distance_TIM2_CH2_ICUserValueStructure.Capture_FinishFlag = 1;		
			}
			//清除中断
			TIM_ClearITPendingBit (CAPTURE_TIM2,TIM_IT_CC2);	
		}		
	}

	/*************************************通道3*******************************************/
	if(Distance_TIM2_CH3_ICUserValueStructure.Capture_FinishFlag == 0)//没有完成一次的时候捕获才能进去，防止溢出次数错误
	{
		if ( TIM_GetITStatus ( CAPTURE_TIM2, TIM_IT_Update) != RESET )               
			Distance_TIM2_CH3_ICUserValueStructure.Capture_Period ++;
		
		// 捕获中断，第一次是上升沿中断，第二次是下降沿中断
		if ( TIM_GetITStatus (CAPTURE_TIM2, TIM_IT_CC3 ) != RESET)
		{
			// 第一次捕获
			if ( Distance_TIM2_CH3_ICUserValueStructure.Capture_StartFlag == 0 )
			{
				//第一次捕获时，把捕获值储存起来
				Distance_TIM2_CH3_ICUserValueStructure.Capture_CcrValue = 
				TIM_GetCapture3 (CAPTURE_TIM2);
				// 自动重装载寄存器更新标志清0
				Distance_TIM2_CH3_ICUserValueStructure.Capture_Period = 0;
//				// 存捕获比较寄存器的值的变量的值清0			
//				Distance_TIM2_CH2_ICUserValueStructure.Capture_CcrValue = 0;

				// 当第一次捕获到上升沿之后，就把捕获边沿配置为下降沿
				TIM_OC3PolarityConfig(CAPTURE_TIM2, CAPTURE_TIM_END_ICPolarity);
				// 开始捕获标志位置1			
				Distance_TIM2_CH3_ICUserValueStructure.Capture_StartFlag = 1;			
			}
			// 下降沿捕获中断
			else // 第二次捕获
			{
				// 获取捕获比较寄存器的值，这个值就是捕获到的高电平的时间的值
				Distance_TIM2_CH3_ICUserValueStructure.Capture_CcrValue = 
				TIM_GetCapture3 (CAPTURE_TIM2)-Distance_TIM2_CH3_ICUserValueStructure.Capture_CcrValue;

				// 当第二次捕获到下降沿之后，就把捕获边沿配置为上升沿，好开启新的一轮捕获
				TIM_OC3PolarityConfig(CAPTURE_TIM2, CAPTURE_TIM_STRAT_ICPolarity);
				// 开始捕获标志清0		
				Distance_TIM2_CH3_ICUserValueStructure.Capture_StartFlag = 0;
				// 捕获完成标志置1			
				Distance_TIM2_CH3_ICUserValueStructure.Capture_FinishFlag = 1;		
			}
			//清除中断
			TIM_ClearITPendingBit (CAPTURE_TIM2,TIM_IT_CC3);	
		}		
	}
	/*************************************通道4*******************************************/
	if(Distance_TIM2_CH4_ICUserValueStructure.Capture_FinishFlag == 0)//没有完成一次的时候捕获才能进去，防止溢出次数错误
	{
		if ( TIM_GetITStatus ( CAPTURE_TIM2, TIM_IT_Update) != RESET )               
			Distance_TIM2_CH4_ICUserValueStructure.Capture_Period ++;

		// 捕获中断，第一次是上升沿中断，第二次是下降沿中断
		if ( TIM_GetITStatus (CAPTURE_TIM2, TIM_IT_CC4 ) != RESET)
		{
			// 第一次捕获
			if ( Distance_TIM2_CH4_ICUserValueStructure.Capture_StartFlag == 0 )
			{
				//第一次捕获时，把捕获值储存起来
				Distance_TIM2_CH4_ICUserValueStructure.Capture_CcrValue = 
				TIM_GetCapture4 (CAPTURE_TIM2);
				// 自动重装载寄存器更新标志清0
				Distance_TIM2_CH4_ICUserValueStructure.Capture_Period = 0;
//				// 存捕获比较寄存器的值的变量的值清0			
//				Distance_TIM2_CH2_ICUserValueStructure.Capture_CcrValue = 0;

				// 当第一次捕获到上升沿之后，就把捕获边沿配置为下降沿
				TIM_OC4PolarityConfig(CAPTURE_TIM2, CAPTURE_TIM_END_ICPolarity);
				// 开始捕获标志位置1			
				Distance_TIM2_CH4_ICUserValueStructure.Capture_StartFlag = 1;			
			}
			// 下降沿捕获中断
			else // 第二次捕获
			{
				// 获取捕获比较寄存器的值，这个值就是捕获到的高电平的时间的值
				Distance_TIM2_CH4_ICUserValueStructure.Capture_CcrValue = 
				TIM_GetCapture4(CAPTURE_TIM2)-Distance_TIM2_CH4_ICUserValueStructure.Capture_CcrValue;

				// 当第二次捕获到下降沿之后，就把捕获边沿配置为上升沿，好开启新的一轮捕获
				TIM_OC4PolarityConfig(CAPTURE_TIM2, CAPTURE_TIM_STRAT_ICPolarity);
				// 开始捕获标志清0		
				Distance_TIM2_CH4_ICUserValueStructure.Capture_StartFlag = 0;
				// 捕获完成标志置1			
				Distance_TIM2_CH4_ICUserValueStructure.Capture_FinishFlag = 1;		
			}
			//清除中断
			TIM_ClearITPendingBit (CAPTURE_TIM2,TIM_IT_CC4);	
		}		
	}
	TIM_ClearITPendingBit (CAPTURE_TIM2,TIM_IT_Update|TIM_IT_CC2|TIM_IT_CC3|TIM_IT_CC4);	

}
/**************************************************************************
Function: CAPTURE_TIM1_CC_IRQHandler
Input   : none
Output  : none
函数功能：高电平捕获中断函数
入口参数: 无
返回  值：无
**************************************************************************/	 	
//超声波模块4捕获中断
void CAPTURE_TIM1_CC_IRQHandler(void)
{
	/*************************************通道4*******************************************/
	if(Distance_TIM1_CH4_ICUserValueStructure.Capture_FinishFlag == 0)//没有完成一次的时候捕获才能进去，防止溢出次数错误
	{
		// 捕获中断，第一次是上升沿中断，第二次是下降沿中断
		if ( TIM_GetITStatus (CAPTURE_TIM1, TIM_IT_CC4 ) != RESET)
		{
			// 第一次捕获
			if ( Distance_TIM1_CH4_ICUserValueStructure.Capture_StartFlag == 0 )
			{
				//第一次捕获时，把捕获值储存起来
				Distance_TIM1_CH4_ICUserValueStructure.Capture_CcrValue = 
				TIM_GetCapture4 (CAPTURE_TIM1);
				// 自动重装载寄存器更新标志清0
				Distance_TIM1_CH4_ICUserValueStructure.Capture_Period = 0;
//				// 存捕获比较寄存器的值的变量的值清0			
//				Distance_TIM2_CH2_ICUserValueStructure.Capture_CcrValue = 0;

				// 当第一次捕获到上升沿之后，就把捕获边沿配置为下降沿
				TIM_OC4PolarityConfig(CAPTURE_TIM1, CAPTURE_TIM_END_ICPolarity);
				// 开始捕获标志位置1			
				Distance_TIM1_CH4_ICUserValueStructure.Capture_StartFlag = 1;			
			}
			// 下降沿捕获中断
			else // 第二次捕获
			{
				// 获取捕获比较寄存器的值，这个值就是捕获到的高电平的时间的值
				Distance_TIM1_CH4_ICUserValueStructure.Capture_CcrValue = 
				TIM_GetCapture4(CAPTURE_TIM1)-Distance_TIM1_CH4_ICUserValueStructure.Capture_CcrValue;

				// 当第二次捕获到下降沿之后，就把捕获边沿配置为上升沿，好开启新的一轮捕获
				TIM_OC4PolarityConfig(CAPTURE_TIM1, CAPTURE_TIM_STRAT_ICPolarity);
				// 开始捕获标志清0		
				Distance_TIM1_CH4_ICUserValueStructure.Capture_StartFlag = 0;
				// 捕获完成标志置1			
				Distance_TIM1_CH4_ICUserValueStructure.Capture_FinishFlag = 1;		
			}
			//清除中断
			TIM_ClearITPendingBit (CAPTURE_TIM1,TIM_IT_CC4);	
		}		
	}

	TIM_ClearITPendingBit (CAPTURE_TIM1,TIM_IT_CC4);	
}

/**************************************************************************
Function: CAPTURE_TIM1_UP_IRQHandler
Input   : none
Output  : none
函数功能：高电平捕获中断函数
入口参数: 无
返回  值：无
**************************************************************************/	 	

//超声波模块4更新中断
void CAPTURE_TIM1_UP_IRQHandler(void)
{
	if(Distance_TIM1_CH4_ICUserValueStructure.Capture_FinishFlag == 0)//没有完成一次的时候捕获才能进去，防止溢出次数错误
	{
		if ( TIM_GetITStatus ( CAPTURE_TIM1, TIM_IT_Update) != RESET )               
		{	
			Distance_TIM1_CH4_ICUserValueStructure.Capture_Period ++;
			//清除中断
			TIM_ClearITPendingBit (CAPTURE_TIM1,TIM_IT_Update);	    
		}
	}
	
	TIM_ClearITPendingBit (CAPTURE_TIM1,TIM_IT_Update);	

}


#endif


//使用航模遥控
#ifdef PWM_Capture
/**************************************************************************
Function: PWM_TIM2_IRQHandler
Input   : none
Output  : none
函数功能：高电平捕获中断函数
入口参数: 无
返回  值：无
**************************************************************************/	 	
void PWM_TIM2_IRQHandler(void)
{
	static u8 ch1_filter_times=0,ch2_filter_times=0;
	//连接航模遥遥控器后，需要推下前进杆，才可以正式航模控制小车
	//After connecting the remote controller of the model aircraft, 
	//you need to push down the forward lever to officially control the car of the model aircraft
  if(Remoter_Ch2>1600&&Remote_ON_Flag==RC_OFF)
  {
		//Model aircraft remote control mark position 1, other marks position 0
		//航模遥控标志位置1，其它标志位置0
		Remote_ON_Flag=RC_ON;
	  APP_ON_Flag=RC_OFF;
		PS2_ON_Flag=RC_OFF;
	  ROS_ON_Flag=RC_OFF;
	}
	/*************************************通道3*******************************************/
//	if(PWM_TIM2_CH3_ICUserValueStructure.Capture_FinishFlag == 0)//没有完成一次的时候捕获才能进去，防止溢出次数错误
//	{
//		if ( TIM_GetITStatus ( PWM_TIM2, TIM_IT_Update) != RESET )               
//			PWM_TIM2_CH3_ICUserValueStructure.Capture_Period ++;
			
		// 捕获中断，第一次是上升沿中断，第二次是下降沿中断
		if ( TIM_GetITStatus (PWM_TIM2, TIM_IT_CC3 ) != RESET)
		{
			// 第一次捕获
			if ( PWM_TIM2_CH3_ICUserValueStructure.Capture_StartFlag == 0 )
			{
				//第一次捕获时，把捕获值储存起来
				PWM_TIM2_CH3_ICUserValueStructure.Capture_CcrValue = 
				TIM_GetCapture3 (PWM_TIM2);
				// 自动重装载寄存器更新标志清0
//				PWM_TIM2_CH3_ICUserValueStructure.Capture_Period = 0;
//				// 存捕获比较寄存器的值的变量的值清0			
//				Distance_TIM2_CH2_ICUserValueStructure.Capture_CcrValue = 0;

				// 当第一次捕获到上升沿之后，就把捕获边沿配置为下降沿
				TIM_OC3PolarityConfig(PWM_TIM2, CAPTURE_TIM_END_ICPolarity);
				// 开始捕获标志位置1			
				PWM_TIM2_CH3_ICUserValueStructure.Capture_StartFlag = 1;			
			}
			// 下降沿捕获中断
			else // 第二次捕获
			{
				// 获取捕获比较寄存器的值，这个值就是捕获到的高电平的时间的值
				Remoter_Ch2 = TIM_GetCapture3 (PWM_TIM2)-PWM_TIM2_CH3_ICUserValueStructure.Capture_CcrValue;
				if(abs(Remoter_Ch2-L_Remoter_Ch2)>500)
				{
					ch1_filter_times++;
					if(ch1_filter_times<=5) Remoter_Ch2 = L_Remoter_Ch2;
					else ch1_filter_times = 0;
				}
				else
					ch1_filter_times=0;
				L_Remoter_Ch2 = Remoter_Ch2;

				// 当第二次捕获到下降沿之后，就把捕获边沿配置为上升沿，好开启新的一轮捕获
				TIM_OC3PolarityConfig(PWM_TIM2, CAPTURE_TIM_STRAT_ICPolarity);
				// 开始捕获标志清0		
				PWM_TIM2_CH3_ICUserValueStructure.Capture_StartFlag = 0;
				// 捕获完成标志置1			
//				PWM_TIM2_CH3_ICUserValueStructure.Capture_FinishFlag = 1;		
			}
			//清除中断
			TIM_ClearITPendingBit (PWM_TIM2,TIM_IT_CC3);	
		}		
//	}
	/*************************************通道4*******************************************/
//	if(PWM_TIM2_CH4_ICUserValueStructure.Capture_FinishFlag == 0)//没有完成一次的时候捕获才能进去，防止溢出次数错误
//	{
//		if ( TIM_GetITStatus ( PWM_TIM2, TIM_IT_Update) != RESET )               
//			PWM_TIM2_CH4_ICUserValueStructure.Capture_Period ++;
			
		// 捕获中断，第一次是上升沿中断，第二次是下降沿中断
		if ( TIM_GetITStatus (PWM_TIM2, TIM_IT_CC4 ) != RESET)
		{
			// 第一次捕获
			if ( PWM_TIM2_CH4_ICUserValueStructure.Capture_StartFlag == 0 )
			{
				//第一次捕获时，把捕获值储存起来
				PWM_TIM2_CH4_ICUserValueStructure.Capture_CcrValue = 
				TIM_GetCapture4 (PWM_TIM2);
				// 自动重装载寄存器更新标志清0
//				PWM_TIM2_CH4_ICUserValueStructure.Capture_Period = 0;
//				// 存捕获比较寄存器的值的变量的值清0			
//				Distance_TIM2_CH2_ICUserValueStructure.Capture_CcrValue = 0;

				// 当第一次捕获到上升沿之后，就把捕获边沿配置为下降沿
				TIM_OC4PolarityConfig(PWM_TIM2, CAPTURE_TIM_END_ICPolarity);
				// 开始捕获标志位置1			
				PWM_TIM2_CH4_ICUserValueStructure.Capture_StartFlag = 1;			
			}
			// 下降沿捕获中断
			else // 第二次捕获
			{
				// 获取捕获比较寄存器的值，这个值就是捕获到的高电平的时间的值
				Remoter_Ch1 = TIM_GetCapture4(PWM_TIM2)-PWM_TIM2_CH4_ICUserValueStructure.Capture_CcrValue;
        if(abs(Remoter_Ch1-L_Remoter_Ch1)>500)
				{
					ch2_filter_times++;
					if(ch2_filter_times<=5) Remoter_Ch1 = L_Remoter_Ch1;
					else ch2_filter_times = 0;
				}
				else
					ch2_filter_times=0;
				L_Remoter_Ch1 = Remoter_Ch1;
				// 当第二次捕获到下降沿之后，就把捕获边沿配置为上升沿，好开启新的一轮捕获
				TIM_OC4PolarityConfig(PWM_TIM2, CAPTURE_TIM_STRAT_ICPolarity);
				// 开始捕获标志清0		
				PWM_TIM2_CH4_ICUserValueStructure.Capture_StartFlag = 0;
				// 捕获完成标志置1			
//				PWM_TIM2_CH4_ICUserValueStructure.Capture_FinishFlag = 1;		
			}
			//清除中断
			TIM_ClearITPendingBit (PWM_TIM2,TIM_IT_CC4);	
		}		
//	}
//	TIM_ClearITPendingBit (CAPTURE_TIM2,TIM_IT_CC3|TIM_IT_CC4);	

}

/**************************************************************************
Function: PWM_TIM1_CC_IRQHandler
Input   : none
Output  : none
函数功能：高电平捕获中断函数
入口参数: 无
返回  值：无
**************************************************************************/	 	

//void PWM_TIM1_CC_IRQHandler(void)
//{
//	static u8 ch3_filter_times=0, ch4_filter_times=0;
//		/*************************************通道1*******************************************/
//	if(PWM_TIM1_CH1_ICUserValueStructure.Capture_FinishFlag == 0)//没有完成一次的时候捕获才能进去，防止溢出次数错误
//	{
//		// 捕获中断，第一次是上升沿中断，第二次是下降沿中断
//		if ( TIM_GetITStatus (PWM_TIM1, TIM_IT_CC1 ) != RESET)
//		{
//			// 第一次捕获
//			if ( PWM_TIM1_CH1_ICUserValueStructure.Capture_StartFlag == 0 )
//			{
//				//第一次捕获时，把捕获值储存起来
//				PWM_TIM1_CH1_ICUserValueStructure.Capture_CcrValue = 
//				TIM_GetCapture1 (PWM_TIM1);
//				// 自动重装载寄存器更新标志清0
//				PWM_TIM1_CH1_ICUserValueStructure.Capture_Period = 0;
////				// 存捕获比较寄存器的值的变量的值清0			
////				Distance_TIM2_CH2_ICUserValueStructure.Capture_CcrValue = 0;

//				// 当第一次捕获到上升沿之后，就把捕获边沿配置为下降沿
//				TIM_OC1PolarityConfig(PWM_TIM1, CAPTURE_TIM_END_ICPolarity);
//				// 开始捕获标志位置1			
//				PWM_TIM1_CH1_ICUserValueStructure.Capture_StartFlag = 1;			
//			}
//			// 下降沿捕获中断
//			else // 第二次捕获
//			{
//				// 获取捕获比较寄存器的值，这个值就是捕获到的高电平的时间的值
//				Remoter_Ch4 = TIM_GetCapture1(PWM_TIM1)-PWM_TIM1_CH1_ICUserValueStructure.Capture_CcrValue;
//                if(abs(Remoter_Ch4-L_Remoter_Ch4)>500)
//				{
//					ch4_filter_times++;
//					if(ch4_filter_times<=5) Remoter_Ch4 = L_Remoter_Ch4;
//					else ch4_filter_times = 0;
//				}
//				else
//					ch4_filter_times=0;
//				L_Remoter_Ch4 = Remoter_Ch4;
//				// 当第二次捕获到下降沿之后，就把捕获边沿配置为上升沿，好开启新的一轮捕获
//				TIM_OC1PolarityConfig(PWM_TIM1, CAPTURE_TIM_STRAT_ICPolarity);
//				// 开始捕获标志清0		
//				PWM_TIM1_CH1_ICUserValueStructure.Capture_StartFlag = 0;
//				// 捕获完成标志置1			
//				PWM_TIM1_CH1_ICUserValueStructure.Capture_FinishFlag = 1;			
//			}
//			//清除中断
//			TIM_ClearITPendingBit (PWM_TIM1,TIM_IT_CC1);	
//		}		
//	}

//	
//	/*************************************通道4*******************************************/
//	if(PWM_TIM1_CH4_ICUserValueStructure.Capture_FinishFlag == 0)//没有完成一次的时候捕获才能进去，防止溢出次数错误
//	{
//		// 捕获中断，第一次是上升沿中断，第二次是下降沿中断
//		if ( TIM_GetITStatus (PWM_TIM1, TIM_IT_CC4 ) != RESET)
//		{
//			// 第一次捕获
//			if ( PWM_TIM1_CH4_ICUserValueStructure.Capture_StartFlag == 0 )
//			{
//				//第一次捕获时，把捕获值储存起来
//				PWM_TIM1_CH4_ICUserValueStructure.Capture_CcrValue = 
//				TIM_GetCapture4 (PWM_TIM1);
//				// 自动重装载寄存器更新标志清0
//				PWM_TIM1_CH4_ICUserValueStructure.Capture_Period = 0;
////				// 存捕获比较寄存器的值的变量的值清0			
////				Distance_TIM2_CH2_ICUserValueStructure.Capture_CcrValue = 0;

//				// 当第一次捕获到上升沿之后，就把捕获边沿配置为下降沿
//				TIM_OC4PolarityConfig(PWM_TIM1, CAPTURE_TIM_END_ICPolarity);
//				// 开始捕获标志位置1			
//				PWM_TIM1_CH4_ICUserValueStructure.Capture_StartFlag = 1;			
//			}
//			// 下降沿捕获中断
//			else // 第二次捕获
//			{
//				// 获取捕获比较寄存器的值，这个值就是捕获到的高电平的时间的值
//				Remoter_Ch3 = TIM_GetCapture4(PWM_TIM1)-PWM_TIM1_CH4_ICUserValueStructure.Capture_CcrValue;
//                if(abs(Remoter_Ch3-L_Remoter_Ch3)>500)
//				{
//					ch3_filter_times++;
//					if(ch3_filter_times<=5) Remoter_Ch3 = L_Remoter_Ch3;
//					else ch3_filter_times = 0;
//				}
//				else
//					ch3_filter_times=0;
//				L_Remoter_Ch3 = Remoter_Ch3;
//				// 当第二次捕获到下降沿之后，就把捕获边沿配置为上升沿，好开启新的一轮捕获
//				TIM_OC4PolarityConfig(PWM_TIM1, CAPTURE_TIM_STRAT_ICPolarity);
//				// 开始捕获标志清0		
//				PWM_TIM1_CH4_ICUserValueStructure.Capture_StartFlag = 0;
//				PWM_TIM1_CH4_ICUserValueStructure.Capture_FinishFlag = 0;
//				// 捕获完成标志置1			
//			}
//			//清除中断
//			TIM_ClearITPendingBit (PWM_TIM1,TIM_IT_CC4);	
//		}		
//	}

//	TIM_ClearITPendingBit (CAPTURE_TIM1,TIM_IT_CC4|TIM_IT_CC1);	
//}

///**************************************************************************
//Function: PWM_TIM1_UP_IRQHandler
//Input   : none
//Output  : none
//函数功能：高电平捕获中断函数
//入口参数: 无
//返回  值：无
//**************************************************************************/	 	

//void PWM_TIM1_UP_IRQHandler(void)
//{
//	//通道4
//	if(PWM_TIM1_CH4_ICUserValueStructure.Capture_FinishFlag == 0)//没有完成一次的时候捕获才能进去，防止溢出次数错误
//	{
//		if ( TIM_GetITStatus ( PWM_TIM1, TIM_IT_Update) != RESET )               
//			PWM_TIM1_CH4_ICUserValueStructure.Capture_Period ++;
//	}
//	//通道1
//	if(PWM_TIM1_CH1_ICUserValueStructure.Capture_FinishFlag == 0)//没有完成一次的时候捕获才能进去，防止溢出次数错误
//	{
//		if ( TIM_GetITStatus ( PWM_TIM1, TIM_IT_Update) != RESET )               
//			PWM_TIM1_CH1_ICUserValueStructure.Capture_Period ++;
//	}

//	TIM_ClearITPendingBit (PWM_TIM1,TIM_IT_Update);	

//}


#endif
