MXDfc/ShanghaiTech_EE114-Embedded-Systems/Lab11and12/WHEELTEC L150(LD14P) 避障巡线小车源码_2026.04.13/WHEELTEC L150(LD14P) 避障巡线雷达小车标准库_2026.04.13/User/HARDWARE/PSTWO/pstwo.c

/***********************************************
公司：轮趣科技（东莞）有限公司
品牌：WHEELTEC
官网：wheeltec.net
淘宝店铺：shop114407458.taobao.com 
速卖通: https://minibalance.aliexpress.com/store/4455017
版本：V1.0
修改时间：2023-03-02

Brand: WHEELTEC
Website: wheeltec.net
Taobao shop: shop114407458.taobao.com 
Aliexpress: https://minibalance.aliexpress.com/store/4455017
Version: V1.0
Update：2023-03-02

All rights reserved
***********************************************/

#include "./PSTWO/pstwo.h"
#define DELAY_TIME  delay_us(5); 
u16 Handkey;	// 按键值读取，临时存储。
u8 Comd[2]={0x01,0x42};	//开始命令。请求数据
u8 Data[9]={0x00,0x00,0x00,0x00,0x00,0x00,0x00,0x00,0x00}; //数据存储数组
u16 MASK[]={
    PSB_SELECT,
    PSB_L3,
    PSB_R3 ,
    PSB_START,
    PSB_PAD_UP,
    PSB_PAD_RIGHT,
    PSB_PAD_DOWN,
    PSB_PAD_LEFT,
    PSB_L2,
    PSB_R2,
    PSB_L1,
    PSB_R1 ,
    PSB_GREEN,
    PSB_RED,
    PSB_BLUE,
    PSB_PINK
	};	//按键值与按键明

//The PS2 gamepad controls related variables
//PS2手柄控制相关变量
int PS2_LX,PS2_LY,PS2_RX,PS2_RY,PS2_KEY; 

/**************************************************************************
Function: PS2_Init
Input   : none
Output  : none
函数功能: PS2手柄初始化
入口参数: 无 
返回  值：无
**************************************************************************/	 	
	
void PS2_Init(void)
{
	GPIO_InitTypeDef GPIO_InitStructure;
	RCC_APB2PeriphClockCmd(PS2_DI_GPIO_CLK|PS2_DO_GPIO_CLK,ENABLE);     //使能时钟,DI,DO 
	RCC_APB2PeriphClockCmd(PS2_CS_GPIO_CLK|PS2_CLK_GPIO_CLK,ENABLE);    //使能时钟,CS,CLK
	
	GPIO_InitStructure.GPIO_Mode=GPIO_Mode_IPU;           				//上拉输入
	GPIO_InitStructure.GPIO_Pin=PS2_DI_GPIO_PIN;                 		// DI 
	GPIO_Init(PS2_DI_GPIO_PORT,&GPIO_InitStructure);
	
	GPIO_InitStructure.GPIO_Mode=GPIO_Mode_Out_PP;              		//通用推挽输出
	GPIO_InitStructure.GPIO_Pin=PS2_DO_GPIO_PIN;                 		// DO 
	GPIO_InitStructure.GPIO_Speed=GPIO_Speed_50MHz;
	GPIO_Init(PS2_DO_GPIO_PORT,&GPIO_InitStructure);
	
	
	GPIO_InitStructure.GPIO_Mode=GPIO_Mode_Out_PP;           			//通用推挽输出
	GPIO_InitStructure.GPIO_Pin=PS2_CS_GPIO_PIN;     					// CS  
	GPIO_InitStructure.GPIO_Speed=GPIO_Speed_50MHz;
	GPIO_Init(PS2_CS_GPIO_PORT,&GPIO_InitStructure);

	GPIO_InitStructure.GPIO_Mode=GPIO_Mode_Out_PP;           			//通用推挽输出
	GPIO_InitStructure.GPIO_Pin=PS2_CLK_GPIO_PIN;     					// CLK  
	GPIO_InitStructure.GPIO_Speed=GPIO_Speed_50MHz;
	GPIO_Init(PS2_CLK_GPIO_PORT,&GPIO_InitStructure);

	
//	PWR->CR|=1<<8;	//取消备份区写保护 
//	RCC->BDCR&=0xFFFFFFFE;	//外部低俗振荡器关闭 PC14，PC15成为普通IO	 	
//	BKP->CR&=0xFFFFFFFE; 	//侵入检测TAMPER引脚作为通用IO口使用 
//	PWR->CR&=0xFFFFFEFF;	//备份区写保护	
}
/**************************************************************************
Function: Sent_Cmd
Input   : none
Output  : none
函数功能: 向手柄发送命令
入口参数: 无 
返回  值：无
**************************************************************************/	 	
//向手柄发送命令
void PS2_Cmd(u8 CMD)
{
	volatile u16 ref=0x01;
	Data[1] = 0;
	for(ref=0x01;ref<0x0100;ref<<=1)
	{
		if(ref&CMD)
		{
			DO_H;                  	 //输出一位控制位
		}
		else DO_L;

		CLK_H;                        //时钟拉高
		DELAY_TIME;
		CLK_L;
		DELAY_TIME;
		CLK_H;
		if(DI)
			Data[1] = ref|Data[1];
	}
	delay_us(16);
}
//判断是否为红灯模式,0x41=模拟绿灯，0x73=模拟红灯
//返回值；0，红灯模式
//		  其他，其他模式
u8 PS2_RedLight(void)
{
	CS_L;
	PS2_Cmd(Comd[0]);  //开始命令
	PS2_Cmd(Comd[1]);  //请求数据
	CS_H;
	if( Data[1] == 0X73)   return 0 ;
	else return 1;

}
//读取手柄数据
void PS2_ReadData(void)
{
	volatile u8 byte=0;
	volatile u16 ref=0x01;
	CS_L;
	PS2_Cmd(Comd[0]);  //开始命令
	PS2_Cmd(Comd[1]);  //请求数据
	for(byte=2;byte<9;byte++)          //开始接受数据
	{
		for(ref=0x01;ref<0x100;ref<<=1)
		{
			CLK_H;
			DELAY_TIME;
			CLK_L;
			DELAY_TIME;
			CLK_H;
		      if(DI)
		      Data[byte] = ref|Data[byte];
		}
        delay_us(16);
	}
	CS_H;
}

//对读出来的PS2的数据进行处理,只处理按键部分  
//只有一个按键按下时按下为0， 未按下为1
u8 PS2_DataKey()
{
	u8 index;

	PS2_ClearData();
	PS2_ReadData();

	Handkey=(Data[4]<<8)|Data[3];     //这是16个按键  按下为0， 未按下为1
	for(index=0;index<16;index++)
	{	    
		if((Handkey&(1<<(MASK[index]-1)))==0)
		return index+1;
	}
	return 0;          //没有任何按键按下
}

//得到一个摇杆的模拟量	 范围0~256
u8 PS2_AnologData(u8 button)
{
	return Data[button];
}

//清除数据缓冲区
void PS2_ClearData()
{
	u8 a;
	for(a=0;a<9;a++)
		Data[a]=0x00;
}
/******************************************************
Function:    void PS2_Vibration(u8 motor1, u8 motor2)
Description: 手柄震动函数，
Calls:		 void PS2_Cmd(u8 CMD);
Input: motor1:右侧小震动电机 0x00关，其他开
	   motor2:左侧大震动电机 0x40~0xFF 电机开，值越大 震动越大
******************************************************/
void PS2_Vibration(u8 motor1, u8 motor2)
{
	CS_L;
	delay_us(16);
    PS2_Cmd(0x01);  //开始命令
	PS2_Cmd(0x42);  //请求数据
	PS2_Cmd(0X00);
	PS2_Cmd(motor1);
	PS2_Cmd(motor2);
	PS2_Cmd(0X00);
	PS2_Cmd(0X00);
	PS2_Cmd(0X00);
	PS2_Cmd(0X00);
	CS_H;
	delay_us(16);  
}
//short poll
void PS2_ShortPoll(void)
{
	CS_L;
	delay_us(16);
	PS2_Cmd(0x01);  
	PS2_Cmd(0x42);  
	PS2_Cmd(0X00);
	PS2_Cmd(0x00);
	PS2_Cmd(0x00);
	CS_H;
	delay_us(16);	
}
//进入配置
void PS2_EnterConfing(void)
{
    CS_L;
	delay_us(16);
	PS2_Cmd(0x01);  
	PS2_Cmd(0x43);  
	PS2_Cmd(0X00);
	PS2_Cmd(0x01);
	PS2_Cmd(0x00);
	PS2_Cmd(0X00);
	PS2_Cmd(0X00);
	PS2_Cmd(0X00);
	PS2_Cmd(0X00);
	CS_H;
	delay_us(16);
}
//发送模式设置
void PS2_TurnOnAnalogMode(void)
{
	CS_L;
	PS2_Cmd(0x01);  
	PS2_Cmd(0x44);  
	PS2_Cmd(0X00);
	PS2_Cmd(0x01); //analog=0x01;digital=0x00  软件设置发送模式
	PS2_Cmd(0x03); //Ox03锁存设置，即不可通过按键“MODE”设置模式。
				   //0xEE不锁存软件设置，可通过按键“MODE”设置模式。
	PS2_Cmd(0X00);
	PS2_Cmd(0X00);
	PS2_Cmd(0X00);
	PS2_Cmd(0X00);
	CS_H;
	delay_us(16);
}
//振动设置
void PS2_VibrationMode(void)
{
	CS_L;
	delay_us(16);
	PS2_Cmd(0x01);  
	PS2_Cmd(0x4D);  
	PS2_Cmd(0X00);
	PS2_Cmd(0x00);
	PS2_Cmd(0X01);
	CS_H;
	delay_us(16);	
}
//完成并保存配置
void PS2_ExitConfing(void)
{
    CS_L;
	delay_us(16);
	PS2_Cmd(0x01);  
	PS2_Cmd(0x43);  
	PS2_Cmd(0X00);
	PS2_Cmd(0x00);
	PS2_Cmd(0x5A);
	PS2_Cmd(0x5A);
	PS2_Cmd(0x5A);
	PS2_Cmd(0x5A);
	PS2_Cmd(0x5A);
	CS_H;
	delay_us(16);
}
//手柄配置初始化
void PS2_SetInit(void)
{
	PS2_ShortPoll();
	PS2_ShortPoll();
	PS2_ShortPoll();
	PS2_EnterConfing();		//进入配置模式
	PS2_TurnOnAnalogMode();	//“红绿灯”配置模式，并选择是否保存
	//PS2_VibrationMode();	//开启震动模式
	PS2_ExitConfing();		//完成并保存配置
}



/**************************************************************************
Function: Read the control of the ps2 handle
Input   : none
Output  : none
函数功能：读取PS2手柄的控制量
入口参数：无
返回  值：无
**************************************************************************/
void PS2_Read(void)
{
	static int Strat;
	//Reading key
  //读取按键键值
	PS2_KEY=PS2_DataKey(); 
	//Read the analog of the remote sensing x axis on the left
  //读取左边遥感X轴方向的模拟量	
	PS2_LX=PS2_AnologData(PSS_LX); 
	//Read the analog of the directional direction of remote sensing on the left
  //读取左边遥感Y轴方向的模拟量	
	PS2_LY=PS2_AnologData(PSS_LY);
	//Read the analog of the remote sensing x axis
  //读取右边遥感X轴方向的模拟量  
	PS2_RX=PS2_AnologData(PSS_RX);
	//Read the analog of the directional direction of the remote sensing y axis
  //读取右边遥感Y轴方向的模拟量  
	PS2_RY=PS2_AnologData(PSS_RY);  

	if(PS2_KEY==4&&PS2_ON_Flag==0) 
		//The start button on the // handle is pressed
		//手柄上的Start按键被按下
		Strat=1; 
	//When the button is pressed, you need to push the right side forward to the formal ps2 control car
	//Start按键被按下后，需要推下左边前进杆，才可以正式PS2控制小车
	if(Strat&&(PS2_LY<118)&&PS2_ON_Flag==0)
	{
		PS2_ON_Flag=RC_ON;APP_ON_Flag=RC_OFF;ROS_ON_Flag=RC_OFF;Remote_ON_Flag=RC_OFF;
		RC_Velocity = Default_Velocity;
		if(Car_Num == Akm_Car)//如果是阿克曼车，转向速度是角度
		{
			RC_Turn_Velocity = PS2_Turn_Angle;
		}
		else			//其他车型是两轮差速
			RC_Turn_Velocity = Default_Turn_Bias;
	}
	
}
