MXDfc/ShanghaiTech_EE114-Embedded-Systems/Lab6/WHEELTEC L150 避障巡线雷达小车资料/WHEELTEC L150(LD14P) HAL/Src/adc.c

/**
  ******************************************************************************
  * @file    adc.c
  * @brief   This file provides code for the configuration
  *          of the ADC instances.
  ******************************************************************************
  * @attention
  *
  * <h2><center>&copy; Copyright (c) 2022 STMicroelectronics.
  * All rights reserved.</center></h2>
  *
  * This software component is licensed by ST under BSD 3-Clause license,
  * the "License"; You may not use this file except in compliance with the
  * License. You may obtain a copy of the License at:
  *                        opensource.org/licenses/BSD-3-Clause
  *
  ******************************************************************************
  */

/* Includes ------------------------------------------------------------------*/
#include "adc.h"

ADC_HandleTypeDef hadc1;
ADC_HandleTypeDef hadc2;

/* ADC1 init function */
void MX_ADC1_Init(void)
{

  ADC_ChannelConfTypeDef sConfig = {0};

  /** Common config
  */
  hadc1.Instance = ADC1;
  hadc1.Init.ScanConvMode = ADC_SCAN_DISABLE;
  hadc1.Init.ContinuousConvMode = DISABLE;
  hadc1.Init.DiscontinuousConvMode = DISABLE;
  hadc1.Init.ExternalTrigConv = ADC_SOFTWARE_START;
  hadc1.Init.DataAlign = ADC_DATAALIGN_RIGHT;
  hadc1.Init.NbrOfConversion = 1;
  if (HAL_ADC_Init(&hadc1) != HAL_OK)
  {
    Error_Handler();
  }
  /** Configure Regular Channel
  */
  sConfig.Channel = ADC_CHANNEL_10;
  sConfig.Rank = ADC_REGULAR_RANK_1;
  sConfig.SamplingTime = ADC_SAMPLETIME_239CYCLES_5;
  if (HAL_ADC_ConfigChannel(&hadc1, &sConfig) != HAL_OK)
  {
    Error_Handler();
  }
  /* USER CODE BEGIN ADC1_Init 2 */
  HAL_ADCEx_Calibration_Start(&hadc1);//开启adc校准
  /* USER CODE END ADC1_Init 2 */

}
/* ADC2 init function */
void MX_ADC2_Init(void)
{

  ADC_ChannelConfTypeDef sConfig = {0};

  /** Common config
  */
  hadc2.Instance = ADC2;
  hadc2.Init.ScanConvMode = ADC_SCAN_DISABLE;
  hadc2.Init.ContinuousConvMode = DISABLE;
  hadc2.Init.DiscontinuousConvMode = DISABLE;
  hadc2.Init.ExternalTrigConv = ADC_SOFTWARE_START;
  hadc2.Init.DataAlign = ADC_DATAALIGN_RIGHT;
  hadc2.Init.NbrOfConversion = 1;
  if (HAL_ADC_Init(&hadc2) != HAL_OK)
  {
    Error_Handler();
  }
  /** Configure Regular Channel
  */
  sConfig.Channel = ADC_CHANNEL_11;
  sConfig.Rank = ADC_REGULAR_RANK_1;
  sConfig.SamplingTime = ADC_SAMPLETIME_239CYCLES_5;
  if (HAL_ADC_ConfigChannel(&hadc2, &sConfig) != HAL_OK)
  {
    Error_Handler();
  }
  /* USER CODE BEGIN ADC2_Init 2 */
  HAL_ADCEx_Calibration_Start(&hadc2);//adc校准
	HAL_ADC_Start_IT(&hadc2);//开启中断
  /* USER CODE END ADC2_Init 2 */

}

void HAL_ADC_MspInit(ADC_HandleTypeDef* adcHandle)
{

  GPIO_InitTypeDef GPIO_InitStruct = {0};
  if(adcHandle->Instance==ADC1)
  {
    /* ADC1 clock enable */
    __HAL_RCC_ADC1_CLK_ENABLE();
    
		__HAL_RCC_GPIOA_CLK_ENABLE();
    __HAL_RCC_GPIOC_CLK_ENABLE();
    /**ADC1 GPIO Configuration
    PC0     ------> ADC1_IN10
		PA4     ------> ADC1_IN4
		PA5     ------> ADC1_IN5
    PC5     ------> ADC1_IN15
    */
    GPIO_InitStruct.Pin = GPIO_PIN_0;
    GPIO_InitStruct.Mode = GPIO_MODE_ANALOG;
    HAL_GPIO_Init(GPIOC, &GPIO_InitStruct);

		GPIO_InitStruct.Pin = GPIO_PIN_4|GPIO_PIN_5;
    GPIO_InitStruct.Mode = GPIO_MODE_ANALOG;
    HAL_GPIO_Init(GPIOA, &GPIO_InitStruct);
		
    GPIO_InitStruct.Pin = GPIO_PIN_5;
    GPIO_InitStruct.Mode = GPIO_MODE_ANALOG;
    HAL_GPIO_Init(GPIOC, &GPIO_InitStruct);
    /* ADC1 interrupt Init */
//    HAL_NVIC_SetPriority(ADC1_2_IRQn, 0, 0);
//    HAL_NVIC_DisableIRQ(ADC1_2_IRQn);//不开启中断
  }
  else if(adcHandle->Instance==ADC2)
  {
    /* ADC2 clock enable */
    __HAL_RCC_ADC2_CLK_ENABLE();

    __HAL_RCC_GPIOC_CLK_ENABLE();
    /**ADC2 GPIO Configuration
    PC1     ------> ADC2_IN11
    */
    GPIO_InitStruct.Pin = GPIO_PIN_1;
    GPIO_InitStruct.Mode = GPIO_MODE_ANALOG;
    HAL_GPIO_Init(GPIOC, &GPIO_InitStruct);

    /* ADC2 interrupt Init */
    HAL_NVIC_SetPriority(ADC1_2_IRQn, 0, 0);
    HAL_NVIC_EnableIRQ(ADC1_2_IRQn);
  }
}

void HAL_ADC_MspDeInit(ADC_HandleTypeDef* adcHandle)
{

  if(adcHandle->Instance==ADC1)
  {
    /* Peripheral clock disable */
    __HAL_RCC_ADC1_CLK_DISABLE();

    /**ADC1 GPIO Configuration
    PC0     ------> ADC1_IN10
    */
    HAL_GPIO_DeInit(GPIOC, GPIO_PIN_0);

    /* ADC1 interrupt Deinit */
  /* USER CODE BEGIN ADC1:ADC1_2_IRQn disable */
    /**
    * Uncomment the line below to disable the "ADC1_2_IRQn" interrupt
    * Be aware, disabling shared interrupt may affect other IPs
    */
    /* HAL_NVIC_DisableIRQ(ADC1_2_IRQn); */
  /* USER CODE END ADC1:ADC1_2_IRQn disable */

  }
  else if(adcHandle->Instance==ADC2)
  {
    /* Peripheral clock disable */
    __HAL_RCC_ADC2_CLK_DISABLE();

    /**ADC2 GPIO Configuration
    PC1     ------> ADC2_IN11
    */
    HAL_GPIO_DeInit(GPIOC, GPIO_PIN_1);

    /* ADC2 interrupt Deinit */
  /* USER CODE BEGIN ADC2:ADC1_2_IRQn disable */
    /**
    * Uncomment the line below to disable the "ADC1_2_IRQn" interrupt
    * Be aware, disabling shared interrupt may affect other IPs
    */
    /* HAL_NVIC_DisableIRQ(ADC1_2_IRQn); */
  /* USER CODE END ADC2:ADC1_2_IRQn disable */

  }
}

/* USER CODE BEGIN 1 */
/**************************************************************************
Function: ADC_IRQHandler
Input   : none
Output  : none
函数功能：电压读取ADC中断函数
入口参数: 无 
返回  值：无
**************************************************************************/	 
void HAL_ADC_ConvCpltCallback(ADC_HandleTypeDef* hadc)    //ADC转换完成回调
{
	u16 voltage;
	if(hadc==&hadc2)
	{
	  voltage=HAL_ADC_GetValue(&hadc2);//获取ADC转换的值
	  Get_Voltage=Max_Voltage/Max_Voltage_ADC*voltage*Ratio*100;//读取电压，放大100倍储存
	}
}

/**************************************************************************
Function: Get_Voltage
Input   : none
Output  : none
函数功能：获取ADC的值
入口参数: 无 
返回  值：无
**************************************************************************/	 
//获取ADC的值，主要用于车型的选择
u16 Get_Adc(u8 ch)   
{
	u16 result;
	ADC_ChannelConfTypeDef sConfig;//通道初始化
	sConfig.Channel=ch;
  sConfig.SamplingTime = ADC_SAMPLETIME_239CYCLES_5;		//采用周期239.5周期
	sConfig.Rank = 1;
	HAL_ADC_ConfigChannel(&hadc1,&sConfig);		
	
	HAL_ADC_Start(&hadc1);								//启动转换
	HAL_ADC_PollForConversion(&hadc1,30);				//等待转化结束
	if(HAL_IS_BIT_SET(HAL_ADC_GetState(&hadc1), HAL_ADC_STATE_REG_EOC))
	{
		result=HAL_ADC_GetValue(&hadc1);	//返回最近一次ADC1规则组的转换结果
	}
	return result;
}

/**************************************************************************
Function: According to the potentiometer switch needs to control the car type
Input   : none
Output  : none
函数功能：根据电位器切换需要控制的小车类型
入口参数：无
返回  值：无
**************************************************************************/
void Robot_Select(void)
{
	u8 Car_Select_Count = 0;
	u32 Car_Select_Sum = 0;				//车型选择ADC相关变量
	//The ADC value is variable in segments, depending on the number of car models. Currently there are 6 car models, CAR_NUMBER=6
  //ADC值分段变量，取决于小车型号数量
	//车型选择电位计，adc每10次取一次平均{
		for(Car_Select_Count=0;Car_Select_Count<2;Car_Select_Count++)
		{
			Car_Select_Sum += Get_Adc(CAR_ADC_CHANNEL);
			//delay_ms(1);
		}
		Car_Num = Car_Select_Sum/2/(Max_Car_ADC/Num_Of_Car);	//算出车型的号码
		Car_Select_Sum = 0;
	
}

/* USER CODE END 1 */

/************************ (C) COPYRIGHT STMicroelectronics *****END OF FILE****/
