MXDfc/ShanghaiTech_EE114-Embedded-Systems/Lab11and12/WHEELTEC L150(LD14P) 避障巡线小车源码_2026.04.13/WHEELTEC L150(LD14P) 避障巡线雷达小车标准库_2026.04.13/User/HARDWARE/usart/bsp_usart.c

/***********************************************
公司：轮趣科技（东莞）有限公司
品牌：WHEELTEC
官网：wheeltec.net
淘宝店铺：shop114407458.taobao.com 
速卖通: https://minibalance.aliexpress.com/store/4455017
版本：V1.0
修改时间：2023-03-02

Brand: WHEELTEC
Website: wheeltec.net
Taobao shop: shop114407458.taobao.com 
Aliexpress: https://minibalance.aliexpress.com/store/4455017
Version: V1.0
Update：2023-03-02

All rights reserved
***********************************************/
	
#include "./usart/bsp_usart.h"


/**************************************************************************
Function: DEBUG_USART_Init
Input   : none
Output  : none
函数功能：调试串口初始化
入口参数: 无 
返回  值：无
**************************************************************************/
//串口1
void DEBUG_USART_Init(void)
{

	GPIO_InitTypeDef GPIO_InitStructure;
	NVIC_InitTypeDef NVIC_InitStructure;
	USART_InitTypeDef USART_InitStructure;

	// 打开串口GPIO的时钟
	DEBUG_USART_GPIO_APBxClkCmd(DEBUG_USART_GPIO_CLK, ENABLE);

	// 打开串口外设的时钟
	DEBUG_USART_APBxClkCmd(DEBUG_USART_CLK, ENABLE);

	// 将USART Tx的GPIO配置为推挽复用模式
	GPIO_InitStructure.GPIO_Pin = DEBUG_USART_TX_GPIO_PIN;
	GPIO_InitStructure.GPIO_Mode = GPIO_Mode_AF_PP;
	GPIO_InitStructure.GPIO_Speed = GPIO_Speed_50MHz;
	GPIO_Init(DEBUG_USART_TX_GPIO_PORT, &GPIO_InitStructure);

	// 将USART Rx的GPIO配置为浮空输入模式
	GPIO_InitStructure.GPIO_Pin = DEBUG_USART_RX_GPIO_PIN;
	GPIO_InitStructure.GPIO_Mode = GPIO_Mode_IPU;
	GPIO_Init(DEBUG_USART_RX_GPIO_PORT, &GPIO_InitStructure);


	// 配置USART为中断源 
	NVIC_InitStructure.NVIC_IRQChannel = DEBUG_USART_IRQ;
	//抢断优先级
	NVIC_InitStructure.NVIC_IRQChannelPreemptionPriority = 1;
	//子优先级 
	NVIC_InitStructure.NVIC_IRQChannelSubPriority = 1;
	//使能中断 
	NVIC_InitStructure.NVIC_IRQChannelCmd = ENABLE;
	//初始化配置NVIC 
	NVIC_Init(&NVIC_InitStructure);
	
	
	// 配置串口的工作参数
	// 配置波特率
	USART_InitStructure.USART_BaudRate = DEBUG_USART_BAUDRATE;
	// 配置 针数据字长
	USART_InitStructure.USART_WordLength = USART_WordLength_8b;
	// 配置停止位
	USART_InitStructure.USART_StopBits = USART_StopBits_1;
	// 配置校验位
	USART_InitStructure.USART_Parity = USART_Parity_No ;
	// 配置硬件流控制
	USART_InitStructure.USART_HardwareFlowControl = 
	USART_HardwareFlowControl_None;
	// 配置工作模式，收发一起
	USART_InitStructure.USART_Mode = USART_Mode_Rx | USART_Mode_Tx;
	// 完成串口的初始化配置
	USART_Init(DEBUG_USARTx, &USART_InitStructure);

	// 使能串口接收中断
	USART_ITConfig(DEBUG_USARTx, USART_IT_RXNE, ENABLE);	

	// 使能串口
	USART_Cmd(DEBUG_USARTx, ENABLE);	    

}


/**************************************************************************
Function: BLUETOOTH_USART_Init
Input   : none
Output  : none
函数功能：蓝牙串口初始化
入口参数: 无 
返回  值：无
**************************************************************************/	 	
//串口3
void BLUETOOTH_USART_Init(void)
{

	GPIO_InitTypeDef GPIO_InitStructure;
	NVIC_InitTypeDef NVIC_InitStructure;
	USART_InitTypeDef USART_InitStructure;


	// 打开串口GPIO的时钟
	BLUETOOTH_USART_GPIO_APBxClkCmd(BLUETOOTH_USART_GPIO_CLK, ENABLE);
	
	// 打开串口外设的时钟
	BLUETOOTH_USART_APBxClkCmd(BLUETOOTH_USART_CLK, ENABLE);

	// 将USART Tx的GPIO配置为推挽复用模式
	GPIO_InitStructure.GPIO_Pin = BLUETOOTH_USART_TX_GPIO_PIN;
	GPIO_InitStructure.GPIO_Mode = GPIO_Mode_AF_PP;
	GPIO_InitStructure.GPIO_Speed = GPIO_Speed_50MHz;
	GPIO_Init(BLUETOOTH_USART_TX_GPIO_PORT, &GPIO_InitStructure);

  // 将USART Rx的GPIO配置为浮空输入模式
	GPIO_InitStructure.GPIO_Pin = BLUETOOTH_USART_RX_GPIO_PIN;
	GPIO_InitStructure.GPIO_Mode = GPIO_Mode_IN_FLOATING;
	GPIO_Init(BLUETOOTH_USART_RX_GPIO_PORT, &GPIO_InitStructure);	

	// 配置USART为中断源 
	NVIC_InitStructure.NVIC_IRQChannel = BLUETOOTH_USART_IRQ;
	//抢断优先级
	NVIC_InitStructure.NVIC_IRQChannelPreemptionPriority = 1;
	//子优先级 
	NVIC_InitStructure.NVIC_IRQChannelSubPriority = 1;
	//使能中断
	NVIC_InitStructure.NVIC_IRQChannelCmd = ENABLE;
	//初始化配置NVIC
	NVIC_Init(&NVIC_InitStructure);



	// 配置串口的工作参数
	// 配置波特率
	USART_InitStructure.USART_BaudRate = BLUETOOTH_USART_BAUDRATE;
	// 配置 针数据字长
	USART_InitStructure.USART_WordLength = USART_WordLength_8b;
	// 配置停止位
	USART_InitStructure.USART_StopBits = USART_StopBits_1;
	// 配置校验位
	USART_InitStructure.USART_Parity = USART_Parity_No ;
	// 配置硬件流控制
	USART_InitStructure.USART_HardwareFlowControl = 
	USART_HardwareFlowControl_None;
	// 配置工作模式，收发一起
	USART_InitStructure.USART_Mode = USART_Mode_Rx | USART_Mode_Tx;
	// 完成串口的初始化配置
	USART_Init(BLUETOOTH_USARTx, &USART_InitStructure);

	// 使能串口接收中断
	USART_ITConfig(BLUETOOTH_USARTx, USART_IT_RXNE, ENABLE);	

	// 使能串口
	USART_Cmd(BLUETOOTH_USARTx, ENABLE);	    

}
/**************************************************************************
Function: LIDAR_USART_Init
Input   : none
Output  : none
函数功能：雷达串口初始化
入口参数: 无 
返回  值：无
**************************************************************************/	 	
//串口5
void LIDAR_USART_Init(void)
{

	GPIO_InitTypeDef GPIO_InitStructure;
	NVIC_InitTypeDef NVIC_InitStructure;
	USART_InitTypeDef USART_InitStructure;


	// 打开串口GPIO的时钟
	LIDAR_USART_GPIO_APBxClkCmd(LIDAR_USART_GPIO_CLK, ENABLE);
	
	// 打开串口外设的时钟
	LIDAR_USART_APBxClkCmd(LIDAR_USART_CLK, ENABLE);

	// 将USART Tx的GPIO配置为推挽复用模式
	GPIO_InitStructure.GPIO_Pin = LIDAR_USART_TX_GPIO_PIN;
	GPIO_InitStructure.GPIO_Mode = GPIO_Mode_AF_PP;
	GPIO_InitStructure.GPIO_Speed = GPIO_Speed_50MHz;
	GPIO_Init(LIDAR_USART_TX_GPIO_PORT, &GPIO_InitStructure);

	// 将USART Rx的GPIO配置为浮空输入模式
	GPIO_InitStructure.GPIO_Pin = LIDAR_USART_RX_GPIO_PIN;
	GPIO_InitStructure.GPIO_Mode = GPIO_Mode_IN_FLOATING;
	GPIO_Init(LIDAR_USART_RX_GPIO_PORT, &GPIO_InitStructure);	

	//配置USART为中断源 
	NVIC_InitStructure.NVIC_IRQChannel = LIDAR_USART_IRQ;
	//抢断优先级
	NVIC_InitStructure.NVIC_IRQChannelPreemptionPriority = 1;
	//子优先级 
	NVIC_InitStructure.NVIC_IRQChannelSubPriority = 1;
	//使能中断 
	NVIC_InitStructure.NVIC_IRQChannelCmd = ENABLE;
	//初始化配置NVIC
	NVIC_Init(&NVIC_InitStructure);


	// 配置串口的工作参数
	// 配置波特率
	USART_InitStructure.USART_BaudRate = LIDAR_USART_BAUDRATE;
	// 配置 针数据字长
	USART_InitStructure.USART_WordLength = USART_WordLength_8b;
	// 配置停止位
	USART_InitStructure.USART_StopBits = USART_StopBits_1;
	// 配置校验位
	USART_InitStructure.USART_Parity = USART_Parity_No ;
	// 配置硬件流控制
	USART_InitStructure.USART_HardwareFlowControl = 
	USART_HardwareFlowControl_None;
	// 配置工作模式，收发一起
	USART_InitStructure.USART_Mode = USART_Mode_Rx | USART_Mode_Tx;
	// 完成串口的初始化配置
	USART_Init(LIDAR_USARTx, &USART_InitStructure);

	// 使能串口接收中断
	USART_ITConfig(LIDAR_USARTx, USART_IT_RXNE, ENABLE);	

	// 使能串口
	USART_Cmd(LIDAR_USARTx, ENABLE);	    

}
/**************************************************************************
Function: fputc
Input   : none
Output  : none
函数功能：重定向c库函数printf到串口
入口参数: 无 
返回  值：无
**************************************************************************/	 	
///重定向c库函数printf到串口，重定向后可使用printf函数
int fputc(int ch, FILE *f)
{
	if(Flag_Show==0)			//输出到串口1
	{
		/* 等待发送完毕 */
		while (USART_GetFlagStatus(DEBUG_USARTx, USART_FLAG_TXE) == RESET);		

		/* 发送一个字节数据到串口 */
		USART_SendData(DEBUG_USARTx, (uint8_t) ch);
		
		return (ch);
	}
	else					//使用printf输出到串口3
	{
		
		while (USART_GetFlagStatus(BLUETOOTH_USARTx, USART_FLAG_TXE) == RESET);		

		USART_SendData(BLUETOOTH_USARTx, (uint8_t) ch);
	
		return (ch);
		
	}
	
}


///重定向c库函数scanf到串口，重写向后可使用scanf、getchar等函数
int fgetc(FILE *f)
{
		/* 等待串口输入数据 */
		while (USART_GetFlagStatus(DEBUG_USARTx, USART_FLAG_RXNE) == RESET);

		return (int)USART_ReceiveData(DEBUG_USARTx);
}
