MXDfc/ShanghaiTech_EE114-Embedded-Systems/Lab6/WHEELTEC L150 避障巡线雷达小车资料/L150-避障巡线雷达小车-C10B-HAL库-20250507/Inc/adc.h

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
/* Define to prevent recursive inclusion -------------------------------------*/
#ifndef __ADC_H__
#define __ADC_H__

#ifdef __cplusplus
extern "C" {
#endif

/* Includes ------------------------------------------------------------------*/
#include "main.h"

extern ADC_HandleTypeDef hadc1;

extern ADC_HandleTypeDef hadc2;

/* USER CODE BEGIN Private defines */
#define    CAR_ADC_CHANNEL                  ADC_CHANNEL_10
#define    ELE_ADC_L_CHANNEL					 ADC_CHANNEL_4
#define    ELE_ADC_M_CHANNEL					 ADC_CHANNEL_5
#define    ELE_ADC_R_CHANNEL					 ADC_CHANNEL_15
#define    CCD_ADC_CHANNEL					 	 ADC_CHANNEL_15

#define Max_Voltage   				3.3f

#define Max_Voltage_ADC				4095

#define Ratio 						11

#define Max_Car_ADC					2047
#define Num_Of_Car					4
/* USER CODE END Private defines */

void MX_ADC1_Init(void);
void MX_ADC2_Init(void);

/* USER CODE BEGIN Prototypes */
u16 Get_Adc(u8 ch);
void Robot_Select(void);
u16 Get_Voltage(void);
/* USER CODE END Prototypes */

#ifdef __cplusplus
}
#endif

#endif /* __ADC_H__ */
