MXDfc/ShanghaiTech_EE114-Embedded-Systems/Lab11and12/WHEELTEC L150(LD14P) 避障巡线小车源码_2026.04.13/WHEELTEC L150(LD14P) 避障巡线雷达小车HAL库_2026.04.13/HAREWARE/Inc/pstwo.h

/***********************************************
公司：轮趣科技（东莞）有限公司
品牌：WHEELTEC
官网：wheeltec.net
淘宝店铺：shop114407458.taobao.com 
速卖通: https://minibalance.aliexpress.com/store/4455017
版本：V1.0
修改时间：2023-03-02

Brand: WHEELTEC
Website: wheeltec.net
Taobao shop: shop114407458.taobao.com 
Aliexpress: https://minibalance.aliexpress.com/store/4455017
Version: V1.0
Update：2023-03-02

All rights reserved
***********************************************/

#ifndef __PSTWO_H
#define __PSTWO_H

#include "Header.h"



#define DI      HAL_GPIO_ReadPin(GPIOB,GPIO_PIN_8)          	//  输入
			    
#define DO_H    HAL_GPIO_WritePin(GPIOC,GPIO_PIN_9,GPIO_PIN_SET)        	//命令位高
#define DO_L    HAL_GPIO_WritePin(GPIOC,GPIO_PIN_9,GPIO_PIN_RESET)        	//命令位低
			    
#define CS_H    HAL_GPIO_WritePin(GPIOC,GPIO_PIN_4,GPIO_PIN_SET)       	//CS拉高
#define CS_L    HAL_GPIO_WritePin(GPIOC,GPIO_PIN_4,GPIO_PIN_RESET)       	//CS拉低
			    
#define CLK_H   HAL_GPIO_WritePin(GPIOC,GPIO_PIN_8,GPIO_PIN_SET)      	//时钟拉高
#define CLK_L   HAL_GPIO_WritePin(GPIOC,GPIO_PIN_8,GPIO_PIN_RESET)      	//时钟拉低




//按键序号
#define PSB_SELECT      1
#define PSB_L3          2
#define PSB_R3          3
#define PSB_START       4
#define PSB_PAD_UP      5
#define PSB_PAD_RIGHT   6
#define PSB_PAD_DOWN    7
#define PSB_PAD_LEFT    8
#define PSB_L2          9
#define PSB_R2          10
#define PSB_L1          11
#define PSB_R1          12
#define PSB_GREEN       13
#define PSB_RED         14
#define PSB_BLUE        15
#define PSB_PINK        16

#define PSB_TRIANGLE    13
#define PSB_CIRCLE      14
#define PSB_CROSS       15
#define PSB_SQUARE      16

//#define WHAMMY_BAR		8

//These are stick values
#define PSS_RX 5                //右摇杆X轴数据
#define PSS_RY 6
#define PSS_LX 7
#define PSS_LY 8

extern u8 Data[9];
extern u16 MASK[16];
extern u16 Handkey;
extern int PS2_LX,PS2_LY,PS2_RX,PS2_RY,PS2_KEY; 

void PS2_Init(void);
u8 PS2_RedLight(void);  	 		//判断是否为红灯模式
void PS2_ReadData(void); 			//读手柄数据
void PS2_Cmd(u8 CMD);		  		//向手柄发送命令
u8 PS2_DataKey(void);		  		//按键值读取
u8 PS2_AnologData(u8 button); 		//得到一个摇杆的模拟量
void PS2_ClearData(void);	  		//清除数据缓冲区
void PS2_Vibration(u8 motor1, u8 motor2);//振动设置motor1  0xFF开，其他关，motor2  0x40~0xFF

void PS2_EnterConfing(void);	 	//进入配置
void PS2_TurnOnAnalogMode(void); 	//发送模拟量
void PS2_VibrationMode(void);    	//振动设置
void PS2_ExitConfing(void);	     	//完成配置
void PS2_SetInit(void);		     	//配置初始化
void PS2_Read(void);

#endif
