MXDfc/ShanghaiTech_EE114-Embedded-Systems/Lab6/WHEELTEC L150 避障巡线雷达小车资料/L150-避障巡线雷达小车-C10B-HAL库-20250507/HAREWARE/bsp_beep.c

/***********************************************
公司：轮趣科技（东莞）有限公司
品牌：WHEELTEC
官网：wheeltec.net
淘宝店铺：shop114407458.taobao.com 
速卖通: https://minibalance.aliexpress.com/store/4455017
版本：V1.0
修改时间：2023-03-02

Brand: WHEELTEC
Website: wheeltec.net
Taobao shop: shop114407458.taobao.com 
Aliexpress: https://minibalance.aliexpress.com/store/4455017
Version: V1.0
Update：2023-03-02

All rights reserved
***********************************************/
  
#include "bsp_beep.h"   

/**************************************************************************
Function: Set JTAG mode
Input   : mode:JTAG, swd mode settings；00，all enable；01，enable SWD；10，Full shutdown
Output  : none
函数功能：设置JTAG模式
入口参数：mode:jtag,swd模式设置;00,全使能;01,使能SWD;10,全关闭;	
返回  值：无
**************************************************************************/
//#define JTAG_SWD_DISABLE   0X02
//#define SWD_ENABLE         0X01
//#define JTAG_SWD_ENABLE    0X00	
void JTAG_Set(u8 mode)
{
	u32 temp;
	temp=mode;
	temp<<=25;
	RCC->APB2ENR|=1<<0;     //开启辅助时钟	   
	AFIO->MAPR&=0XF8FFFFFF; //清除MAPR的[26:24]
	AFIO->MAPR|=temp;       //设置jtag模式
} 



/**************************************************************************
Function: Buzzer_Alarm
Input   : Indicates the count of frequencies
Output  : none
函数功能：蜂鸣器报警
入口参数: 指示频率的计数 
返回  值：无
**************************************************************************/	 	
//在中断函数调用
void Buzzer_Alarm(u16 count)
{
	static int count_time;
	if(0 == count)
	{
		BEEP_OFF();
	}
	else if(++count_time >= count)
	{
		BEEP_TOGGLE();
		count_time = 0;	
	}
}
