MXDfc/ShanghaiTech_EE114-Embedded-Systems/Lab2and3/Device Data/AI语音交互/1.教程资料/4 STM32通信/4.4.1 STM32语音识别例程/01 STM32F103/02 程序文件/STM32F103_Asr_recognition/USER/ADC.h

#ifndef _ADC_H_
#define _ADC_H_

#define ADC_BAT		13		//电池电压的AD检测通道
#define BUZZER 		PCout(13)
#define LED PBout(9)

void InitADC(void);
void InitLED(void);
void InitBuzzer(void);

void Buzzer(void);
void CheckBatteryVoltage(void);
u16 GetBatteryVoltage(void);
uint16 GetADCResult(BYTE ch);



#endif
