MXDfc/ShanghaiTech_EE114-Embedded-Systems/Lab2and3/Device Data/AI语音交互/1.教程资料/4 STM32通信/4.4.1 STM32语音识别例程/01 STM32F103/02 程序文件/STM32F103_Asr_recognition/USER/adxl345.h

#define __ADXL345_H
/************************************************
	ADXL345数字加速度说明文件
描述    : ADXL345数字加速度.h文件
功能    : 声明函数以及相关接口的声明
硬件说明: STM32F103RB单片机,配合8MHz晶振
Author  : ROC
Time    : 2018.5.30
说明    : 详细的定义请看函数实现
************************************************/
u8 read_data(void);
