MXDfc/ShanghaiTech_EE114-Embedded-Systems/(commit log)

2026-04-19 Revise README for device information updates
    Updated README to include information about device updates.
2026-04-19 Added device data for the board used in the class (schematic diagram) at the root menu; added device data for lab 4 and 5
2026-04-19 Added device data for lab 2 and 3
    [2.2 命令词播报词协议列表.xlsx, 2.3 命令词播报词协议列表_中文.xlsx, 2.4 命令词播报词协议列表_英文.xlsx, 5.1.2 命令词播报词协议列表.xlsx, 5.2.2 命令词播报词协议列表.xlsx, 5.3.2 命令词播报词协议列表V3_中文.xlsx, 5.4.2 命令词播报词协议列表V3_中文.xlsx]
2026-05-05 added files for lab4 and lab5 submission
    Original-Commit: 2c1da6cea93b9d0d7e5643d987a613ab7d02fa8c
    Archive-Filter: course videos omitted
2026-05-05 Added lab6 basic information and database
    Original-Commit: b4abf99277480441691aeaef535458840dd325eb
    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
2026-05-30 Baseline Lab9and10 initial version
    Original-Commit: c592ed5055f3be4539305bcaecc5f7aa96404794
    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
2026-05-31 Archive working Lab9and10 ultrasonic solution
    Original-Commit: b90addc5425572ba67cc47b81a04daf0618bbcb5
    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
2026-05-31 Add FinalExhibition L150 project
    Original-Commit: be15908bc6f7d1ea3f81a180bbb4ddf9dbe9ca95
    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
2026-05-31 Integrate HC-SR04 driver into L150 project
    Original-Commit: fd13877286535c0eead09c50d227b76ccd44521c
    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
2026-05-31 Fix printf serial redirection
    Original-Commit: e630495866fa9aac94ea3f028e82da3ef83098e2
    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
2026-05-31 Align printf UART transmit path
    Original-Commit: eeeddf2d49ed11ed15b80e5f8f0876efd3fcf09b
    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
2026-05-31 Switch printf to USART3 at 9600
    Original-Commit: 80013cbd69bb62075376be15d7117e8aa0c2b7a5
    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
2026-05-31 Mirror B-style USART1 printf path
    Original-Commit: a5c4b9cc494c7c7e949c97eb4df3c2bc6c5a2c3c
    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
2026-05-31 Fix USART1 RX flag constant
    Original-Commit: ed530647532c71719da045f83a62e71a7bfbc913
    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
2026-05-31 Refine L150 ultrasonic distance streaming
    Original-Commit: bc2db4e6f2259946e234146c1e486c20acb7f937
    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
2026-06-01 Save auto scan baseline
    Original-Commit: 35b30f15dda8a3a0f9eac749f185c85642f189a8
    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
2026-06-10 Update Lab9 and 10 auto scan
    Original-Commit: b667d4b6f175a87a955e8e927bb28d925243dccd
    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
2026-06-13 Add Lab11 and 12 laser radar materials
    Original-Commit: 6422e620cb730e19efd4a9830d2cf05cab9c0438
    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
2026-06-14 Add Lab11 and 12 laser radar materials
2026-06-16 Add LabProject smart cruise car
    Original-Commit: 91d8f7f33dc640b33d5c081ed6854202b150ac30
    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
2026-06-17 Add lidar mapping navigation mode
