MXDfc/ShanghaiTech_EE114-Embedded-Systems/(notices)

Notices in the files:
Lab4and5/Core/Src/main.c:
Copyright (c) 2026 STMicroelectronics.
All rights reserved.
This software is licensed under terms that can be found in the LICENSE file
Lab6/WHEELTEC L150 避障巡线雷达小车资料/L150-避障巡线雷达小车-C10B-HAL库-20250507/Inc/adc.h:
Copyright (c) 2025 STMicroelectronics.
